hdsjulian/sparkles/sparkles-api/protocol.md

# Sparkles Serial Protocol

Bidirectional JSON frames over USB CDC serial (`/dev/ttyACM0`, 115200 baud).
Each frame is a single line of JSON terminated by `\n`.

---

## Pi → ESP32 (Commands)

Every command frame has at minimum `{"cmd": "<name>", ...params}`.

| cmd | params | description |
|-----|---|---|
| `animate_toggle` | — | start/stop animation loop |
| `animation_off` | — | stop all animations |
| `blink` | `boardId: int` | blink one board |
| `blink_all` | — | blink all boards |
| `sync` | `index: int` | sync one board |
| `sync_all` | — | sync all boards |
| `submit_positions` | `boardId, xpos, ypos` | set board position |
| `set_time` | `year, month, day, hours, minutes, seconds` | set RTC |
| `set_sleep_time` | `hours, minutes, seconds` | schedule sleep |
| `set_sound_speed` | `mps: float` | speed of sound for turning flight times into distances, from the air temperature on the pi; kept in NVS, re-sent on every connect, answered with `sound_speed` |
| `set_speaker_delay` | `us: int` | the speaker's own delay, taken off every calibration chirp (not off latency tests); kept in NVS, re-sent by the pi on every connect, answered with `speaker_delay` |
| `set_wakeup_time` | `hours, minutes, seconds` | schedule wakeup |
| `set_midi_params` | `minVal, maxVal, minSat, maxSat, midiHue, midiSaturation, rangeMin, rangeMax, minDb, maxDb, mode, distance, distanceSwitch, distanceMode, distanceEdge` | MIDI params. `mode` 1 = MIDI, 2 = frequency. `distance` is the shimmer falloff radius in m, 0 = the calibrated max. `distanceMode` 0 = brightness, 1 = delay. `distanceEdge` (optional, 50 if missing) is the brightness at that radius in % of the centre's. Held in RAM on the master, so the pi stores them and re-sends on every connect |
| `set_darkroom_params` | `strobeMin, strobeMax, redlightMin, redlightMax, candlelightMin, candlelightMax, redLightEnabled, candleLightEnabled` | darkroom params |
| `get_address_list` | — | request address list |
| `get_midi_params` | — | request MIDI params |
| `get_darkroom_params` | — | request darkroom params |
| `get_system_info` | — | request system info |
| `health_ping` | `boardId: int` | ask one board for its vitals (`-1` = whole fleet at once) |
| `calibration_start` | — | start calibration |
| `calibration_cancel` | — | cancel calibration |
| `calibration_reset` | — | reset calibration |
| `calibration_continue` | `x: float, y: float` | continue with clap position |
| `calibration_end` | — | end calibration |
| `calibration_test` | — | test calibration |
| `calibration_calibrate` | `boardId: int` | calibrate one board |
| `dist_cal_start` | — | start distance calibration |
| `dist_cal_continue` | — | continue distance calibration |
| `dist_cal_end` | — | end distance calibration |
| `dist_cal_cancel` | — | cancel distance calibration |
| `dist_cal_abort` | — | abort distance calibration |
| `ota_update` | — | start OTA update. Send `set_ota_wifi` and `set_ota_url` first — they travel to the clients with the request |
| `ota_board` | `boardId: int` | send just this board off to update, answered with `ota_sent`. The pi's rollout uses it to keep only a few boards away at once |
| `set_ota_url` | `url: str` | where the firmware image lives, i.e. this pi |
| `set_ota_wifi` | `ssid: str, password: str` | the network clients should join for an OTA — the one the pi is currently on |
| `toggle_test_mode` | — | toggle test mode |
| `toggle_logging` | — | toggle serial logging |
| `reannounce` | — | broadcast reannounce |
| `reset_system` | — | reset system (wipes client list) |
| `factory_reset` | — | factory reset & reboot |

---

## ESP32 → Pi (Events)

Every event frame has `{"event": "<name>", ...data}`.

| event | data | description |
|---|---|---|
| `address_list` | `numDevices, addresses: [{id,address,status,batteryPercentage,distance,xpos,ypos,lastUpdateTime,timerOffset,delay}]` | full address list |
| `update_board` | same address object | single board updated — sent when it changes, no longer repeated every 5 s |
| `status` | `boards, active, animating, animation, heap, minHeap, uptime, speakerDelay, soundSpeed, dropped` | the master's one line every 5 s; `dropped` counts lines its serial queue had no room for |
| `speaker_delay` | `us: int` | reply to `set_speaker_delay` |
| `sound_speed` | `mps: float` | reply to `set_sound_speed` |
| `animate_status` | `status: bool, animation` | reply to `get_animate_status` / `animate_toggle` |
| `calibration_status` | `status: int, [clapId, clapTime]` | calibration progress |
| `distance_status` | `status: int, [clapId, clapTime]` | distance cal progress |
| `client_clap` | `clapId, boardId, clapDistance` | clap received from client |
| `chirp_distance` | `boardId, slot, distance, kept, chirps` | one board's averaged distance to a chirp spot, sent as its batch finishes; a distance calibration sends the board's `update_board` right after it, so nothing is left for the end but the `done` |
| `num_devices` | `numDevices: int` | old firmware's 5 s count, now part of `status` |
| `sync_status` | `status: str` | sync progress |
| `midi_params` | `minVal, maxVal, ...` | MIDI params response |
| `darkroom_params` | `strobeMin, strobeMax, ...` | darkroom params response |
| `system_info` | `systemTime, sleepSet, sleepIn, sleepAtH, sleepAtM, sleepAtS, sleepDuration` | system info response |
| `client_health` | `boardId, reportedId, batteryPercentage, freeHeap, minFreeHeap, uptimeS, rssi, resetReason, version` | one client's reply to `health_ping`. `rssi` is stamped by the master from the frame that carried it; a board that never answers sends nothing at all, so silence is the only signal that it is gone |
| `ota_sent` | `boardId: int, ok: bool` | reply to `ota_board`; `ok` false means the master has no address for that board |
| `test_mode` | `testMode: bool` | test mode toggled |
| `logging` | `logging: bool` | logging toggled |
| `ack` | `cmd: str, ok: bool, [msg: str]` | generic command acknowledgement |
