hdsjulian/sparkles/casing/insertflip.stl

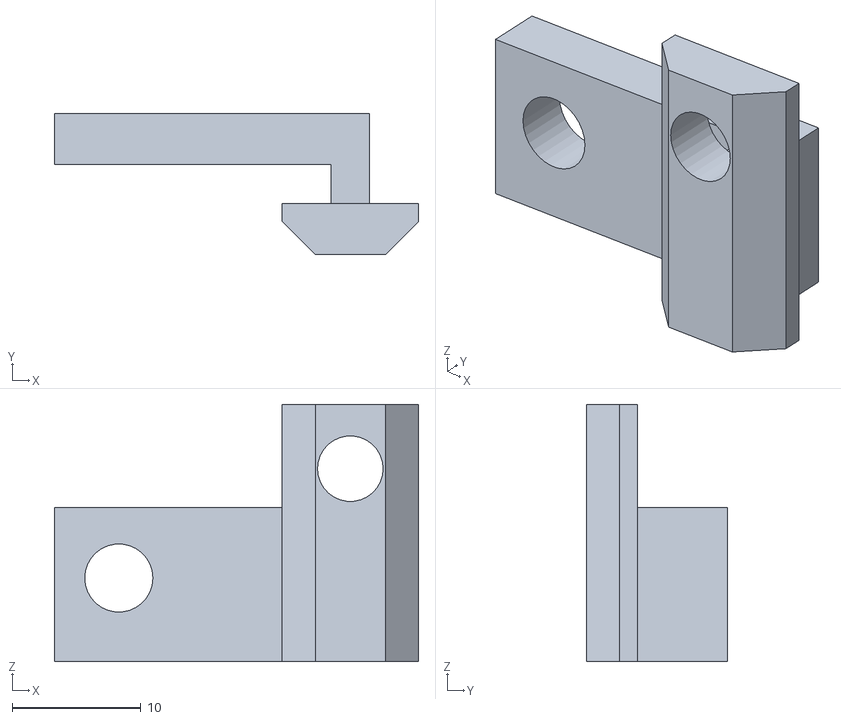
[picture p1: CAD file, 2025-11-23]
casing/insertflip.stl
28.3 x 11.0 x 20.0
