hdsjulian/sparkles/casing/base_v5.stl

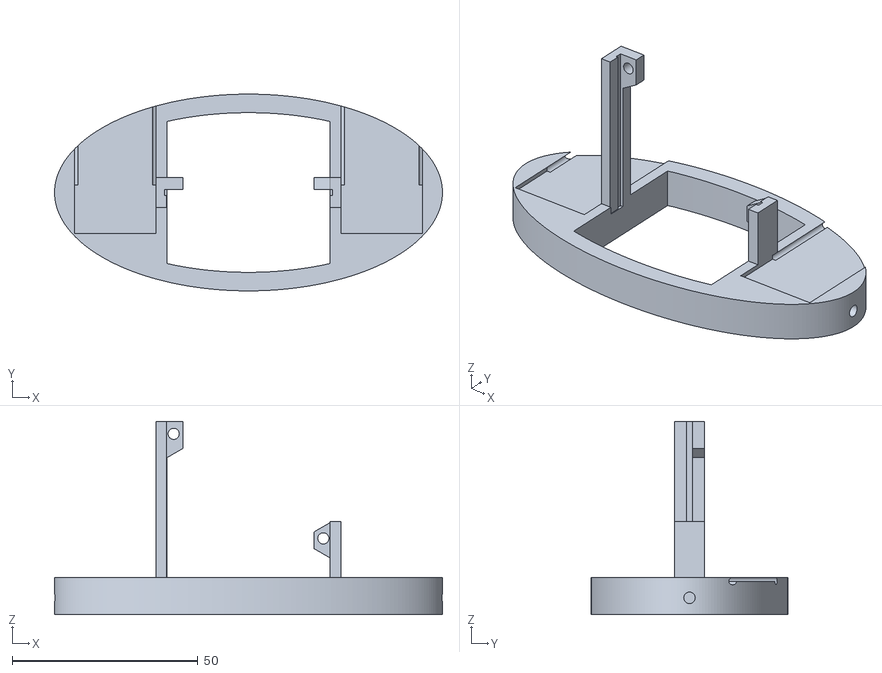
[picture p2: CAD file, 2025-11-23]
casing/base_v5.stl
104.5 x 53.0 x 52.0
