hdsjulian/sparkles/casing/battery_casing.stl

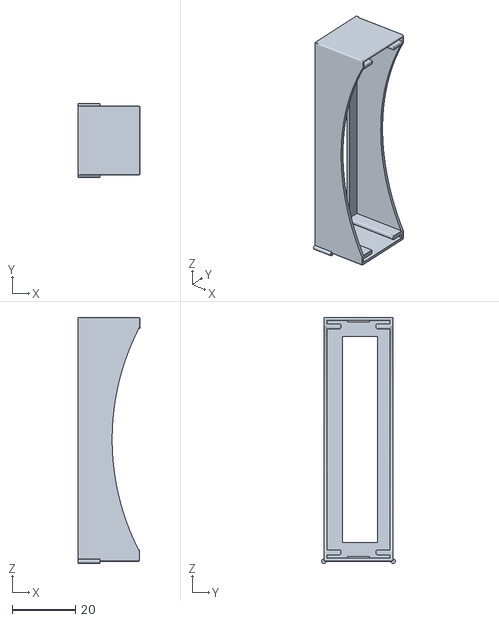
[picture p3: CAD file, 2025-08-04]
casing/battery_casing.stl
19.7 x 23.4 x 77.9
