hdsjulian/sparkles/casing/base_v4_final_2.stl

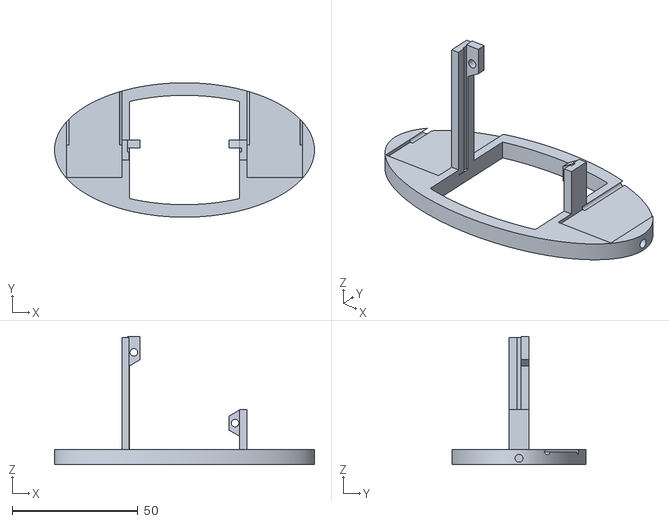
[picture p4: CAD file, 2025-08-04]
casing/base_v4_final_2.stl
103.5 x 53.5 x 51.0
