hdsjulian/sparkles/casing/wandhalterung.stl

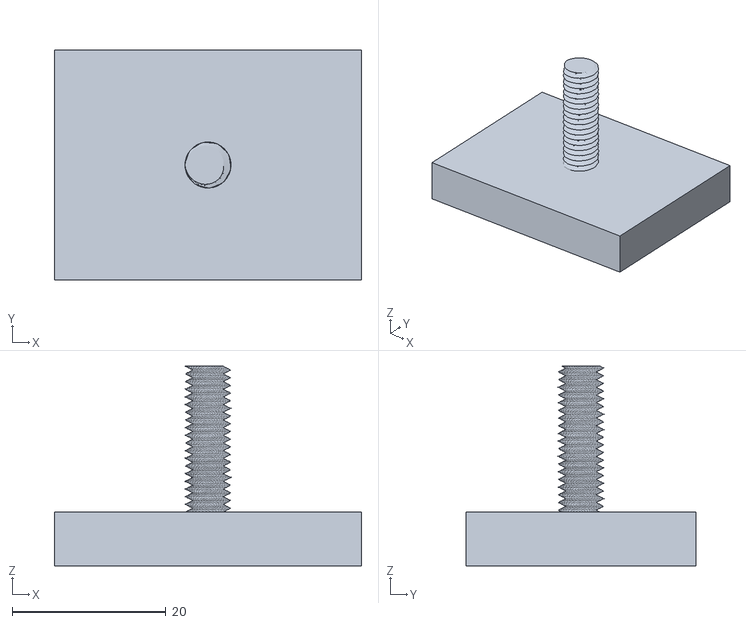
[picture p5: CAD file, 2025-08-04]
casing/wandhalterung.stl
40.0 x 30.0 x 26.0
