hdsjulian/sparkles/casing/newbase.stl

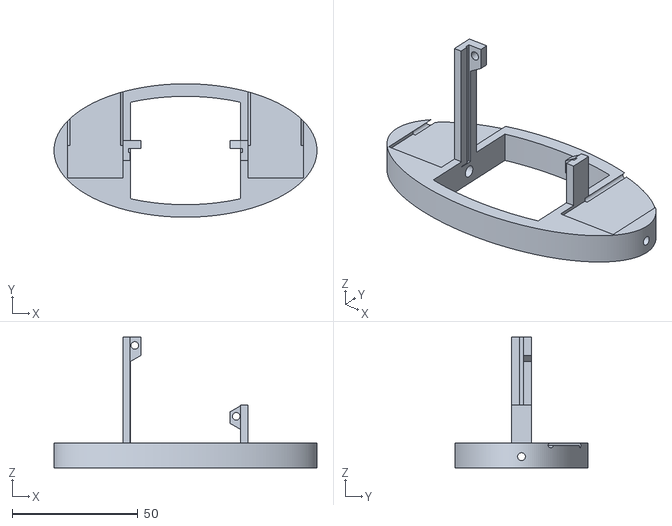
[picture p6: CAD file, 2025-08-04]
casing/newbase.stl
104.5 x 53.0 x 52.0
