hdsjulian/sparkles/casing/2h_battery_casing.3mf

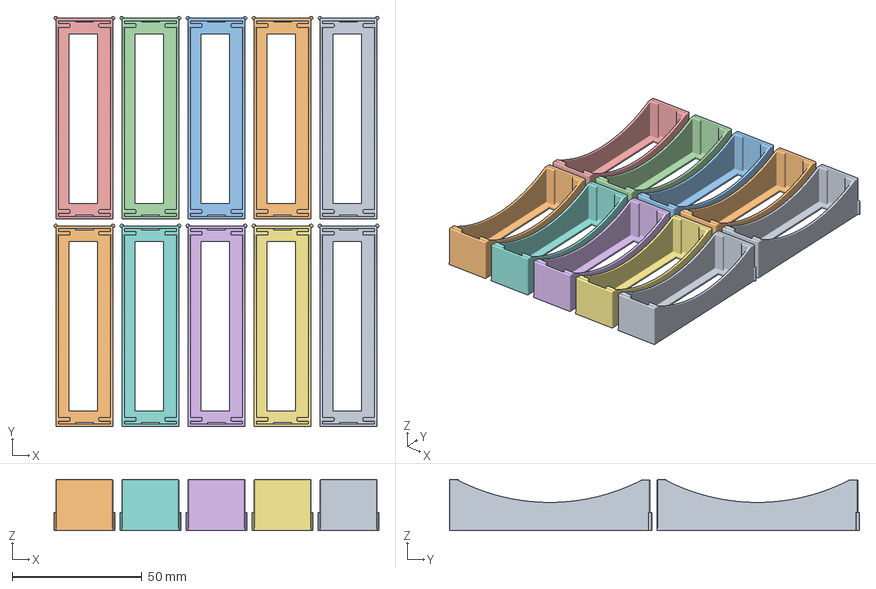
[picture p7: CAD file, 2025-08-04]
casing/2h_battery_casing.3mf
125.0 x 157.8 x 19.7 mm
battery_casing.stl 6
battery_casing.stl 9 x 2
battery_casing.stl 13 x 2
battery_casing.stl 5
battery_casing.stl 4 x 2
battery_casing.stl 11 x 2
