hdsjulian/sparkles/casing/bottom_v1.stl

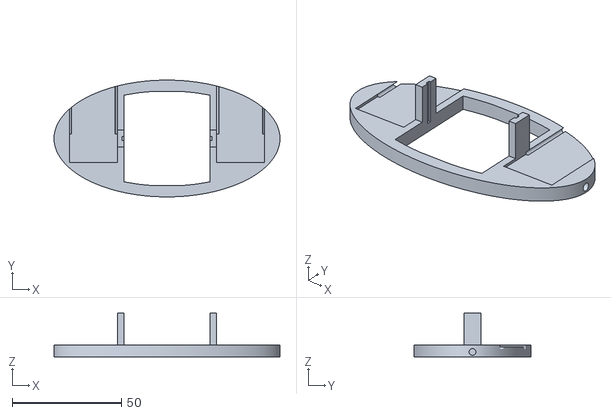
[picture p8: CAD file, 2025-08-04]
casing/bottom_v1.stl
103.5 x 53.5 x 20.0
