hdsjulian/sparkles/casing/max_battery_casing.3mf

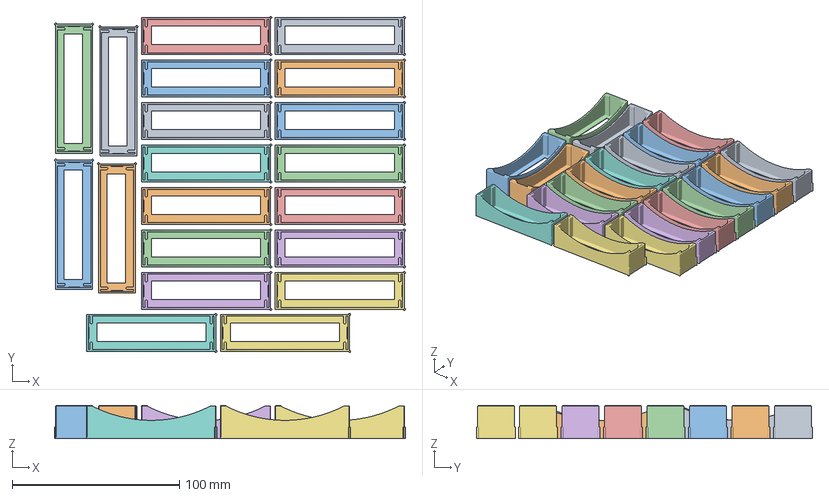
[picture p9: CAD file, 2025-08-04]
casing/max_battery_casing.3mf
209.8 x 200.9 x 19.7 mm
battery_casing.stl
battery_casing.stl 1
battery_casing.stl 2
battery_casing.stl 3
battery_casing.stl 4
battery_casing.stl 5
battery_casing.stl 6
battery_casing.stl 7
battery_casing.stl 8
battery_casing.stl 9
battery_casing.stl 10
battery_casing.stl 11
battery_casing.stl 12
battery_casing.stl 13
battery_casing.stl 14
battery_casing.stl 15 x 5
