hdsjulian/sparkles/casing/newcasing_thick.stl

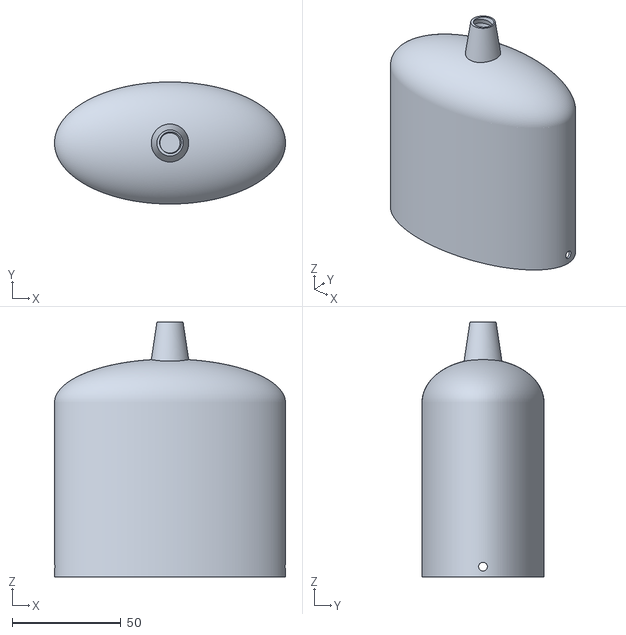
[picture p10: CAD file, 2025-08-04]
casing/newcasing_thick.stl
106.0 x 56.0 x 117.0
