hdsjulian/sparkles/casing/notch.stl

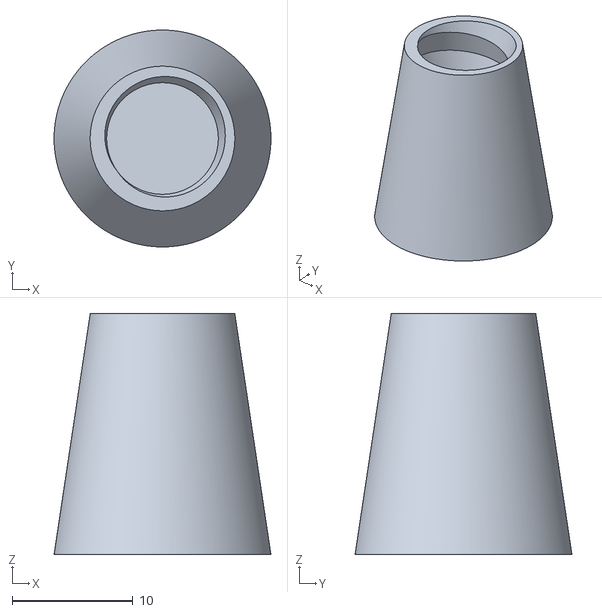
[picture p11: CAD file, 2025-08-04]
casing/notch.stl
18.0 x 18.0 x 20.0
