hdsjulian/sparkles/casing/TopV2.stl

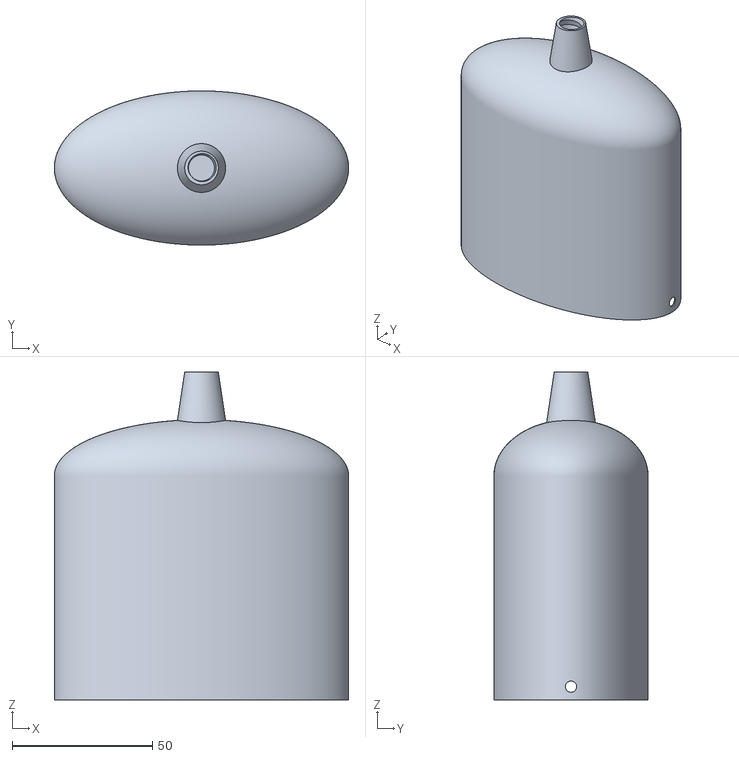
[picture p12: CAD file, 2025-08-04]
casing/TopV2.stl
105.0 x 55.0 x 117.0
