hdsjulian/sparkles/casing/notchtest.stl

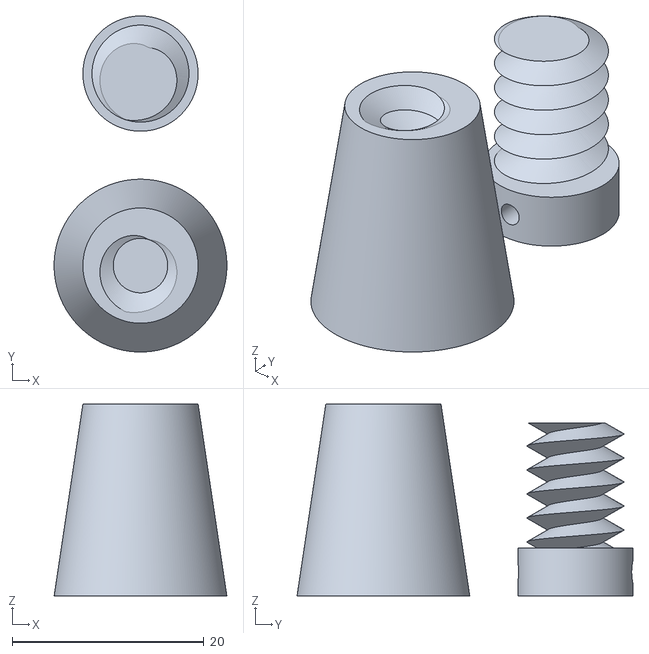
[picture p13: CAD file, 2025-08-04]
casing/notchtest.stl
18.0 x 35.0 x 20.0
