hdsjulian/sparkles/casing/cover_new.stl

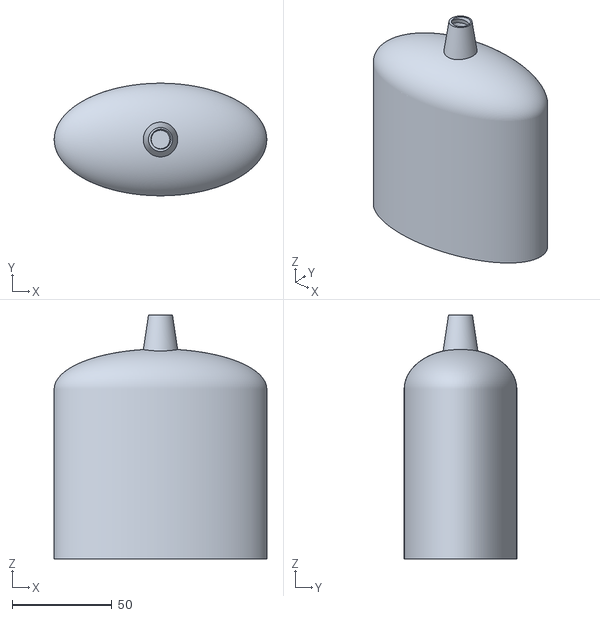
[picture p14: CAD file, 2025-08-04]
casing/cover_new.stl
106.3 x 56.3 x 122.0
