hdsjulian/sparkles/casing/casingtest.stl

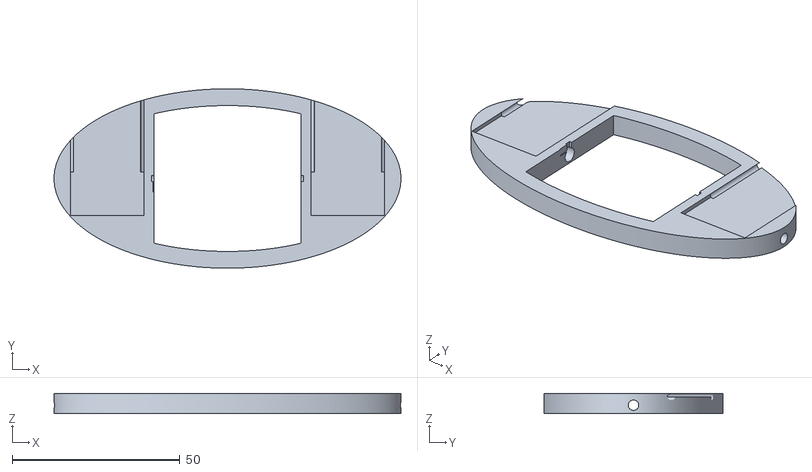
[picture p15: CAD file, 2025-08-04]
casing/casingtest.stl
103.5 x 53.5 x 6.00
