hdsjulian/sparkles/casing/casingsmallertest.stl

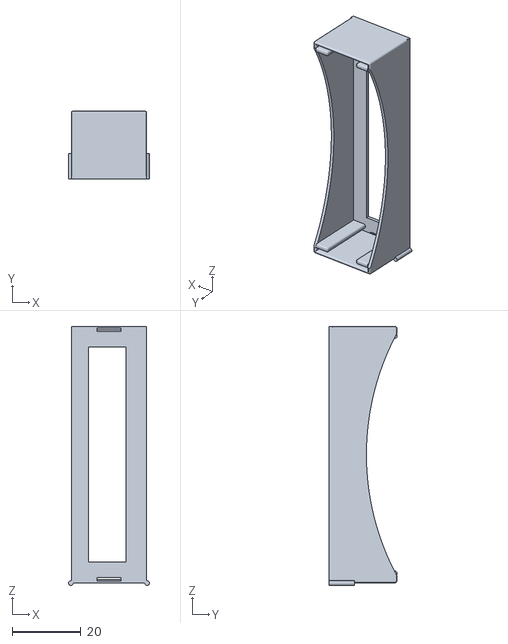
[picture p16: CAD file, 2025-08-04]
casing/casingsmallertest.stl
23.6 x 19.7 x 75.5
