hdsjulian/sparkles/casing/newcasing.stl

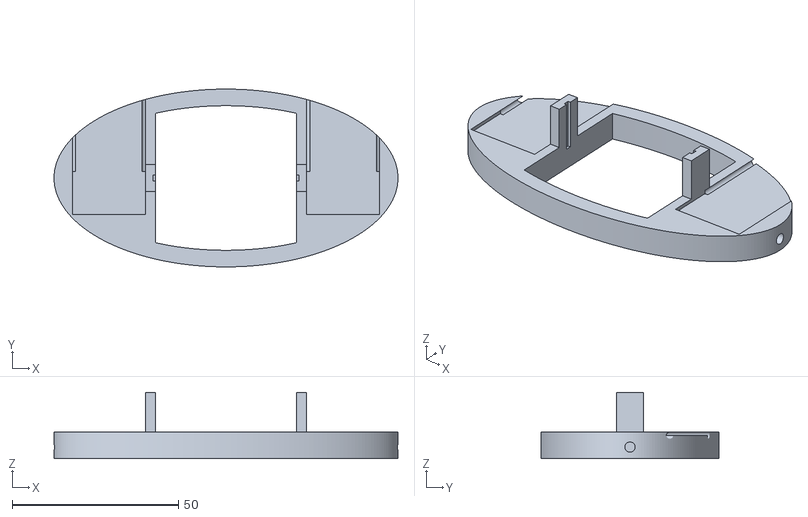
[picture p17: CAD file, 2025-08-04]
casing/newcasing.stl
103.5 x 53.5 x 20.0
