hdsjulian/sparkles/casing/base_v4_test.stl

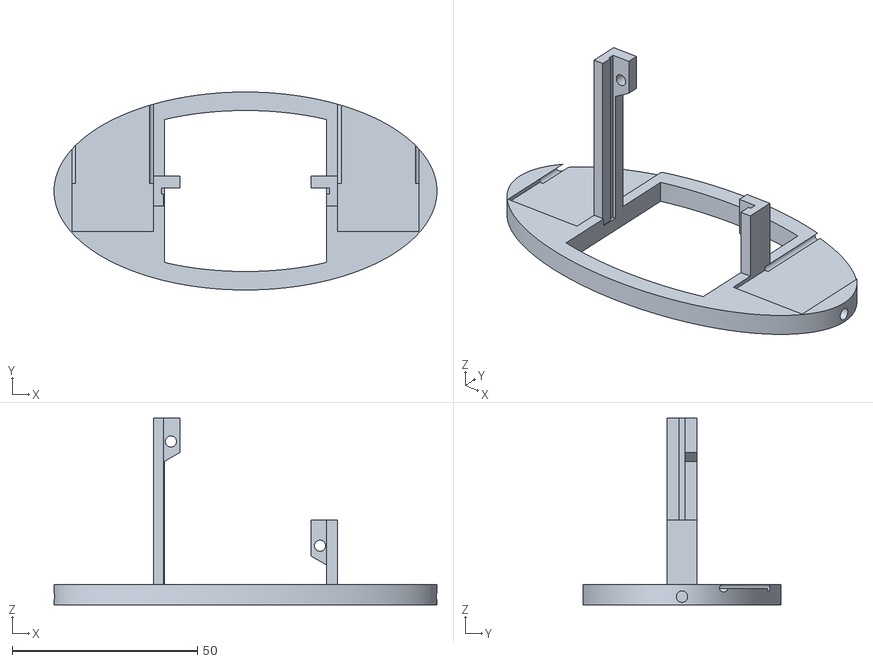
[picture p19: CAD file, 2025-08-04]
casing/base_v4_test.stl
103.5 x 53.5 x 50.5
