hdsjulian/sparkles/casing/carrier.stl

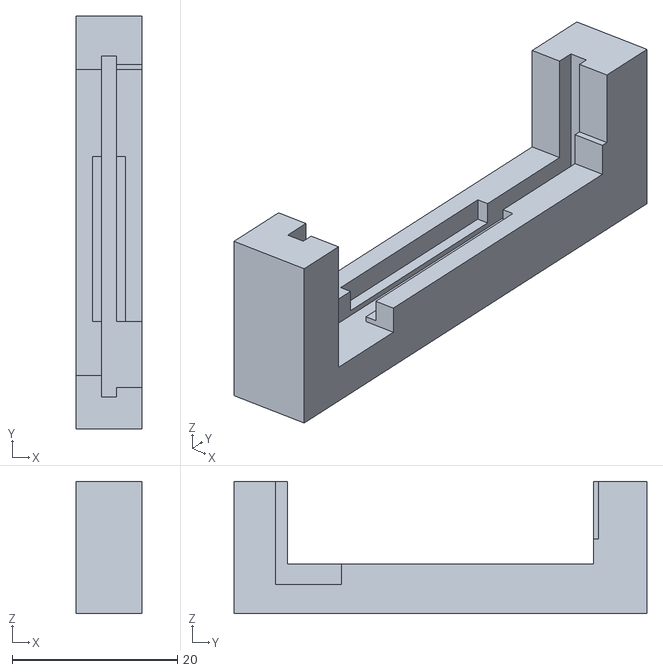
[picture p20: CAD file, 2025-08-04]
casing/carrier.stl
8.00 x 50.0 x 16.0
