hdsjulian/sparkles/casing/gehaeuse.stl

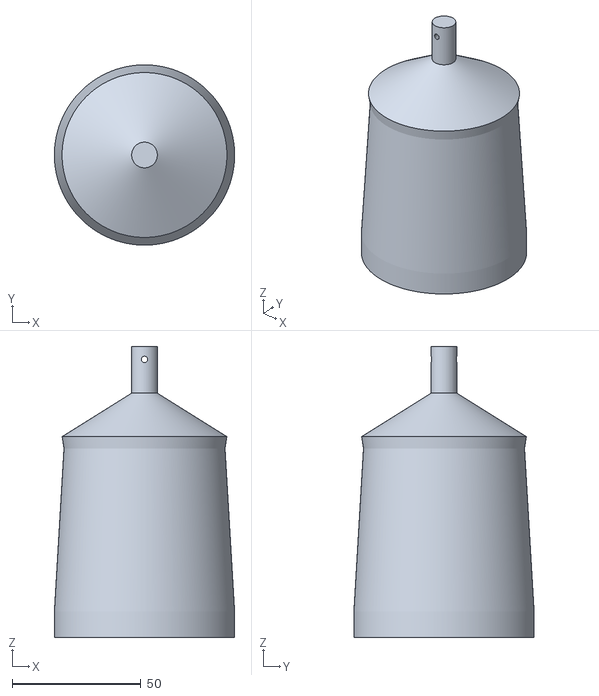
[picture p21: CAD file, 2025-08-04]
casing/gehaeuse.stl
70.0 x 70.0 x 113.0
