hdsjulian/sparkles/casing/screw.scad

include <cyl_head_bolt.scad>;
$fn=60;		    
screw("M3x12");    
