hdsjulian/sparkles/casing/wandhalterung.scad

include <cyl_head_bolt.scad>;

$width = 40;
$height = 30;
$screw_height = 25;

screw("M6x15");
