hdsjulian/sparkles/(list of files, cad)

Other CAD files:
casing/insert.stl
casing/newbase_smaller.stl
casing/battery_casing_smaller.stl
casing/base.stl
casing/base_v2.stl
casing/base_v3.stl
casing/base_v3_test.stl
casing/base_v4.stl
casing/bottom_v3_screwhole.stl
casing/cyl_head_bolt.scad
casing/data-access.scad
casing/data-metric_cyl_head_bolts.scad
casing/m3screw.stl
casing/materials.scad
casing/roundedcube.scad
casing/screw.stl
casing/screw_v2.stl
casing/threads.scad
