hdsjulian/sparkles/(threads)

Thread 2 (2023-08-25):

Figure out the finalized BOM list

hdsjulian, 2023-08-25:
So far:
- 1 large LED for each side
- Pin headers to attach an ESP board (final board needs to be set)
- 2 pin JST connector (for battery)
- switch (turn on device)
- smd microphone
- lipo charging infrastructure (what is needed?)
- MAYBE: button (switch modes?)

Thread 3 (2023-08-25):

PCB Design (technical)

hdsjulian, 2023-08-25:
Design PCB.
Requirements:

- Has one LED on each side
- Has pin-headers on back side to attach an ESP Board (which one needs to be finalized)
- has SMD microphone on front side
- Has switch on side of the pcb
- has two notches (distance 16.5mm) that allows the board to be set on model rails (H0) for charging

Closed 2024-01-26.

Thread 8 (2023-08-27):

Figure out which LED

hdsjulian, 2023-08-27:
Optimally; One LED on each side, largest possible angle. As much 'bang for a buck' as possible, meaning that more wattage equals better.
As we basically only have to run 3 or 4 channels (RGB/RGBW, both LEDs run with the same signal, but in different directions) we don't need an on board PWM chip but can rather do PWM ourselves, which allows us to get LEDs with more wattage.

Closed 2024-01-26.

Thread 10 (2024-01-26):

Changes to the PCB

hdsjulian, 2024-01-26:
The PCB needs multiple changes for V2

hdsjulian, 2024-02-13:
MOSFETs are just fine. i miscalculated and thought i was using 15 when i was using 90.

Thread 11 (2024-02-27):

Changes to the PCB (Schneider edition)

hdsjulian, 2024-02-27:
[ ] Why not use a 4 layer pcb that has two ground planes in the middle and nice broad lines for power? Probably not that more expensive and would benefit stability and wifi.
[ ]  Connect the ground planes with VIAs
[ ] BAT+, VBAT (and VDD) are way too thin
[ ] Decide whether to actually do cell protection on the board or leave this to the battery
[ ]  The charging regulator has a very long and thin line to the battery
[ ] Build something to measure the battery voltage, so that you can see what the batteries are doing, maybe just attach VDD_REF to the ADC
[ ]  Make sure those LEDs are being cooled
[ ]  C1 should be 47 uF
[ ]  That switch might not be strong enough. According to spec it is maximally 1A.
[ ]  The board will be using .15 mA no matter what the ESP32 is doing. just FYI
[ ]  The ESP wants more free space around the antenna. Best is probably that the antenna actually pops out of the PCB
[ ]  U6 has an unconnected pad. thats probably for cooling and should connect to a copper plane
[ ] C5, C6: The package (0603) ist too small for the capacities (470 uF, 100 uF)

Thread 14 (2024-08-04):

Idea: Midi

hdsjulian, 2024-08-04:
Figure out whether to either attach a midi cable to a device or somehow build a midi-btmidi bridge
