hdsjulian/sparkles/Blinky/Blinky-B_Cu.pdf

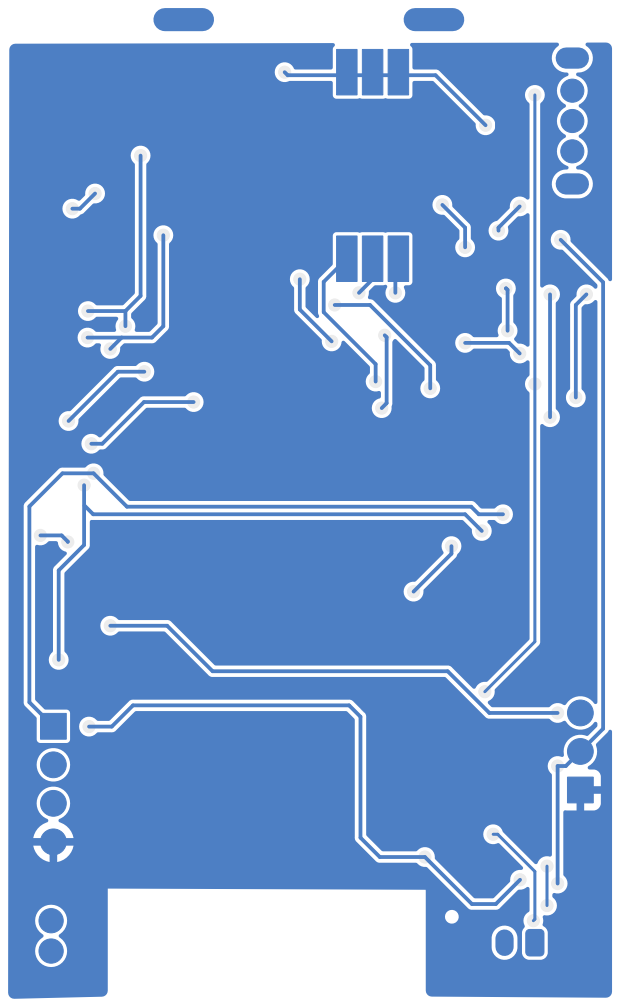
[picture p22: page 1]
