hdsjulian/sparkles/Blinky/Blinky-B_Mask.pdf

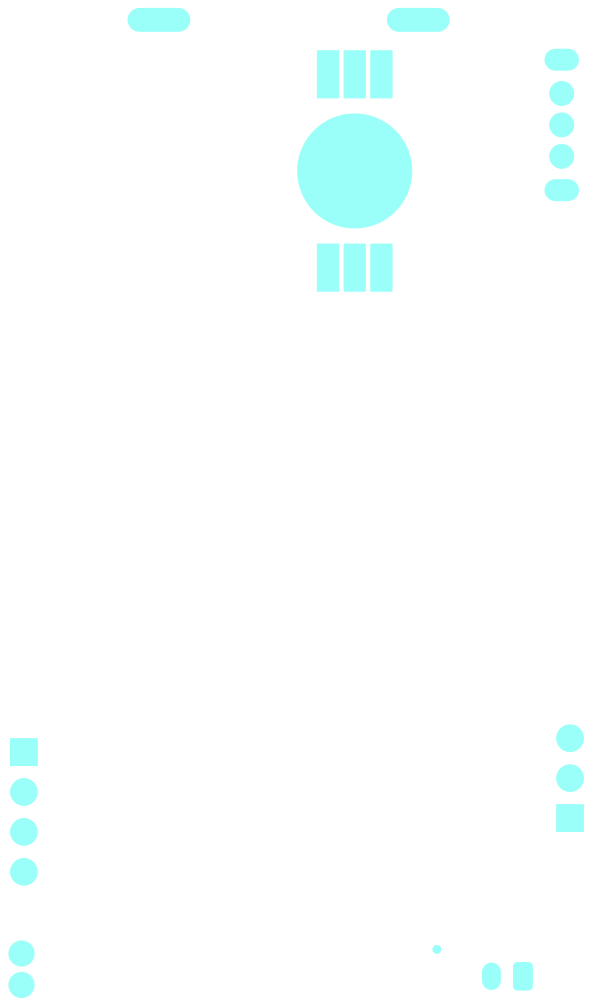
[picture p23: page 1]
