hdsjulian/sparkles/Blinky/Blinky-B_Paste.pdf

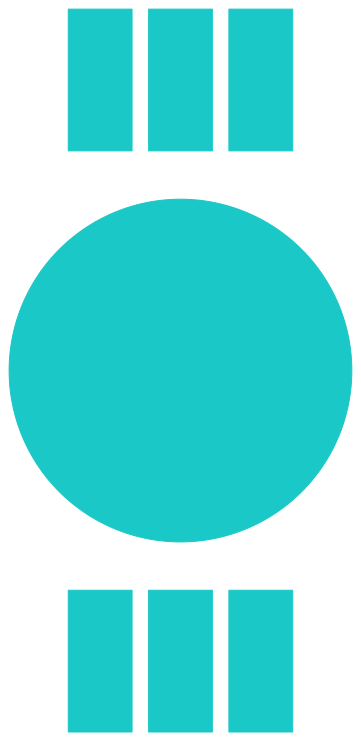
[picture p24: page 1]
