hdsjulian/sparkles/Blinky/Blinky-B_Silkscreen.pdf

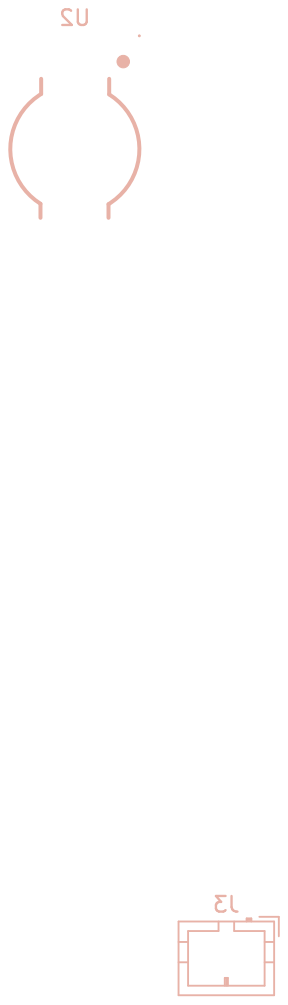
[picture p25: page 1]
