hdsjulian/sparkles/Blinky/Blinky-F_Cu.pdf

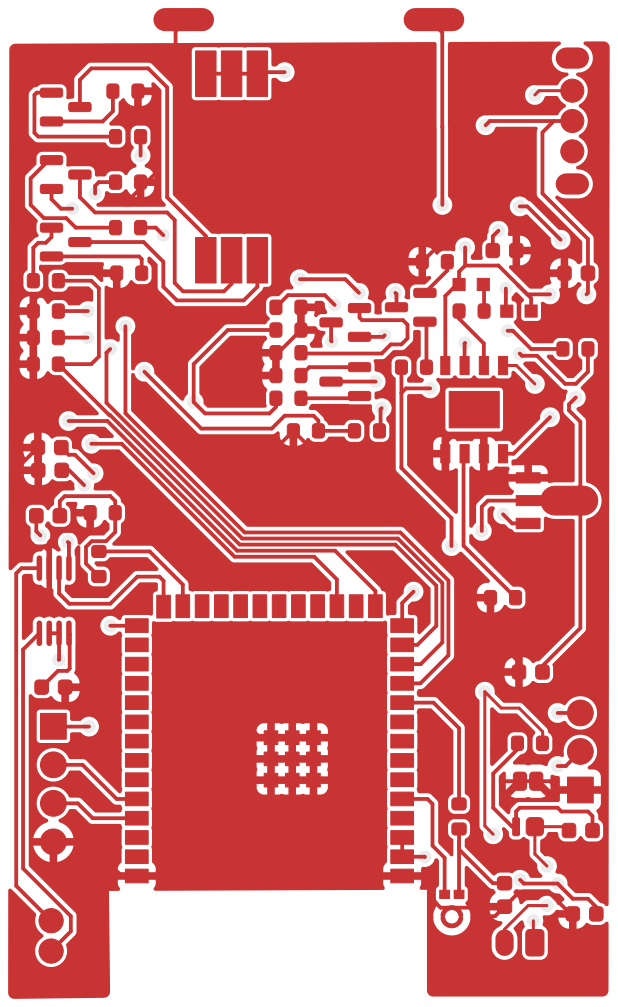
[picture p26: page 1]
