hdsjulian/sparkles/Blinky/Blinky-F_Mask.pdf

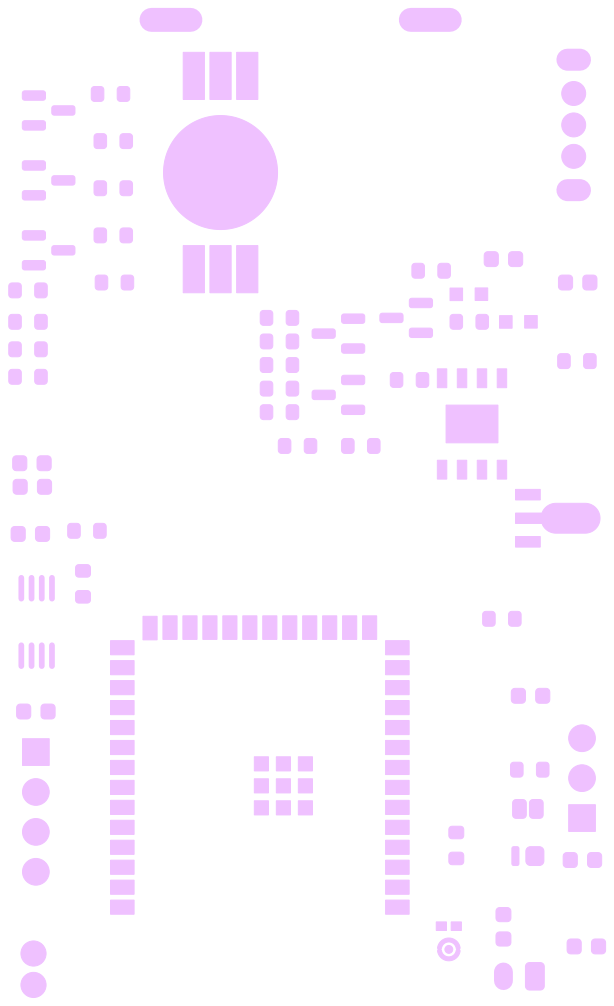
[picture p27: page 1]
