hdsjulian/sparkles/Blinky/Blinky-F_Paste.pdf

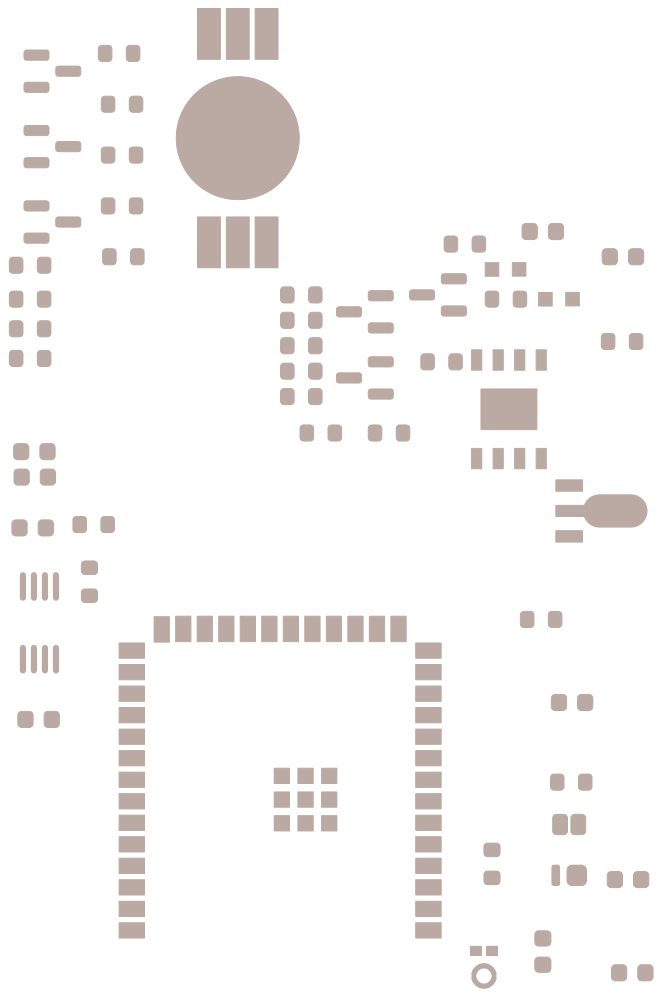
[picture p28: page 1]
