hdsjulian/sparkles/Blinky/Blinky-F_Silkscreen.pdf

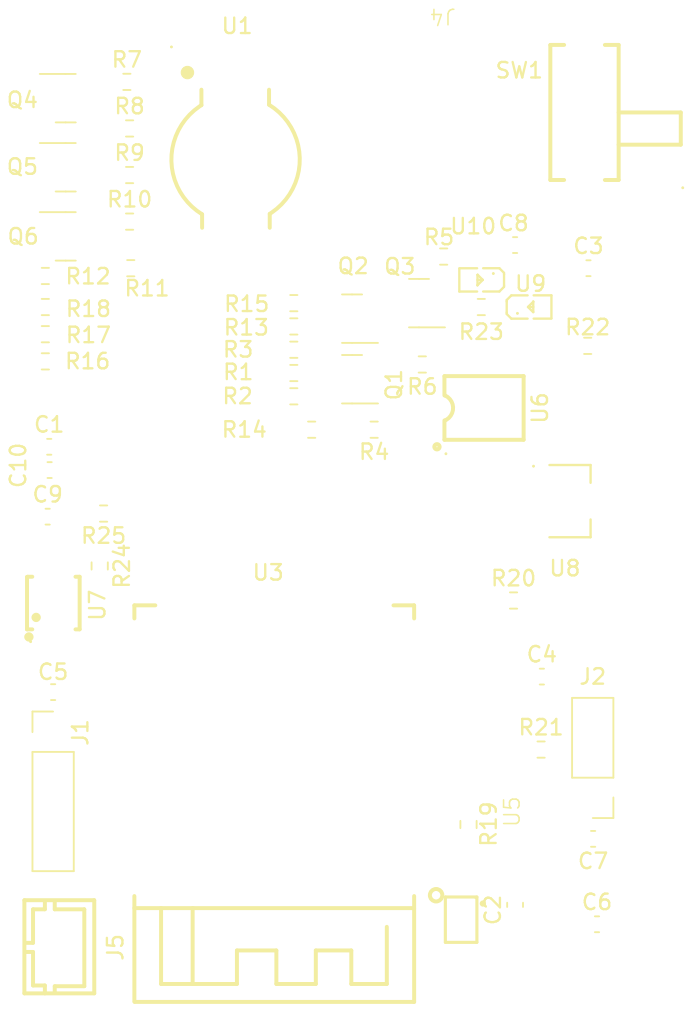
[picture p29: page 1]
