hdsjulian/sparkles/Blinky/Blinky.kicad_pcb

## KiCad design Blinky/Blinky.kicad_pcb (2025-08-04)

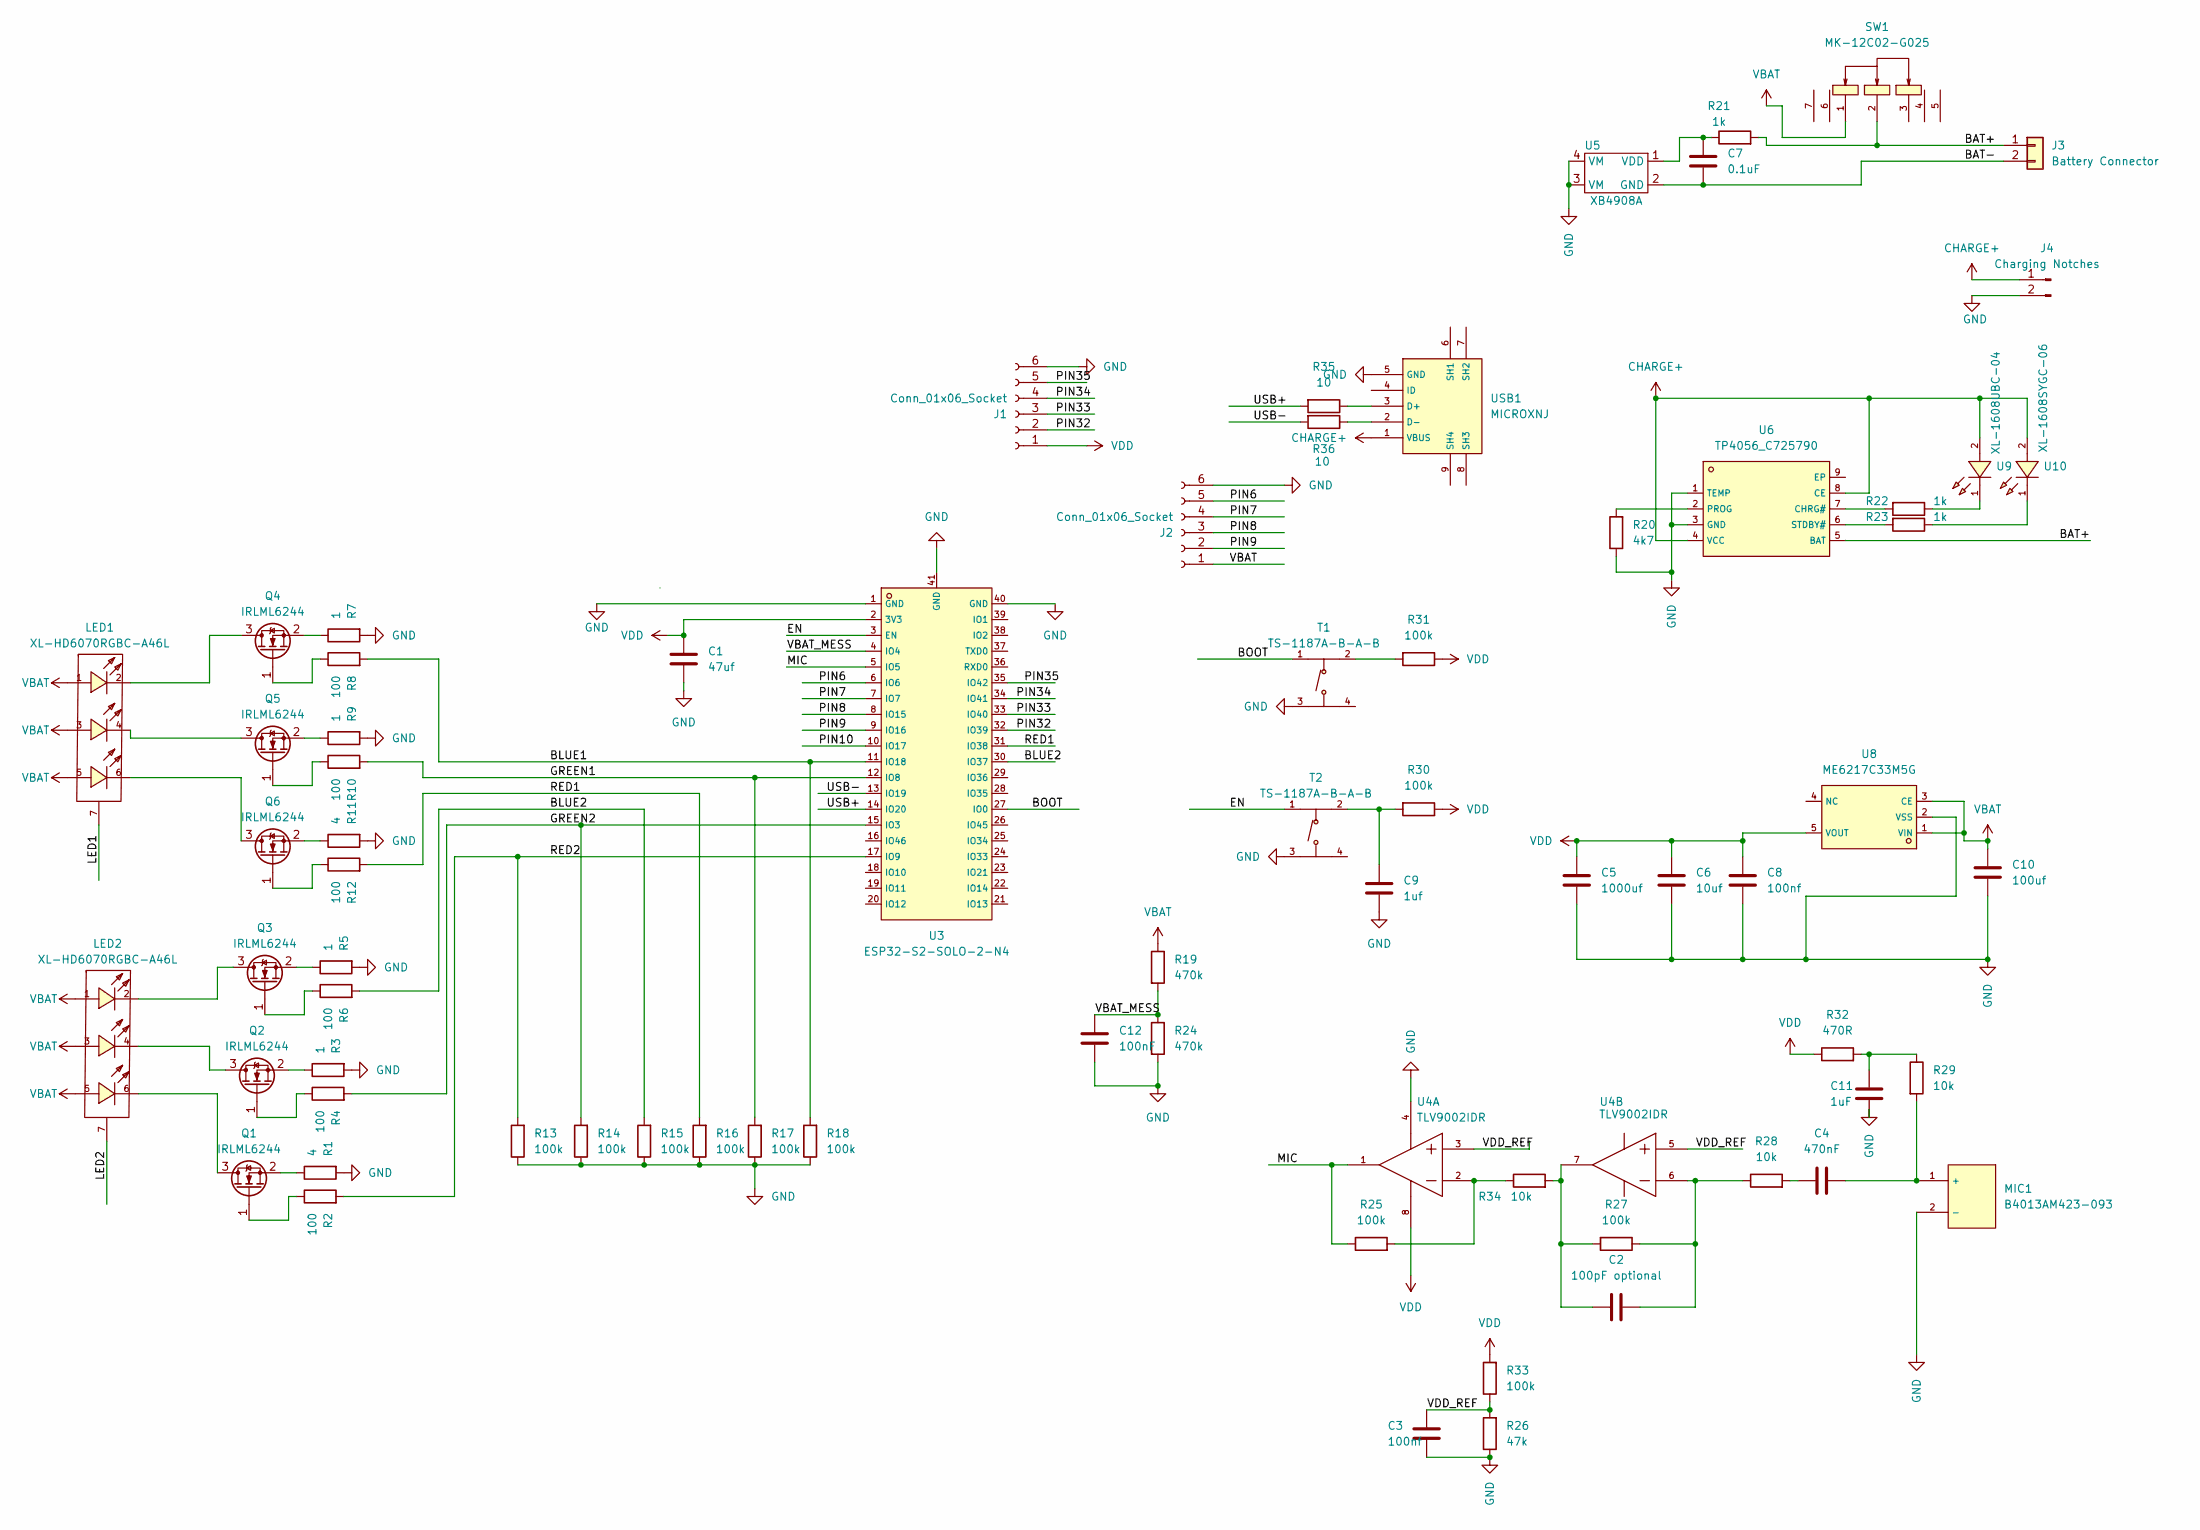
[picture p30: schematic Blinky.kicad_sch]

Parts:
C1: 47uf; C_0603_1608Metric
C2: 100pF optional; C_0603_1608Metric
C3, C8: 100nf; C_0603_1608Metric
C4: 470nF; C_0603_1608Metric
C5: 1000uf; CAP-SMD_BD8.0-L8.3-W8.3-FD
C6: 10uf; C_0603_1608Metric
C7: 0.1uF; C_0603_1608Metric
C9: 1uf; C_0603_1608Metric
C10: 100uf; CASE-B_3528
C11: 1uF; C_0603_1608Metric
C12: 100nF; C_0603_1608Metric
J1, J2: Conn_01x06_Socket; HDR-TH_6P-P2.54-V-F
J3: Battery Connector; JST_PH_B2B-PH-K_1x02_P2.00mm_Vertical
J4: Charging Notches; ChargingNotches
LED1, LED2: XL-HD6070RGBC-A46L; LED-SMD_XL-HD6070RGBC-A46L; LCSC C5349977
MIC1: B4013AM423-093; MIC-TH_BD6.0_B6027AP383-056; LCSC C233790
Q1, Q2, Q3, Q4, Q5, Q6: IRLML6244; SOT-23
R1, R11: 4; R_0603_1608Metric
R2, R4, R6, R8, R10, R12: 100; R_0603_1608Metric
R3, R5, R7, R9: 1; R_0603_1608Metric
R13, R14, R15, R16, R17, R18, R25, R27, R30, R31, R33: 100k; R_0603_1608Metric
R19, R24: 470k; R_0603_1608Metric
R20: 4k7; R_0603_1608Metric
R21, R22, R23: 1k; R_0603_1608Metric
R26: 47k; R_0603_1608Metric
R28, R29, R34: 10k; R_0603_1608Metric
R32: 470R; R_0603_1608Metric
R35, R36: 10; R_0603_1608Metric
SW1: MK-12C02-G025; SW-SMD_MK-12C02-G025; LCSC C778186
T1, T2: TS-1187A-B-A-B; SW-SMD_4P-L5.1-W5.1-P3.70-LS6.5-TL-2; LCSC C318884
U3: ESP32-S2-SOLO-2-N4; WIRELM-SMD_ESP32-S3-WROOM-1; LCSC C3040594
U4: TLV9002IDR; SOIC-8_L4.9-W3.9-P1.27-LS6.0-BL; LCSC C398360
U5: XB4908A
U6: TP4056_C725790; ESOP-8_L4.9-W3.9-P1.27-LS6.0-BL-EP; LCSC C725790
U8: ME6217C33M5G; SOT-23-5_L3.0-W1.7-P0.95-LS2.8-BR; LCSC C427602
U9: XL-1608UBC-04; LED0603-RD_BLUE; LCSC C965807
U10: XL-1608SYGC-06; LED0603-RD_GREEN; LCSC C965805
USB1: MICROXNJ; MICRO-USB-SMD_MICROXNJ; LCSC C404969

Connections:
/BAT+: J3.1, R21.2, SW1.2, U6.5 (BAT)
/BAT-: C7.2, J3.2, U5.2 (GND)
/BLUE1: R8.2, R18.2, U3.11 (IO18)
/BLUE2: R6.2, R15.2, U3.30 (IO37)
/BOOT: T1.1 (A), U3.27 (IO0)
/EN: T2.1 (A), U3.3 (EN)
/GREEN1: R10.2, R17.2, U3.12 (IO8)
/GREEN2: R4.2, R14.2, U3.15 (IO3)
/LED1: LED1.7
/LED2: LED2.7
/MIC: R25.1, U3.5 (IO5), U4.1 (OUT1)
/PIN6: J2.5, U3.6 (IO6)
/PIN7: J2.4, U3.7 (IO7)
/PIN8: J2.3, U3.8 (IO15)
/PIN9: J2.2, U3.9 (IO16)
/PIN10: U3.10 (IO17)
/PIN32: J1.2, U3.32 (IO39)
/PIN33: J1.3, U3.33 (IO40)
/PIN34: J1.4, U3.34 (IO41)
/PIN35: J1.5, U3.35 (IO42)
/RED1: R12.2, R16.2, U3.31 (IO38)
/RED2: R2.2, R13.2, U3.17 (IO9)
/USB+: R35.2, U3.14 (IO20)
/USB-: R36.2, U3.13 (IO19)
/VBAT_MESS: C12.2, R19.2, R24.1, U3.4 (IO4)
/VDD_REF: C3.1, R26.2, R33.1, U4.3 (IN1+), U4.5 (IN2+)
CHARGE+: J4.1, U6.4 (VCC), U6.8 (CE), U9.2 (A), U10.2 (A), USB1.1 (VBUS)
GND: C1.1, C3.2, C5.2, C6.1, C8.1, C9.1, C10.2, C11.2, C12.1, J1.6, J2.6, J4.2, MIC1.2 (-), R1.2, R3.2, R5.2, R7.2, R9.2, R11.2, R13.1, R14.1, R15.1, R16.1, R17.1, R18.1, R20.1, R24.2, R26.1, T1.3 (C), T2.3 (C), U3.1 (GND), U3.40 (GND), U3.41 (GND), U4.4 (V-), U5.3 (VM), U5.4 (VM), U6.1 (TEMP), U6.3 (GND), U8.2 (VSS), USB1.5 (GND)
unnamed: C4.1, R28.2
unnamed: C11.1, R29.1, R32.2
unnamed: C4.2, MIC1.1 (+), R29.2
unnamed: LED2.6, Q1.3 (D)
unnamed: Q1.1 (G), R2.1
unnamed: Q1.2 (S), R1.1
unnamed: LED2.4, Q2.3 (D)
unnamed: Q2.1 (G), R4.1
unnamed: Q2.2 (S), R3.1
unnamed: LED2.2, Q3.3 (D)
unnamed: Q3.1 (G), R6.1
unnamed: Q3.2 (S), R5.1
unnamed: LED1.2, Q4.3 (D)
unnamed: Q4.1 (G), R8.1
unnamed: Q4.2 (S), R7.1
unnamed: LED1.4, Q5.3 (D)
unnamed: Q5.1 (G), R10.1
unnamed: Q5.2 (S), R9.1
unnamed: LED1.6, Q6.3 (D)
unnamed: Q6.1 (G), R12.1
unnamed: Q6.2 (S), R11.1
unnamed: R31.2, T1.2 (B)
unnamed: C9.2, R30.2, T2.2 (B)
unnamed: R25.2, R34.1, U4.2 (IN1-)
unnamed: C2.2, R27.1, R28.1, U4.6 (IN2-)
unnamed: C2.1, R27.2, R34.2, U4.7 (OUT2)
unnamed: C7.1, R21.1, U5.1 (VDD)
unnamed: R22.2, U6.7 (CHRG#)
unnamed: R20.2, U6.2 (PROG)
unnamed: R23.2, U6.6 (STDBY#)
unnamed: R22.1, U9.1 (K)
unnamed: R23.1, U10.1 (K)
unnamed: R35.1, USB1.3 (D+)
unnamed: R36.1, USB1.2 (D-)
VBAT: C10.1, J2.1, LED1.1, LED1.3, LED1.5, LED2.1, LED2.3, LED2.5, R19.1, SW1.1, U8.1 (VIN), U8.3 (CE)
VDD: C1.2, C5.1, C6.2, C8.2, J1.1, R30.1, R31.1, R32.1, R33.2, U3.2 (3V3), U4.8 (V+), U8.5 (VOUT)

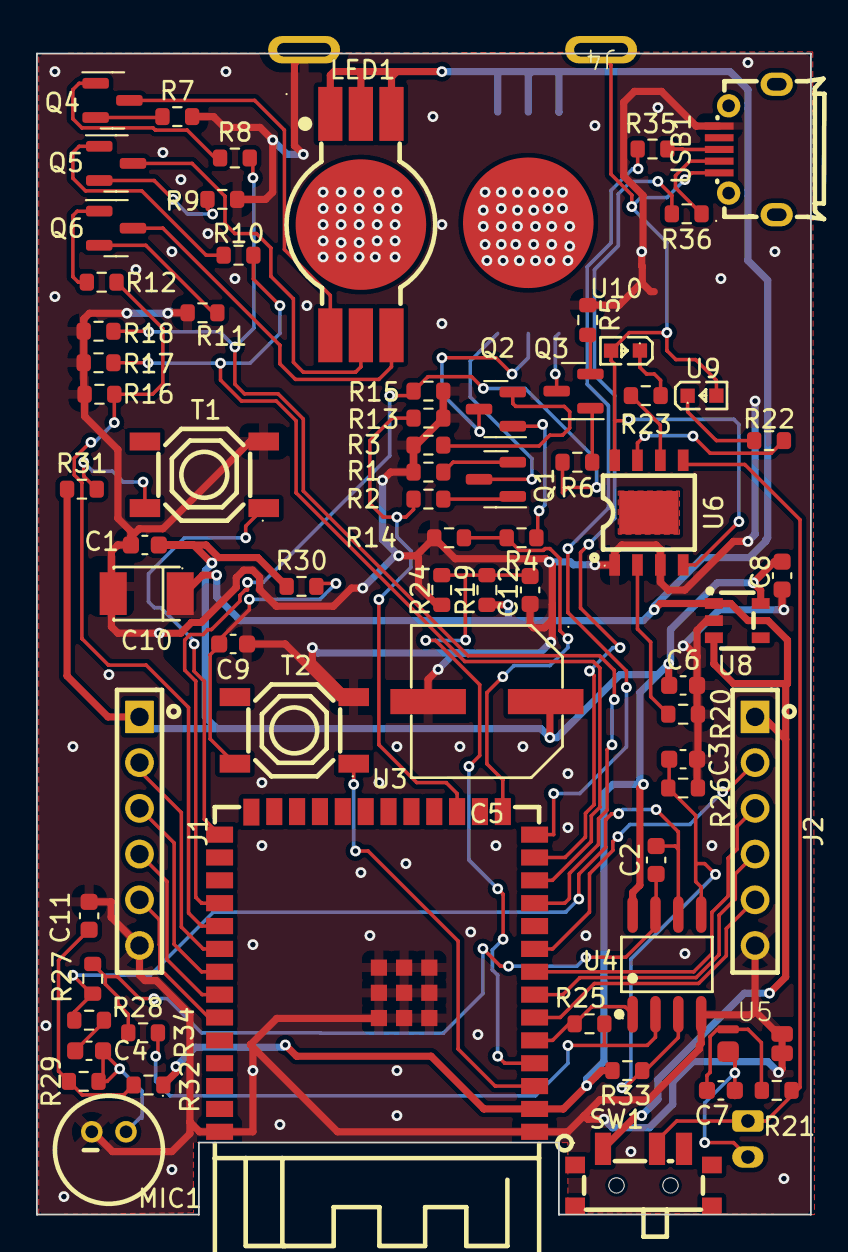
[picture p31: board Blinky.kicad_pcb from above]

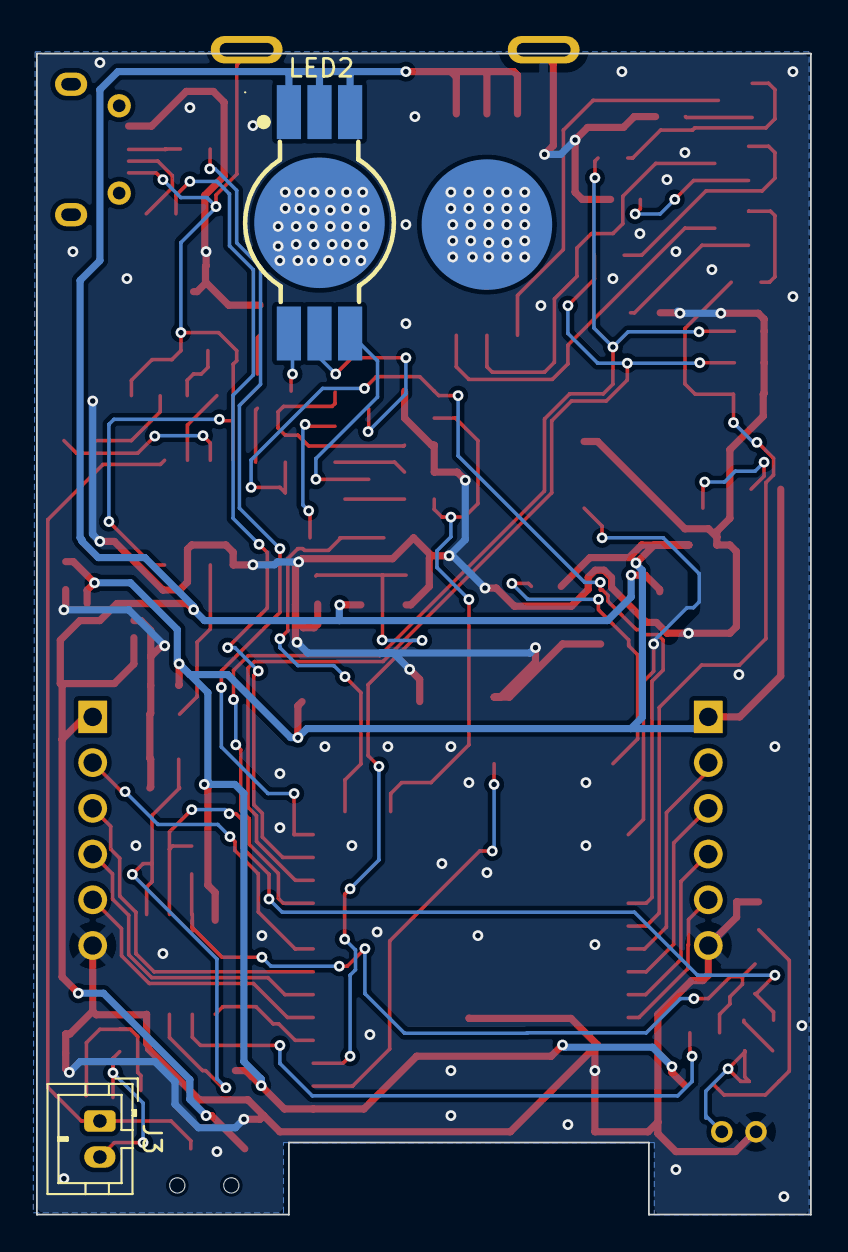
[picture p32: board Blinky.kicad_pcb from below]

Board: 2 copper layers, 43.0 x 64.5 mm, 72 parts (2 on the bottom side), 61 nets.
