hdsjulian/sparkles/sparkles-api/main.py

"""
Sparkles FastAPI server – mirrors WebServer.cpp over USB serial.

Start:  uvicorn main:app --host 0.0.0.0 --port 8080
Serial: /dev/ttyACM0  (override with SPARKLES_PORT env var)
"""

import asyncio
import hashlib
import json
import logging
import os
import shlex
import shutil
import signal
import statistics
import subprocess
import sys
import time
from contextlib import asynccontextmanager
from typing import AsyncGenerator

from fastapi import FastAPI, Query, Request, HTTPException, UploadFile, File
from fastapi.middleware.cors import CORSMiddleware
from starlette.middleware.base import BaseHTTPMiddleware
from fastapi.responses import JSONResponse, StreamingResponse, FileResponse, RedirectResponse, Response
from fastapi.staticfiles import StaticFiles
from pydantic import BaseModel

import auth
import compile as fw_compile
import mapsolve
from serial_bridge import bridge

# chirp distances collected from the mesh, fed by _map_measurement_collector
map_data = mapsolve.MapMeasurements()

logging.basicConfig(level=logging.INFO, format="%(asctime)s %(name)s %(levelname)s %(message)s")
logger = logging.getLogger("sparkles")

SERIAL_PORT   = os.environ.get("SPARKLES_PORT", "/dev/ttyACM0")
FIRMWARE_PATH = os.path.join(os.path.dirname(__file__), "firmware.bin")
_SETTINGS_PATH = os.environ.get("SPARKLES_SETTINGS", "/home/julian/sparkles/settings.json")

# Meshtastic log relay — the T-Beam (separate radio) rebroadcasts to the T-Deck
MESH_BIN     = os.environ.get("SPARKLES_MESH_BIN", "meshtastic")
MESH_PORT    = os.environ.get("SPARKLES_MESH_PORT", "")          # empty → CLI auto-detect
MESH_CHANNEL = int(os.environ.get("SPARKLES_MESH_CHANNEL", "1")) # sparkles secondary channel
MESH_BATTERY_LOW = float(os.environ.get("SPARKLES_MESH_BATTERY_LOW", "7"))  # relay a log below this %
MESH_HEAP_LOW = int(os.environ.get("SPARKLES_MESH_HEAP_LOW", "20000"))  # relay a log below this many bytes free

# ---------------------------------------------------------------------------
# App settings — persisted to JSON file
# ---------------------------------------------------------------------------
_DEFAULT_SETTINGS = {"resync_mode": "fast"}

# Latest level reported by aubioAlgo, which owns the audio device — nothing
# else can open it while it runs, so the level test is driven from what it
# already measures rather than by opening a second stream.
_audio_level = {"db": None, "pitch": 0.0, "ts": 0.0}

def _load_settings() -> dict:
    try:
        with open(_SETTINGS_PATH) as f:
            data = json.load(f)
        return {**_DEFAULT_SETTINGS, **data}
    except (FileNotFoundError, json.JSONDecodeError):
        return dict(_DEFAULT_SETTINGS)

def _save_settings(data: dict):
    os.makedirs(os.path.dirname(_SETTINGS_PATH), exist_ok=True)
    with open(_SETTINGS_PATH, "w") as f:
        json.dump(data, f, indent=2)

# Public paths that never require a token
# /getMidiParams is read by aubioAlgo, a local daemon with no session to
# authenticate with. The 401 it got instead was silent: it falls back to its
# compiled-in defaults, so every parameter set in the UI — mode included — was
# quietly ignored and the pitch detector always ran in frequency mode.
# /firmware.bin is fetched by the boards themselves during an OTA, and they have
# no session either: behind the login every board got a 401 and kept its old build.
_PUBLIC_PATHS = {"/api/login", "/login", "/favicon.ico", "/", "/favicon.png", "/karaoke",
                 "/internal/keyboard_event", "/getMidiParams",
                 "/internal/aubio_level", "/firmware.bin"}
# /keyboard/ is public so the karaoke page can list and play songs without login
_PUBLIC_PREFIXES = ("/_app/", "/login", "/karaoke", "/keyboard/")


async def _serial_status_broadcaster():
    """Periodically push serial_status (including stale flag) via SSE."""
    import time
    while True:
        await asyncio.sleep(10)
        try:
            connected = bridge._serial is not None and bridge._serial.is_open
            now = time.monotonic()
            last = bridge._last_frame_time
            ref = last if last > 0 else bridge._connected_since
            stale = connected and ref > 0 and (now - ref) > 30
            bridge._dispatch({"event": "serial_status", "connected": connected, "stale": stale})
        except Exception:
            pass


def _brain_sweep_strays():
    """Kill any muse pipeline left over from a previous run of this service.

    brain_start spawns into its own process group so one stop can take the
    whole pipeline down — but that also means a service restart orphans it
    rather than killing it. The orphan keeps the headband connected forever,
    and the new instance knows nothing about it, so the next session sits at
    "waiting for the headband" against a headband that is very much in use."""
    for name in ("muse.py", "muse_bridge.py"):
        try:
            subprocess.run(["pkill", "-f", os.path.join(_MUSE_DIR, name)], timeout=5)
        except Exception as exc:
            logger.debug("stray sweep for %s: %s", name, exc)


@asynccontextmanager
async def lifespan(app: FastAPI):
    auth.bootstrap()
    _brain_sweep_strays()
    loop = asyncio.get_event_loop()
    bridge._port = SERIAL_PORT
    try:
        bridge.start(loop)
    except Exception as exc:
        logger.warning("Could not open serial port %s: %s – running in offline mode", SERIAL_PORT, exc)
    asyncio.create_task(_serial_status_broadcaster())
    asyncio.create_task(_battery_low_watcher())
    asyncio.create_task(_heap_low_watcher())
    asyncio.create_task(_mesh_event_watcher())
    asyncio.create_task(_map_measurement_collector())
    if _brain_config["listening"]:
        _brain_listen()
    yield
    # Take the pipeline with us: systemd sends SIGTERM here, and without this
    # the headband stays held by a process nothing is tracking any more.
    # Listening stays on in brain.json, so the next start picks it up again.
    task = _brain["task"]
    if task and not task.done():
        task.cancel()
        try:
            await asyncio.wait_for(task, timeout=8)
        except (asyncio.CancelledError, asyncio.TimeoutError):
            pass
    if _brain_running():
        try:
            os.killpg(os.getpgid(_brain["proc"].pid), signal.SIGTERM)
        except Exception as exc:
            logger.warning("could not stop the muse pipeline: %s", exc)
    bridge.stop()


app = FastAPI(title="Sparkles API", lifespan=lifespan)
app.add_middleware(
    CORSMiddleware,
    allow_origins=["*"],
    allow_methods=["*"],
    allow_headers=["*"],
)


class AuthMiddleware(BaseHTTPMiddleware):
    async def dispatch(self, request: Request, call_next):
        path = request.url.path

        # always allow public paths
        if path in _PUBLIC_PATHS or any(path.startswith(p) for p in _PUBLIC_PREFIXES):
            return await call_next(request)

        user = auth.get_current_user(request)
        accepts_html = "text/html" in request.headers.get("accept", "")

        if user is None:
            if accepts_html:
                return RedirectResponse("/", status_code=302)
            return JSONResponse({"detail": "Not authenticated"}, status_code=401)

        role = user.get("role", "")

        # static page access check
        if accepts_html or path == "/" or "." not in path.split("/")[-1]:
            if not auth.check_page_access(path, role):
                if accepts_html:
                    return RedirectResponse("/login", status_code=302)
                return JSONResponse({"detail": "Forbidden"}, status_code=403)
        else:
            # API / asset access check
            if not auth.check_api_access(path, request.method, role):
                return JSONResponse({"detail": "Forbidden"}, status_code=403)

        return await call_next(request)


app.add_middleware(AuthMiddleware)

# ---------------------------------------------------------------------------
# Helpers
# ---------------------------------------------------------------------------

def _assert_connected():
    if not bridge.is_connected:
        raise HTTPException(503, detail="Master not connected — serial bridge is down")


def _send(payload: dict):
    _assert_connected()
    bridge.send(payload)
    _announce_animation(payload)


def _ok(msg: str = "OK"):
    return JSONResponse({"status": True, "msg": msg})


async def _request(cmd: dict, event: str, timeout: float = 4.0):
    _assert_connected()
    result = await bridge.request(cmd, event, timeout)
    if result is None:
        raise HTTPException(504, detail=f"No response from device (timeout waiting for '{event}')")
    return result


# ---------------------------------------------------------------------------
# Auth  /api/login  /api/logout  /api/me
# ---------------------------------------------------------------------------

class LoginRequest(BaseModel):
    username: str
    password: str


@app.post("/api/login")
async def login(body: LoginRequest):
    role = auth.authenticate(body.username, body.password)
    if role is None:
        raise HTTPException(401, detail="Invalid credentials")
    token = auth.create_token(body.username, role)
    response = JSONResponse({"status": True, "role": role, "username": body.username})
    response.set_cookie(
        auth.COOKIE_NAME, token,
        httponly=True, samesite="lax", max_age=60 * 60 * 24 * 7,
    )
    return response


@app.post("/api/logout")
async def logout():
    response = JSONResponse({"status": True})
    response.delete_cookie(auth.COOKIE_NAME)
    return response


@app.get("/api/me")
async def me(request: Request):
    user = auth.get_current_user(request)
    if user is None:
        raise HTTPException(401, detail="Not authenticated")
    cfg = auth.load_config()
    page_rules = cfg.get("access", {}).get("pages", {})
    allowed_pages = [
        p for p in page_rules
        if p != "*" and auth.check_page_access(p, user["role"])
    ]
    return {"username": user["sub"], "role": user["role"], "allowedPages": allowed_pages}


# ---------------------------------------------------------------------------
# SSE  /events
# ---------------------------------------------------------------------------

@app.get("/events")
async def sse_events(request: Request) -> StreamingResponse:
    queue = bridge.subscribe()

    async def generator() -> AsyncGenerator[str, None]:
        try:
            while True:
                if await request.is_disconnected():
                    break
                try:
                    frame = await asyncio.wait_for(queue.get(), timeout=15)
                    event_name = frame.get("event", "message")
                    data = json.dumps(frame)
                    yield f"event: {event_name}\ndata: {data}\n\n"
                except asyncio.TimeoutError:
                    yield ": keep-alive\n\n"
        finally:
            bridge.unsubscribe(queue)

    return StreamingResponse(generator(), media_type="text/event-stream",
                             headers={"Cache-Control": "no-cache", "X-Accel-Buffering": "no"})


# ---------------------------------------------------------------------------
# Serial log SSE  /serialLog
# ---------------------------------------------------------------------------

@app.get("/serialLog")
async def serial_log(request: Request) -> StreamingResponse:
    snapshot, queue = bridge.subscribe_log()

    async def generator() -> AsyncGenerator[str, None]:
        # send buffered lines first
        for line in snapshot:
            yield f"event: serial_log\ndata: {json.dumps(line)}\n\n"
        try:
            while True:
                if await request.is_disconnected():
                    break
                try:
                    line = await asyncio.wait_for(queue.get(), timeout=15)
                    yield f"event: serial_log\ndata: {json.dumps(line)}\n\n"
                except asyncio.TimeoutError:
                    yield ": keep-alive\n\n"
        finally:
            bridge.unsubscribe_log(queue)

    return StreamingResponse(generator(), media_type="text/event-stream",
                             headers={"Cache-Control": "no-cache", "X-Accel-Buffering": "no"})


# ---------------------------------------------------------------------------
# Meshtastic log relay → T-Beam → T-Deck (sparkles channel)
# ---------------------------------------------------------------------------

_mesh_lock = asyncio.Lock()  # one meshtastic CLI talking to the radio at a time


async def _mesh_send(text: str, channel_index: int) -> str:
    """Send a text message out via the T-Beam radio using the meshtastic CLI."""
    if shutil.which(MESH_BIN) is None and not os.path.isfile(MESH_BIN):
        raise HTTPException(503, detail=f"meshtastic CLI not found ('{MESH_BIN}') — install it on the API host")

    args = [MESH_BIN]
    if MESH_PORT:
        args += ["--port", MESH_PORT]
    args += ["--sendtext", text, "--ch-index", str(channel_index)]

    async with _mesh_lock:
        proc = await asyncio.create_subprocess_exec(
            *args, stdout=asyncio.subprocess.PIPE, stderr=asyncio.subprocess.STDOUT)
        try:
            out, _ = await asyncio.wait_for(proc.communicate(), timeout=30)
        except asyncio.TimeoutError:
            proc.kill()
            raise HTTPException(504, detail="meshtastic send timed out (radio busy or unplugged?)")

    output = out.decode(errors="replace")
    if proc.returncode != 0 or "Sending text" not in output:
        raise HTTPException(502, detail=f"meshtastic send failed: {output.strip()[-300:]}")
    return text


class LogMessage(BaseModel):
    message: str
    level: str | None = None         # optional tag, e.g. "INFO" → prefixes the text
    channelIndex: int | None = None  # override the default sparkles channel


@app.post("/log")
async def send_log(body: LogMessage):
    """Relay an arbitrary log message over Meshtastic to the T-Deck."""
    text = body.message if not body.level else f"[{body.level}] {body.message}"
    text = text.encode()[:200].decode(errors="ignore")  # meshtastic text payload limit
    if not text:
        raise HTTPException(422, detail="message is empty")
    ch = body.channelIndex if body.channelIndex is not None else MESH_CHANNEL
    sent = await _mesh_send(text, ch)
    logger.info("mesh log → ch%d: %s", ch, sent)
    return _ok(sent)


# animations worth announcing on the T-Deck — excludes background shimmer (per
# request) and MIDI (streamed continuously, never sent as a discrete command)
_ANIMATION_CMDS = {
    "animate_toggle", "blink", "blink_all", "blink_battery_all",
    "strobe_all", "bioluminescence", "breath", "candle_all", "hearth",
}


def _announce_animation(payload: dict):
    """Fire-and-forget a T-Deck log when an animation command is triggered."""
    cmd = payload.get("cmd", "")
    if cmd not in _ANIMATION_CMDS:
        return

    async def _task():
        try:
            await _mesh_send(f"🎬 animation: {cmd}", MESH_CHANNEL)
        except Exception as exc:
            logger.warning("animation relay failed for %s: %s", cmd, exc)

    try:
        asyncio.get_running_loop().create_task(_task())
    except RuntimeError:
        pass  # not called from the event loop — skip


async def _battery_low_watcher():
    """Relay a log to the T-Deck when a board's battery dips below MESH_BATTERY_LOW.

    Edge-triggered: fires once when a board crosses the threshold, re-arms when
    it recovers — so a steady stream of update_board frames won't spam the radio.
    """
    queue = bridge.subscribe()
    low: set[int] = set()
    try:
        while True:
            frame = await queue.get()
            if frame.get("event") != "update_board":
                continue
            cid = frame.get("id")
            bat = frame.get("batteryPercentage")
            if cid is None or not isinstance(bat, (int, float)):
                continue
            if bat < MESH_BATTERY_LOW:
                if cid not in low:
                    low.add(cid)
                    try:
                        await _mesh_send(f"⚠️ board {cid} battery low ({bat:.0f}%)", MESH_CHANNEL)
                    except HTTPException as exc:
                        logger.warning("battery-low relay failed for board %s: %s", cid, exc.detail)
            else:
                low.discard(cid)  # recovered → re-arm for the next dip
    finally:
        bridge.unsubscribe(queue)


async def _heap_low_watcher():
    """Relay a T-Deck log when the master's free heap sinks below MESH_HEAP_LOW —
    advance warning that a leak is heading for a hang, so it can be restarted
    at a convenient moment instead of dying mid-evening.

    Edge-triggered like the battery watcher: fires once on the crossing,
    re-arms when the heap recovers.
    """
    queue = bridge.subscribe()
    low = False
    try:
        while True:
            frame = await queue.get()
            # the master's status line carries it now; "heap" is the old firmware
            if frame.get("event") == "status":
                free = frame.get("heap")
            elif frame.get("event") == "heap":
                free = frame.get("free")
            else:
                continue
            if not isinstance(free, int):
                continue
            if free < MESH_HEAP_LOW:
                if not low:
                    low = True
                    try:
                        await _mesh_send(f"⚠️ master heap low ({free // 1024} KB free)", MESH_CHANNEL)
                    except Exception as exc:
                        logger.warning("heap-low relay failed: %s", exc)
            else:
                low = False  # recovered → re-arm for the next dip
    finally:
        bridge.unsubscribe(queue)


async def _map_measurement_collector():
    """Keep the chirp distance matrix for the anchor-free solve.

    The master emits one chirp_distance per board at the end of its batch's burst,
    and announces the slot it is about to measure — a re-run of a spot replaces it.
    """
    queue = bridge.subscribe()
    try:
        while True:
            frame = await queue.get()
            event = frame.get("event")
            if event == "chirp_distance":
                map_data.record(frame.get("boardId"), frame.get("slot"), frame.get("distance"))
            elif event in ("position_status", "distance_status") and frame.get("status") == "running":
                # start of a spot: not a per-chirp tick, and not a later batch of it
                if frame.get("chirp") in (0, None) and frame.get("batch") in (1, None):
                    map_data.clear_slot(frame.get("slot", 0))
    finally:
        bridge.unsubscribe(queue)


async def _mesh_event_watcher():
    """Relay notable device events to the T-Deck.

    installation_active comes from serial_bridge on the music resume edge (gap >
    SPARKLES_IDLE_RESUME); sleep_phase start/end comes from the master firmware.
    """
    queue = bridge.subscribe()
    try:
        while True:
            frame = await queue.get()
            event = frame.get("event")
            if event == "installation_active":
                text = "🎶 people are using the installation"
            elif event == "sleep_phase":
                text = "😴 lamps going to sleep" if frame.get("status") == "start" else "🌅 lamps waking up"
            else:
                continue
            try:
                await _mesh_send(text, MESH_CHANNEL)
            except Exception as exc:
                logger.warning("mesh event relay failed (%s): %s", event, exc)
    finally:
        bridge.unsubscribe(queue)


# ---------------------------------------------------------------------------
# Animation
# ---------------------------------------------------------------------------

@app.get("/commandSetLogLevel")
async def command_set_log_level(level: int = 0):
    _send({"cmd": "set_log_level", "level": level})
    return _ok()

@app.get("/commandAnimate")
async def command_animate():
    settings = _load_settings()
    if settings.get("resync_mode", "fast") != "off":
        asyncio.create_task(_presync_then_send({"cmd": "animate_toggle"}, delay_s=5))
    else:
        _send({"cmd": "animate_toggle"})
    return _ok()


@app.get("/commandAnimationOff")
async def command_animation_off():
    _send({"cmd": "animation_off"})
    return _ok()


@app.get("/getAnimateStatus")
async def get_animate_status():
    return await _request({"cmd": "get_animate_status"}, "animate_status")


@app.get("/commandBlink")
async def command_blink(boardId: int = Query(...)):
    _send({"cmd": "blink", "boardId": boardId})
    return _ok()


async def _presync_then_send(payload: dict, delay_s: float):
    """Send sync first, wait delay_s, then send the animation payload."""
    settings = _load_settings()
    mode = settings.get("resync_mode", "fast")
    if mode == "fast":
        _send({"cmd": "sync_fast"})
        await asyncio.sleep(delay_s)
    elif mode == "slow":
        _send({"cmd": "sync_all"})
        await asyncio.sleep(delay_s * 5)
    _send(payload)


@app.get("/commandBlinkAll")
async def command_blink_all():
    _send({"cmd": "blink_all"})
    return _ok()


@app.get("/commandBatteryBlinkAll")
async def command_battery_blink_all():
    _send({"cmd": "blink_battery_all"})
    return _ok()


@app.get("/commandStrobeAll")
async def command_strobe_all(
    frequency: int = Query(default=10),
    duration: int = Query(default=3000),
    hue: int = Query(default=0),
    saturation: int = Query(default=0),
    brightness: int = Query(default=255),
):
    payload = {"cmd": "strobe_all", "frequency": frequency, "duration": duration,
               "hue": hue, "saturation": saturation, "brightness": brightness}
    _send(payload)
    return _ok()


# ---------------------------------------------------------------------------
# Timer test
# ---------------------------------------------------------------------------

@app.get("/commandTimerTest")
async def command_timer_test():
    _send({"cmd": "timer_test"})
    return _ok()


@app.get("/sleepTest")
async def sleep_test(
    sleepSeconds: int = Query(default=15, ge=5, le=3600),
    phaseSeconds: int = Query(default=60, ge=10, le=86400),
):
    _send({"cmd": "test_sleep_cycle",
           "sleep_duration_s": sleepSeconds,
           "phase_duration_s": phaseSeconds})
    return _ok()


@app.get("/sleepTestCancel")
async def sleep_test_cancel():
    _send({"cmd": "test_sleep_cancel"})
    return _ok()


@app.get("/sleepTestReport")
async def sleep_test_report():
    # events for the current/most recent run, in order — survives page reloads,
    # closed browsers, and a sparkles service restart (persisted to disk)
    return {"events": bridge.sleep_test_events}


# ---------------------------------------------------------------------------
# Sync
# ---------------------------------------------------------------------------

@app.get("/commandSync")
async def command_sync(index: int = Query(...)):
    _send({"cmd": "sync", "index": index})
    return _ok()


@app.get("/commandSyncAll")
async def command_sync_all():
    _send({"cmd": "sync_all"})
    return _ok()


@app.get("/commandSyncFast")
async def command_sync_fast():
    _send({"cmd": "sync_fast"})
    return _ok()


@app.get("/commandTestSleepCycle")
async def command_test_sleep_cycle(
    sleep_duration_s: int = Query(default=15),
    phase_duration_s: int = Query(default=60),
) -> StreamingResponse:
    """Run a compressed sleep cycle test, streaming JSON events as SSE."""
    _send({"cmd": "test_sleep_cycle",
           "sleep_duration_s": sleep_duration_s,
           "phase_duration_s": phase_duration_s})

    _SLEEP_TEST_EVENTS = {
        "sleep_test_start", "sleep_test_resync_start", "sleep_test_resync_done",
        "sleep_test_broadcast_start", "sleep_test_cycle_heartbeat",
        "sleep_test_unexpected_wakeup", "sleep_test_broadcast_end",
        "sleep_test_waiting_for_wakeup", "sleep_test_client_back", "sleep_test_done",
    }

    queue = bridge.subscribe()

    async def generator() -> AsyncGenerator[str, None]:
        timeout_s = phase_duration_s + sleep_duration_s + 120
        deadline = asyncio.get_event_loop().time() + timeout_s
        try:
            while True:
                remaining = deadline - asyncio.get_event_loop().time()
                if remaining <= 0:
                    yield f"event: sleep_test_timeout\ndata: {{}}\n\n"
                    break
                try:
                    frame = await asyncio.wait_for(queue.get(), timeout=min(remaining, 15))
                    if frame.get("event") not in _SLEEP_TEST_EVENTS:
                        continue
                    yield f"event: {frame['event']}\ndata: {json.dumps(frame)}\n\n"
                    if frame.get("event") == "sleep_test_done":
                        break
                except asyncio.TimeoutError:
                    yield ": keep-alive\n\n"
        finally:
            bridge.unsubscribe(queue)

    return StreamingResponse(generator(), media_type="text/event-stream",
                             headers={"Cache-Control": "no-cache", "X-Accel-Buffering": "no"})


@app.get("/appSettings")
async def get_app_settings():
    return _load_settings()


class AppSettingsUpdate(BaseModel):
    resync_mode: str | None = None  # "fast" | "slow" | "off"


@app.post("/appSettings")
async def set_app_settings(body: AppSettingsUpdate):
    settings = _load_settings()
    if body.resync_mode is not None:
        if body.resync_mode not in ("fast", "slow", "off"):
            raise HTTPException(status_code=422, detail="resync_mode must be fast, slow, or off")
        settings["resync_mode"] = body.resync_mode
    _save_settings(settings)
    return settings


# ---------------------------------------------------------------------------
# Board positions
# ---------------------------------------------------------------------------

@app.get("/submitPositions")
async def submit_positions(
    boardId: int = Query(...),
    xpos: float = Query(...),
    ypos: float = Query(...),
):
    _send({"cmd": "submit_positions", "boardId": boardId, "xpos": xpos, "ypos": ypos})
    return _ok()


# ---------------------------------------------------------------------------
# Address list
# ---------------------------------------------------------------------------

@app.get("/getAddressList")
async def get_address_list(id: int | None = Query(default=None)):
    cmd = {"cmd": "get_address_list"}
    if id is not None:
        cmd["id"] = id
    return await _request(cmd, "address_list")


@app.get("/removeDevice")
async def remove_device(index: int = Query(...)):
    # fire-and-forget: removal shifts indices, so the result comes back as a
    # fresh update_board/address_list dump over SSE, not a single response
    _send({"cmd": "remove_device", "index": index})
    return _ok()


@app.get("/removeAllDevices")
async def remove_all_devices():
    _send({"cmd": "remove_all_devices"})
    return _ok()


# ---------------------------------------------------------------------------
# Time
# ---------------------------------------------------------------------------

@app.get("/setTime")
async def set_time(
    year: int = Query(...),
    month: int = Query(...),
    day: int = Query(...),
    hours: int = Query(...),
    minutes: int = Query(...),
    seconds: int = Query(...),
):
    # the browser is the only real time source here (no internet, no rtc):
    # set the pi's own clock too and mark it trusted for the rest of this boot
    stamp = f"{year:04d}-{month:02d}-{day:02d} {hours:02d}:{minutes:02d}:{seconds:02d}"
    try:
        subprocess.run(["sudo", "date", "-s", stamp], check=True, timeout=5, capture_output=True)
        subprocess.run(["sudo", "fake-hwclock", "save"], timeout=5, capture_output=True)
    except Exception as exc:
        logger.warning("Could not set pi clock: %s", exc)
    bridge.mark_clock_trusted()
    _send({"cmd": "set_time", "year": year, "month": month, "day": day,
           "hours": hours, "minutes": minutes, "seconds": seconds})
    return _ok()


@app.get("/setSleepTime")
async def set_sleep_time(
    hours: int = Query(...),
    minutes: int = Query(...),
    seconds: int = Query(...),
):
    bridge.set_schedule(sleep={"hours": hours, "minutes": minutes, "seconds": seconds})
    _send({"cmd": "set_sleep_time", "hours": hours, "minutes": minutes, "seconds": seconds})
    return _ok()


@app.get("/setWakeupTime")
async def set_wakeup_time(
    hours: int = Query(...),
    minutes: int = Query(...),
    seconds: int = Query(...),
):
    bridge.set_schedule(wakeup={"hours": hours, "minutes": minutes, "seconds": seconds})
    _send({"cmd": "set_wakeup_time", "hours": hours, "minutes": minutes, "seconds": seconds})
    return _ok()


@app.get("/sleepUntil")
async def sleep_until(
    hours: int = Query(..., ge=0, le=23),
    minutes: int = Query(..., ge=0, le=59),
    seconds: int = Query(default=0, ge=0, le=59),
    skipResync: bool = Query(default=False),
):
    # one-shot: sleep starting now until this wall-clock time, independent of
    # (and without altering) the recurring daily sleep/wakeup schedule above.
    # skipResync: fleet is already asleep (post-reboot) — the "Wake Up At" case;
    # hold them down and wake at the time without an opening resync.
    _send({"cmd": "sleep_until", "hours": hours, "minutes": minutes,
           "seconds": seconds, "skip_resync": skipResync})
    return _ok()


@app.get("/wakeCancel")
async def wake_cancel():
    """Stop a verified wake that has nothing left to wait for."""
    _send({"cmd": "wake_cancel"})
    return _ok()


@app.get("/sleepUntilCancel")
async def sleep_until_cancel():
    _send({"cmd": "sleep_until_cancel"})
    return _ok()


@app.get("/sleepNow")
async def sleep_now():
    # definitively put every device to sleep right now: no resync, hold until
    # Wake Up Now. Also reachable without auth via sleep_all.sh (serial socket).
    _send({"cmd": "sleep_now"})
    return _ok()


@app.get("/wakeNow")
async def wake_now():
    # cancel ALL sleep activity (manual hold + recurring scheduled phase) and
    # wake the whole fleet, verified until everyone returns
    _send({"cmd": "wake_now"})
    return _ok()


@app.get("/setManualMode")
async def set_manual_mode_sleep(active: bool = Query(...)):
    # fully manual sleep/wake: when active, the recurring schedule is ignored and
    # the fleet only sleeps/wakes on Sleep Now / Wake Now. Enabling it also wakes now.
    _send({"cmd": "set_manual_mode", "active": active})
    return _ok()


@app.get("/getSystemInfo")
async def get_system_info():
    return await _request({"cmd": "get_system_info"}, "system_info")


# ---------------------------------------------------------------------------
# MIDI params
# ---------------------------------------------------------------------------

@app.get("/colors")
async def get_colors():
    return bridge.colors


@app.get("/setColors")
async def set_colors(
    midiHue: int | None = Query(default=None, ge=0, le=360),
    midiSaturation: int | None = Query(default=None, ge=0, le=255),
    shimmerHue: int | None = Query(default=None, ge=0, le=360),
    shimmerSaturation: int | None = Query(default=None, ge=0, le=255),
):
    midi = {k: v for k, v in (("hue", midiHue), ("saturation", midiSaturation)) if v is not None}
    shimmer = {k: v for k, v in (("hue", shimmerHue), ("saturation", shimmerSaturation)) if v is not None}
    bridge.set_colors(midi=midi or None, shimmer=shimmer or None)
    return _ok()


@app.post("/internal/aubio_level")
async def aubio_level(request: Request):
    """aubioAlgo reports what it is hearing, a few times a second."""
    import time
    body = await request.json()
    _audio_level["db"] = body.get("db")
    _audio_level["pitch"] = body.get("pitch", 0.0)
    _audio_level["ts"] = time.time()
    return _ok()


@app.get("/audioLevel")
async def audio_level():
    """Live input level, or stale=true when aubio has gone quiet on us."""
    import time
    age = time.time() - _audio_level["ts"] if _audio_level["ts"] else None
    return JSONResponse({
        "db": _audio_level["db"],
        "pitch": _audio_level["pitch"],
        "age": age,
        "stale": age is None or age > 3.0,
    })


@app.get("/setRmsThresholds")
async def set_rms_thresholds(rmsMin: float = Query(...), rmsMax: float = Query(...)):
    """Store measured thresholds and push them to the fleet.

    Persisted here rather than on the master, which holds midi params in RAM and
    would lose them on the next reboot. getMidiParams overlays them on the way
    back out, so aubio picks them up on its next poll.
    """
    if rmsMax <= rmsMin:
        raise HTTPException(400, detail="rmsMax must be above rmsMin")
    settings = _load_settings()
    settings["rmsMin"] = round(float(rmsMin), 2)
    settings["rmsMax"] = round(float(rmsMax), 2)
    settings["rmsCalibrated"] = True
    _save_settings(settings)

    # push to the master too, so the mesh agrees with what is stored. Needs the
    # whole parameter set: the saved one, or the master's if nothing was saved yet
    try:
        params = dict(bridge.midi_params)
        if not params:
            current = await _request({"cmd": "get_midi_params"}, "midi_params")
            params = dict(current) if isinstance(current, dict) else {}
            params.pop("event", None)
            # the master answers with hue/saturation but is set with midiHue/midiSaturation
            params["midiHue"] = params.pop("hue", 0)
            params["midiSaturation"] = params.pop("saturation", 255)
        params.update({"minDb": settings["rmsMin"], "maxDb": settings["rmsMax"]})
        bridge.set_midi_params(params)
    except Exception as exc:
        logger.warning("stored thresholds but could not push to the master: %s", exc)

    return JSONResponse({"status": True, "rmsMin": settings["rmsMin"],
                         "rmsMax": settings["rmsMax"]})


@app.get("/getMidiParams")
@app.get("/commandGetMidiParams")
async def get_midi_params():
    params = await _request({"cmd": "get_midi_params"}, "midi_params")
    # Overlay the stored calibration. rmsCalibrated tells aubio to stop deriving
    # thresholds from the room — otherwise it would overwrite the measurement
    # within a second of it being set.
    settings = _load_settings()
    if settings.get("rmsCalibrated") and isinstance(params, dict):
        params = dict(params)
        params["rmsMin"] = settings.get("rmsMin", params.get("rmsMin"))
        params["rmsMax"] = settings.get("rmsMax", params.get("rmsMax"))
        params["rmsCalibrated"] = True
    return params


@app.get("/setMidiParams")
async def set_midi_params(
    minVal: int = Query(...),
    maxVal: int = Query(...),
    minSat: int = Query(...),
    maxSat: int = Query(...),
    midiHue: int = Query(...),
    midiSaturation: int = Query(...),
    rangeMin: int = Query(...),
    rangeMax: int = Query(...),
    minDb: float = Query(...),
    maxDb: float = Query(...),
    mode: int = Query(...),
    distance: int = Query(default=0),
    distanceSwitch: bool = Query(default=False),
    distanceMode: int = Query(default=0),
    distanceEdge: int = Query(default=50, ge=0, le=100),
):
    # stored by the bridge and pushed again on every connect, the master forgets on reboot
    bridge.set_midi_params({
        "minVal": minVal, "maxVal": maxVal,
        "minSat": minSat, "maxSat": maxSat,
        "midiHue": midiHue, "midiSaturation": midiSaturation,
        "rangeMin": rangeMin, "rangeMax": rangeMax,
        "minDb": minDb, "maxDb": maxDb,
        "mode": mode,
        "distance": distance, "distanceSwitch": distanceSwitch, "distanceMode": distanceMode,
        "distanceEdge": distanceEdge,
    })
    # Persist the thresholds here too, exactly as the level test does. Without
    # this, getMidiParams keeps overlaying the stored calibration on the way out
    # and a manual adjustment is overwritten the moment the page reloads or the
    # detector polls — which also means the slider cannot be used to cope with a
    # noisy room. Any deliberate setting counts as a calibration, however it was
    # arrived at, and it survives a master reboot now rather than living in RAM.
    settings = _load_settings()
    if (settings.get("rmsMin") != minDb or settings.get("rmsMax") != maxDb
            or not settings.get("rmsCalibrated")):
        settings["rmsMin"] = round(float(minDb), 2)
        settings["rmsMax"] = round(float(maxDb), 2)
        settings["rmsCalibrated"] = True
        _save_settings(settings)
    return _ok()


# ---------------------------------------------------------------------------
# Darkroom params
# ---------------------------------------------------------------------------

@app.get("/getDarkroomParams")
async def get_darkroom_params():
    return await _request({"cmd": "get_darkroom_params"}, "darkroom_params")


@app.get("/setDarkroomParams")
async def set_darkroom_params(
    strobeMin: int = Query(...),
    strobeMax: int = Query(...),
    redlightMin: int = Query(...),
    redlightMax: int = Query(...),
    candlelightMin: int = Query(...),
    candlelightMax: int = Query(...),
    redLightEnabled: bool = Query(...),
    candleLightEnabled: bool = Query(...),
):
    _send({
        "cmd": "set_darkroom_params",
        "strobeMin": strobeMin, "strobeMax": strobeMax,
        "redlightMin": redlightMin, "redlightMax": redlightMax,
        "candlelightMin": candlelightMin, "candlelightMax": candlelightMax,
        "redLightEnabled": redLightEnabled, "candleLightEnabled": candleLightEnabled,
    })
    return _ok()


# ---------------------------------------------------------------------------
# Calibration
# ---------------------------------------------------------------------------

@app.get("/commandStartCalibration")
async def command_start_calibration():
    _send({"cmd": "calibration_start"})
    return _ok()


@app.get("/commandCancelCalibration")
async def command_cancel_calibration():
    _send({"cmd": "calibration_cancel"})
    return _ok()


@app.get("/commandResetCalibration")
async def command_reset_calibration():
    _send({"cmd": "calibration_reset"})
    return _ok()


@app.get("/commandContinueCalibration")
async def command_continue_calibration(x: float = Query(...), y: float = Query(...)):
    _send({"cmd": "calibration_continue", "x": x, "y": y})
    return _ok()


@app.get("/commandEndCalibration")
async def command_end_calibration():
    _send({"cmd": "calibration_end"})
    return _ok()


@app.get("/commandTestCalibration")
async def command_test_calibration():
    _send({"cmd": "calibration_test"})
    return _ok()


@app.get("/commandCalibrate")
async def command_calibrate(boardId: int = Query(...)):
    _send({"cmd": "calibration_calibrate", "boardId": boardId})
    return _ok()


# ---------------------------------------------------------------------------
# Distance calibration
# ---------------------------------------------------------------------------

@app.get("/commandChirpAtPosition")
async def command_chirp_at_position(x: float = Query(0.0), y: float = Query(0.0)):
    """Run one chirp burst with the chirp device standing at (x, y).

    The coordinates are only used by the master's own trilateration. For the
    anchor-free solve below they are ignored — chirp from wherever you like.
    """
    _send({"cmd": "chirp_position", "x": x, "y": y})
    return _ok()


# ---------------------------------------------------------------------------
# Anchor-free map: solve board positions without knowing where anything is
# ---------------------------------------------------------------------------

@app.get("/mapMeasurements")
async def map_measurements():
    """What the collector has heard so far, per board and per spot."""
    return JSONResponse(map_data.summary())


@app.get("/clearMap")
async def clear_map():
    map_data.clear()
    return _ok("Map measurements cleared")


@app.get("/solveMap")
async def solve_map(push: bool = Query(False), flip: bool = Query(False)):
    """Recover every board's position from the chirp distances alone.

    No spot coordinates needed: the constellation is fixed by the distances up to
    rotation, translation and a mirror flip. push=true writes the result back to
    the master, flip=true mirrors it if the map comes out handed wrong.
    """
    result = await asyncio.to_thread(mapsolve.solve, map_data, 2, True, flip)
    if not result.get("ok"):
        raise HTTPException(400, detail=result.get("reason", "solve failed"))
    if push:
        pushed = 0
        for board in result["boards"]:
            if not board["trusted"]:
                continue
            _send({"cmd": "submit_positions", "boardId": board["boardId"],
                   "xpos": board["x"], "ypos": board["y"]})
            pushed += 1
            await asyncio.sleep(0.05)   # one config broadcast per board, don't flood the mesh
        result["pushed"] = pushed
    return JSONResponse(result)


@app.get("/commandStartDistanceCalibration")
async def command_start_distance_calibration():
    _send({"cmd": "dist_cal_start"})
    return _ok()


@app.get("/commandContinueDistanceCalibration")
async def command_continue_distance_calibration():
    _send({"cmd": "dist_cal_continue"})
    return _ok()


@app.get("/commandEndDistanceCalibration")
async def command_end_distance_calibration():
    _send({"cmd": "dist_cal_end"})
    return _ok()


@app.get("/commandCancelDistanceCalibration")
async def command_cancel_distance_calibration():
    _send({"cmd": "dist_cal_cancel"})
    return _ok()


@app.get("/commandAbortDistanceCalibration")
async def command_abort_distance_calibration():
    _send({"cmd": "dist_cal_abort"})
    return _ok()


# ---------------------------------------------------------------------------
# Admin / system
# ---------------------------------------------------------------------------

def _ota_network_checked() -> tuple[str, str, str]:
    """(ssid, password, url) for an OTA, or a 503 naming what is missing."""
    ssid, password, url = bridge.ota_network()
    if not ssid:
        raise HTTPException(503, detail="Could not read the Pi's current WiFi network — "
                                        "nothing sent, no board has left the mesh")
    if password is None:
        raise HTTPException(503, detail=f"No password known for '{ssid}'. Nothing sent — sending "
                                        f"boards to a network they cannot join would strand them.")
    if not url:
        raise HTTPException(503, detail="Could not detect the Pi's own IP, so the boards would "
                                        "have no firmware URL to fetch. Nothing sent.")
    return ssid, password, url


@app.get("/commandOTAUpdate")
async def command_ota_update():
    """Send every active board off to fetch new firmware.

    The network goes out first and is re-read here rather than trusted from
    connect time: the pi moves between WLIAN and its own AP fallback while the
    master stays up, and a board sent to a network that is not there leaves the
    mesh and does not come back on its own."""
    _assert_connected()
    ssid, password, url = _ota_network_checked()

    bridge.send({"cmd": "set_ota_wifi", "ssid": ssid, "password": password})
    bridge.send({"cmd": "set_ota_url", "url": url})
    bridge.send({"cmd": "ota_update"})
    logger.info("OTA started — network %s, url %s", ssid, url)
    # the ssid and url are worth showing; the password is not
    return JSONResponse({"status": True, "msg": f"OTA started on {ssid}", "ssid": ssid, "url": url})


@app.get("/otaNetwork")
async def ota_network():
    """What an OTA would use right now, so the UI can show it before committing."""
    ssid, password, url = bridge.ota_network()
    return {"ssid": ssid, "url": url, "hasPassword": password is not None,
            "ready": bool(ssid and password is not None and url)}


# A rollout keeps at most this many boards away from the mesh at once, which is
# also the most that are ever on the pi's wifi and downloading from it
_OTA_PARALLEL = 5
_OTA_FETCH_TIMEOUT_S = 30   # asked -> its download starts; joining alone takes a board up to 10 s
_OTA_STALL_TIMEOUT_S = 20   # a download that moves nothing for this long is dead
_OTA_BACK_TIMEOUT_S = 90    # downloaded -> heard on the mesh again

_ota_running = False


async def _fetch_roster(timeout: float = 5.0) -> list[dict] | None:
    """Every board the master knows, as its update_board frames, by id.

    get_address_list is answered with one update_board per board and then an
    address_list that carries only the count, so the boards are picked off the
    stream on the way to it. A line the master had no room for is a board left
    out, so it asks again while the count is not met."""
    boards: dict[int, dict] = {}
    queue = bridge.subscribe()
    try:
        loop = asyncio.get_event_loop()
        for _ in range(3):
            bridge.send({"cmd": "get_address_list"})
            deadline = loop.time() + timeout
            count = None
            while count is None:
                remaining = deadline - loop.time()
                if remaining <= 0:
                    return None
                try:
                    frame = await asyncio.wait_for(queue.get(), timeout=remaining)
                except asyncio.TimeoutError:
                    return None
                if frame.get("event") == "update_board" and frame.get("id") is not None:
                    boards[frame["id"]] = frame
                elif frame.get("event") == "address_list":
                    count = frame.get("numDevices", 0)
            if len(boards) >= count:
                break
    finally:
        bridge.unsubscribe(queue)
    return [boards[i] for i in sorted(boards)]


@app.get("/otaRollout")
async def ota_rollout(
    request: Request,
    parallel: int = Query(default=_OTA_PARALLEL, ge=1, le=10),
    boards: str = Query(default=""),
) -> StreamingResponse:
    """Update the boards one by one, never more than `parallel` away at once.

    A board counts as away from the moment it is asked until it is heard on the
    mesh again: joining the pi's wifi, downloading from it, and the reboot. Every
    board in the master's list is asked, inactive ones too since after a master
    reboot they all are, or only the ids in `boards` (comma-separated) to retry
    the ones a previous run named. Closing the stream stops the asking; boards
    already away finish on their own."""
    global _ota_running
    _assert_connected()
    ssid, password, url = _ota_network_checked()
    if not os.path.isfile(FIRMWARE_PATH):
        raise HTTPException(409, detail="No firmware on the Pi to hand out")
    try:
        wanted = [int(b) for b in boards.split(",") if b.strip()]
    except ValueError:
        raise HTTPException(400, detail="boards is a comma-separated list of board ids")

    # set here, not inside the generator, for the same reason as the health check
    if _ota_running:
        raise HTTPException(409, detail="An OTA rollout is already running")
    _ota_running = True

    async def generator() -> AsyncGenerator[str, None]:
        global _ota_running

        def emit(event: str, data: dict) -> str:
            return f"event: {event}\ndata: {json.dumps({'event': event, **data})}\n\n"

        try:
            roster = await _fetch_roster()
            if roster is None:
                yield emit("ota_error", {"msg": "Master did not send its address list, nothing sent"})
                return
            macs = {b["id"]: b["address"].lower() for b in roster if b.get("address")}
            targets = [b for b in (wanted or list(macs)) if b in macs]
            unknown = [b for b in wanted if b not in macs]

            bridge.send({"cmd": "set_ota_wifi", "ssid": ssid, "password": password})
            bridge.send({"cmd": "set_ota_url", "url": url})
            msg = f"updating {len(targets)} board(s) over {ssid}, at most {parallel} at a time"
            if unknown:
                msg += f", the master has no board {unknown}"
            yield emit("ota_start", {"total": len(targets), "boardIds": targets, "unknownIds": unknown,
                                     "parallel": parallel, "ssid": ssid, "url": url, "msg": msg})

            pending = list(targets)
            away: dict[int, dict] = {}      # boardId -> {"phase", "since"}
            updated: list[int] = []
            current: list[int] = []
            not_back: list[int] = []
            failed: dict[int, str] = {}

            def board(event: str, board_id: int, phase: str, text: str) -> str:
                done = len(targets) - len(pending) - len(away)
                return emit(event, {"boardId": board_id, "phase": phase, "away": len(away),
                                    "done": done, "total": len(targets),
                                    "msg": f"board {board_id}: {text}  ({done}/{len(targets)} done, "
                                           f"{len(away)} away)"})

            # one subscription for the whole run: the reboot is only seen as the
            # board turning up on the mesh again
            queue = bridge.subscribe()
            try:
                while pending or away:
                    if await request.is_disconnected():
                        yield emit("ota_cancelled", {"msg": "stopped asking, boards still away "
                                                            "finish on their own"})
                        return

                    while pending and len(away) < parallel:
                        board_id = pending.pop(0)
                        _ota_downloads.pop(macs[board_id], None)
                        ack = await bridge.request({"cmd": "ota_board", "boardId": board_id},
                                                   "ota_sent", 3.0)
                        if ack is None:
                            yield emit("ota_error", {"msg": "The master does not answer ota_board — is it "
                                                            "on the new firmware? Stopped asking."})
                            return
                        if not ack.get("ok"):
                            failed[board_id] = "the master has no address for it"
                            yield board("ota_board_failed", board_id, "failed", failed[board_id])
                            continue
                        away[board_id] = {"phase": "asked", "since": time.monotonic()}
                        yield board("ota_board", board_id, "asked", "asked")

                    while not queue.empty():
                        frame = queue.get_nowait()
                        board_id = frame.get("id")
                        if (frame.get("event") == "update_board" and frame.get("status") == "active"
                                and board_id in away
                                and away[board_id]["phase"] in ("downloaded", "current")):
                            phase = away.pop(board_id)["phase"]
                            (current if phase == "current" else updated).append(board_id)
                            yield board("ota_board", board_id, "back", "back on the mesh")

                    now = time.monotonic()
                    for board_id, b in list(away.items()):
                        d = _ota_downloads.get(macs[board_id])
                        if b["phase"] == "asked":
                            if d and d["current"]:
                                b.update(phase="current", since=now)
                                yield board("ota_board", board_id, "current", "already on this build")
                            elif d:
                                b.update(phase="downloading", since=now)
                                yield board("ota_board", board_id, "downloading", "downloading")
                            elif now - b["since"] > _OTA_FETCH_TIMEOUT_S:
                                del away[board_id]
                                failed[board_id] = "never fetched the firmware"
                                yield board("ota_board_failed", board_id, "failed", failed[board_id])
                                continue
                        if b["phase"] == "downloading":
                            if d["done"] and d["sent"] == d["size"]:
                                took = now - b["since"]
                                b.update(phase="downloaded", since=now)
                                yield board("ota_board", board_id, "downloaded",
                                            f"downloaded in {took:.0f} s, rebooting")
                            elif d["done"] or now - d["last"] > _OTA_STALL_TIMEOUT_S:
                                del away[board_id]
                                failed[board_id] = f"download broke off at {100 * d['sent'] // d['size']}%"
                                yield board("ota_board_failed", board_id, "failed", failed[board_id])
                                continue
                        if b["phase"] in ("downloaded", "current") and now - b["since"] > _OTA_BACK_TIMEOUT_S:
                            del away[board_id]
                            not_back.append(board_id)
                            yield board("ota_board_failed", board_id, "not_back",
                                        f"not heard on the mesh {_OTA_BACK_TIMEOUT_S} s after its download")

                    await asyncio.sleep(0.5)

                parts = [f"{len(updated)} updated", f"{len(current)} already on this build"]
                if not_back:
                    parts.append(f"{len(not_back)} downloaded but not heard back {not_back}")
                if failed:
                    parts.append(f"{len(failed)} failed {sorted(failed)}")
                yield emit("ota_done", {"updated": updated, "current": current, "notBack": not_back,
                                        "failed": failed, "msg": "done: " + ", ".join(parts)})
            finally:
                bridge.unsubscribe(queue)
        finally:
            _ota_running = False

    return StreamingResponse(generator(), media_type="text/event-stream",
                             headers={"Cache-Control": "no-cache", "X-Accel-Buffering": "no"})


@app.get("/toggleTestMode")
async def toggle_test_mode(spacing: float = Query(default=1.0)):
    result = await _request({"cmd": "toggle_test_mode", "spacing": spacing}, "test_mode")
    return result


@app.get("/toggleLogging")
async def toggle_logging():
    result = await _request({"cmd": "toggle_logging"}, "logging")
    return result


@app.get("/reannounce")
async def reannounce():
    _send({"cmd": "reannounce"})
    return _ok()


@app.get("/resetSystem")
async def reset_system():
    _send({"cmd": "reset_system"})
    return _ok()


@app.get("/resetClients")
async def reset_clients():
    # reboot every client, keep the master and its address list intact
    _send({"cmd": "reset_clients"})
    return _ok()


@app.get("/factoryReset")
async def factory_reset():
    _send({"cmd": "factory_reset"})
    return _ok()


@app.post("/setMaintenanceMode")
async def set_maintenance_mode(active: bool = Query(...)):
    _send({"cmd": "set_maintenance_mode", "active": active})
    return _ok()


@app.get("/commandShimmer")
async def command_shimmer(boardId: int = Query(default=-1)):
    _send({"cmd": "shimmer", "boardId": boardId})
    return _ok()


@app.get("/commandResetChirp")
async def command_reset_chirp():
    """Restart the chirp device."""
    _send({"cmd": "reset_chirp"})
    return _ok()


@app.get("/commandResetClient")
async def command_reset_client(boardId: int = Query(...)):
    """Restart one board."""
    _send({"cmd": "reset_client", "boardId": boardId})
    return _ok()


@app.get("/commandMicTest")
async def command_mic_test(boardId: int = Query(default=-1)):
    """Ask a board (or the whole fleet) what its microphone is producing."""
    _send({"cmd": "mic_test", "boardId": boardId})
    return _ok()


@app.get("/commandTestChirp")
async def command_test_chirp():
    """Play one chirp on the chirp device and nothing else.

    No timestamps, no MSG_CLAP, no slot — so it cannot disturb a calibration or
    leave a measurement behind. Purely for listening to the chirp."""
    _send({"cmd": "test_chirp"})
    return _ok("Test chirp sent")


@app.get("/commandHealthPing")
async def command_health_ping(boardId: int = Query(default=-1)):
    """Ask one board (or, with -1, the whole fleet) to report its vitals.

    Replies arrive as client_health events on /events. For a counted sweep of
    the fleet use /systemHealth, which asks one board at a time and knows which
    ones never answered."""
    _send({"cmd": "health_ping", "boardId": boardId})
    return _ok()


# ---------------------------------------------------------------------------
# System health check — ask every board in turn, three passes
# ---------------------------------------------------------------------------

# A board answers in tens of milliseconds or it is not there. Waiting longer
# only makes a sweep of a sleeping fleet take minutes.
# ---------------------------------------------------------------------------
# Speaker latency test: one board at a measured distance, burst after burst,
# to see whether the audio path's delay holds still enough to write into code
# ---------------------------------------------------------------------------

_LATENCY_RUNS_PATH = os.environ.get("SPARKLES_LATENCY_RUNS", "/home/julian/sparkles/latency_runs.json")
_LATENCY_KEEP_RUNS = 50
_LATENCY_BURST_TIMEOUT_S = 30.0
_LATENCY_MAX_FAILURES = 3     # bursts in a row that measured nothing
_CHIRP_PERIOD_S = 0.5         # CHIRP_BURST_PERIOD_MS
_CHIRPS_PER_BURST = 10        # CHIRP_BURST_COUNT
_latency_running = False
_latency_stop = False         # End test: finish the burst in flight, then stop
_latency_progress: dict = {}  # what a page opened mid-run needs to show and end it


def _load_latency_runs() -> list:
    try:
        with open(_LATENCY_RUNS_PATH) as f:
            return json.load(f)
    except (OSError, ValueError):
        return []


def _save_latency_run(run: dict):
    runs = (_load_latency_runs() + [run])[-_LATENCY_KEEP_RUNS:]
    os.makedirs(os.path.dirname(_LATENCY_RUNS_PATH), exist_ok=True)
    tmp = _LATENCY_RUNS_PATH + ".tmp"
    with open(tmp, "w") as f:
        json.dump(runs, f)
    os.replace(tmp, _LATENCY_RUNS_PATH)


def _fit_line(points: list) -> "tuple[float, float, float] | None":
    """Least squares y = a + b·x as (a, b, residual sd); None under two points."""
    n = len(points)
    if n < 2:
        return None
    mx = sum(x for x, _ in points) / n
    my = sum(y for _, y in points) / n
    sxx = sum((x - mx) ** 2 for x, _ in points)
    if sxx == 0:
        return None
    b = sum((x - mx) * (y - my) for x, y in points) / sxx
    a = my - b * mx
    sd = (sum((y - a - b * x) ** 2 for x, y in points) / (n - 2)) ** 0.5 if n > 2 else 0.0
    return a, b, sd


def _latency_burst_stats(n: int, t: float, result: dict, true_distance: float) -> dict:
    """Everything past the measured distance is delay in the audio path."""
    readings = result.get("d") or []
    # the master turned these into distances at this speed, so undo them with it
    c = bridge.sound_speed()
    delays = [round((d - true_distance) / c * 1000.0, 4) if d and d > 0 else None
              for d in readings]
    points = [(i * _CHIRP_PERIOD_S, v) for i, v in enumerate(delays) if v is not None]
    burst = {"n": n, "t": round(t, 2), "status": result.get("status"),
             "reason": result.get("reason"), "source": result.get("source"),
             "chirpsSent": result.get("chirpsSent"), "heard": len(points),
             "kept": result.get("kept"), "d": readings, "delays": delays}
    if points:
        values = [v for _, v in points]
        burst["meanDelayMs"] = round(statistics.fmean(values), 4)
        burst["medianDelayMs"] = round(statistics.median(values), 4)
        burst["minDelayMs"] = min(values)
        burst["maxDelayMs"] = max(values)
    fit = _fit_line(points)
    if fit:
        burst["driftPpm"] = round(fit[1] * 1000.0, 1)   # ms of delay per s = µs per s
        burst["jitterMs"] = round(fit[2], 4)            # scatter around that line
    return burst


def _latency_summary(bursts: list) -> dict:
    measured = [b for b in bursts if b.get("meanDelayMs") is not None]
    summary = {"bursts": len(bursts), "measured": len(measured)}
    if not measured:
        return summary
    means = [b["meanDelayMs"] for b in measured]
    summary["meanDelayMs"] = round(statistics.fmean(means), 4)
    summary["sdDelayMs"] = round(statistics.stdev(means), 4) if len(means) > 1 else 0.0
    summary["minDelayMs"] = min(means)
    summary["maxDelayMs"] = max(means)
    summary["rangeMs"] = round(max(means) - min(means), 4)
    summary["rangeCm"] = round((max(means) - min(means)) * bridge.sound_speed() / 10.0, 2)
    trend = _fit_line([(b["t"], b["meanDelayMs"]) for b in measured])
    if trend:
        summary["trendMsPerMin"] = round(trend[1] * 60.0, 4)
    drifts = [b["driftPpm"] for b in measured if b.get("driftPpm") is not None]
    if drifts:
        summary["meanDriftPpm"] = round(statistics.fmean(drifts), 1)
        summary["sdDriftPpm"] = round(statistics.stdev(drifts), 1) if len(drifts) > 1 else 0.0
    jitter = [b["jitterMs"] for b in measured if b.get("jitterMs") is not None]
    if jitter:
        summary["meanJitterMs"] = round(statistics.fmean(jitter), 4)
    return summary


async def _await_latency_burst(queue: asyncio.Queue, board_id: int, timeout: float) -> dict:
    """One test burst: the board's one-line summary, or its per-chirp
    client_clap lines if that summary was damaged on the serial link."""
    deadline = time.monotonic() + timeout
    summary = None
    claps: dict = {}
    chirps_sent = 0
    while True:
        remaining = deadline - time.monotonic()
        if remaining <= 0:
            return {"status": "timeout", "reason": "no result from the master",
                    "d": [claps.get(i, 0.0) for i in range(_CHIRPS_PER_BURST)],
                    "source": "client_clap" if claps else None, "chirpsSent": chirps_sent}
        try:
            frame = await asyncio.wait_for(queue.get(), remaining)
        except asyncio.TimeoutError:
            continue
        event = frame.get("event")
        if event == "latency_burst" and frame.get("boardId") == board_id:
            summary = frame
        elif event == "client_clap" and frame.get("boardId") == board_id:
            claps[int(frame.get("clapId", -1))] = float(frame.get("clapDistance") or 0.0)
        elif event == "latency_status":
            status = frame.get("status")
            if status == "running":
                chirps_sent = max(chirps_sent, int(frame.get("chirp") or 0))
            elif status in ("done", "failed"):
                if summary is not None:
                    readings, source = [float(x or 0.0) for x in summary.get("d", [])], "summary"
                else:
                    readings = [claps.get(i, 0.0) for i in range(_CHIRPS_PER_BURST)]
                    source = "client_clap" if claps else None
                return {"status": status, "reason": frame.get("reason"), "d": readings,
                        "source": source, "kept": summary.get("kept") if summary else None,
                        "chirpsSent": frame.get("chirp", chirps_sent)}


@app.get("/latencyTest")
async def latency_test(
    request: Request,
    boardId: int = Query(..., ge=0),
    distance: float = Query(..., ge=0.0, le=100.0),
    bursts: int = Query(default=60, ge=1, le=500),
    gap: float = Query(default=0.0, ge=0.0, le=60.0),
    label: str = Query(default="", max_length=80),
) -> StreamingResponse:
    """Burst after burst with one board at a measured distance from the speaker,
    streamed as it goes. Each burst gives the delay per chirp; across bursts the
    question is whether it holds still. The master records nothing, and the run
    is saved here even when it is stopped half way."""
    global _latency_running, _latency_stop, _latency_progress
    _assert_connected()
    # set before the generator runs, which is too late to turn away a second run
    if _latency_running:
        raise HTTPException(409, detail="A latency test is already running")
    _latency_running = True
    _latency_stop = False
    _latency_progress = {"label": label, "boardId": boardId, "distance": distance,
                         "requested": bursts, "started": time.time(), "done": 0}

    async def generator() -> AsyncGenerator[str, None]:
        global _latency_running, _latency_stop, _latency_progress

        def emit(event: str, data: dict) -> str:
            return f"event: {event}\ndata: {json.dumps({'event': event, **data})}\n\n"

        run = {"label": label, "boardId": boardId, "distance": distance, "requested": bursts,
               "gap": gap, "started": time.time(), "bursts": []}
        saved = False
        queue = bridge.subscribe()
        try:
            yield emit("latency_start", {k: run[k] for k in
                                         ("label", "boardId", "distance", "requested", "gap", "started")})
            failures = 0
            for n in range(1, bursts + 1):
                if _latency_stop or await request.is_disconnected():
                    break
                while not queue.empty():   # a straggler from the last burst is not this one's
                    queue.get_nowait()
                sent_at = time.time()
                bridge.send({"cmd": "latency_burst", "boardId": boardId})
                result = await _await_latency_burst(queue, boardId, _LATENCY_BURST_TIMEOUT_S)
                burst = _latency_burst_stats(n, sent_at - run["started"], result, distance)
                run["bursts"].append(burst)
                _latency_progress["done"] = n
                yield emit("latency_result", {"burst": burst, "summary": _latency_summary(run["bursts"])})
                failures = 0 if burst.get("meanDelayMs") is not None else failures + 1
                if failures >= _LATENCY_MAX_FAILURES:
                    yield emit("latency_error", {"detail": f"{failures} bursts in a row measured nothing "
                                                           "— check the chirp device and the board"})
                    break
                if gap > 0:
                    await asyncio.sleep(gap)
            run["summary"] = _latency_summary(run["bursts"])
            run["finished"] = time.time()
            if _latency_stop:
                run["stopped"] = True
            _save_latency_run(run)
            saved = True
            yield emit("latency_done", {"summary": run["summary"], "finished": run["finished"]})
        finally:
            bridge.unsubscribe(queue)
            if not saved and run["bursts"]:
                # stopped from the browser: keep what was measured
                run["summary"] = _latency_summary(run["bursts"])
                run["finished"] = time.time()
                run["stopped"] = True
                try:
                    _save_latency_run(run)
                except OSError as exc:
                    logger.warning("could not save the latency run: %s", exc)
            _latency_running = False
            _latency_stop = False
            _latency_progress = {}

    return StreamingResponse(generator(), media_type="text/event-stream",
                             headers={"Cache-Control": "no-cache", "X-Accel-Buffering": "no"})


@app.get("/latencyTestStop")
async def latency_test_stop():
    """End the running latency test once the burst in flight is in. Works from
    any browser, not only the one that started it; what was measured is kept."""
    global _latency_stop
    if not _latency_running:
        return _ok("No latency test is running")
    _latency_stop = True
    return _ok("Ending after the current burst")


@app.get("/latencyStatus")
async def latency_status():
    """Whether a latency test is running, so a page opened mid-run can end it."""
    return JSONResponse({"running": _latency_running, "ending": _latency_stop, **_latency_progress})


@app.get("/latencyRuns")
async def latency_runs():
    """Every saved latency run, oldest first, with all of its readings."""
    return JSONResponse(_load_latency_runs())


@app.get("/latencyRunsClear")
async def latency_runs_clear():
    try:
        os.remove(_LATENCY_RUNS_PATH)
    except FileNotFoundError:
        pass
    return _ok("Latency runs cleared")


@app.get("/speakerDelay")
async def get_speaker_delay():
    return bridge.speaker


@app.get("/airTemp")
async def get_air_temp():
    return {**bridge.air, "soundSpeed": round(bridge.sound_speed(), 2)}


@app.get("/setAirTemp")
async def set_air_temp(c: float = Query(..., ge=-30.0, le=50.0)):
    # sound travels 0.6 m/s faster per degree; the master turns flight times
    # into distances with it
    bridge.set_air_temp(c)
    return _ok(f"Air temperature {c:.1f} °C, sound at {bridge.sound_speed():.1f} m/s")


@app.get("/setSpeakerDelay")
async def set_speaker_delay(ms: float = Query(..., ge=0.0, le=150.0)):
    # the latency test's mean delay for the boombox in use; the master takes it
    # off every calibration chirp, and a latency test keeps measuring the total
    bridge.set_speaker_delay(ms)
    return _ok(f"Speaker delay set to {ms:.2f} ms")


_HEALTH_REPLY_TIMEOUT_S = 1.0
_HEALTH_PASSES = 3

_health_running = False


@app.get("/systemHealth")
async def system_health(
    request: Request,
    replyTimeout: float = Query(default=_HEALTH_REPLY_TIMEOUT_S, ge=0.2, le=10.0),
    passes: int = Query(default=_HEALTH_PASSES, ge=1, le=5),
) -> StreamingResponse:
    """Ping every known board individually and stream the tally as it comes in.

    One board is asked at a time so silence is attributable: a board that never
    answers is named, not averaged away. Boards that miss a pass are retried on
    the next one, and only those — a board that already answered is never asked
    again. The count after the last pass is the final one."""
    global _health_running
    _assert_connected()

    # set here, not inside the generator: the generator does not start running
    # until the response is being consumed, which is far too late to reject a
    # second run that arrived in the meantime
    if _health_running:
        raise HTTPException(409, detail="A health check is already running")
    _health_running = True

    async def generator() -> AsyncGenerator[str, None]:
        global _health_running

        def emit(event: str, data: dict) -> str:
            return f"event: {event}\ndata: {json.dumps({'event': event, **data})}\n\n"

        try:
            # the master owns the roster, so ask it rather than trusting
            # whatever the browser happened to have on screen
            roster = await _fetch_roster()
            if roster is None:
                yield emit("health_check_error", {"detail": "Master did not send its address list"})
                return

            boards = [a["id"] for a in roster]
            if not boards:
                yield emit("health_check_done", {"total": 0, "pinged": 0, "pings": 0,
                                                 "responded": 0, "noResponse": 0, "passes": passes,
                                                 "respondedIds": [], "missingIds": []})
                return

            yield emit("health_check_start", {"total": len(boards), "passes": passes,
                                              "replyTimeout": replyTimeout, "boardIds": boards})

            # one subscription for the whole run: a reply that arrives after its
            # own pass gave up still lands, and still counts
            queue = bridge.subscribe()
            healthy: dict[int, dict] = {}   # boardId -> its client_health frame
            asked: set[int] = set()         # distinct boards pinged, retries don't inflate it
            pings = 0                       # ping messages actually sent
            try:
                pending = list(boards)
                for attempt in range(1, passes + 1):
                    if not pending:
                        break
                    yield emit("health_pass_start", {"pass": attempt, "pending": len(pending),
                                                     "boardIds": list(pending)})

                    still_pending = []
                    for board_id in pending:
                        if await request.is_disconnected():
                            yield emit("health_check_cancelled",
                                       {"pinged": len(asked), "responded": len(healthy),
                                        "noResponse": len(boards) - len(healthy)})
                            return

                        asked.add(board_id)
                        pings += 1
                        yield emit("health_pinging", {"boardId": board_id, "pass": attempt,
                                                      "pinged": len(asked), "pings": pings})
                        bridge.send({"cmd": "health_ping", "boardId": board_id})

                        reply = await _await_health_reply(queue, board_id, replyTimeout, healthy)
                        tally = {"pass": attempt, "pinged": len(asked),
                                 "responded": len(healthy),
                                 "noResponse": len(boards) - len(healthy)}
                        if reply is None:
                            still_pending.append(board_id)
                            yield emit("health_no_reply", {"boardId": board_id, **tally})
                        else:
                            yield emit("health_board", {**reply, **tally})

                    # a straggler from this pass may have answered while a later
                    # board was being asked — don't retry a board already in
                    pending = [b for b in still_pending if b not in healthy]
                    yield emit("health_pass_done", {"pass": attempt, "pinged": len(asked),
                                                    "responded": len(healthy),
                                                    "noResponse": len(boards) - len(healthy),
                                                    "retrying": len(pending)})

                missing = [b for b in boards if b not in healthy]
                yield emit("health_check_done", {"total": len(boards), "pinged": len(asked),
                                                 "pings": pings, "responded": len(healthy),
                                                 "noResponse": len(missing), "passes": passes,
                                                 "respondedIds": sorted(healthy),
                                                 "missingIds": missing})
            finally:
                bridge.unsubscribe(queue)
        finally:
            _health_running = False

    return StreamingResponse(generator(), media_type="text/event-stream",
                             headers={"Cache-Control": "no-cache", "X-Accel-Buffering": "no"})


async def _await_health_reply(queue: asyncio.Queue, board_id: int, timeout: float,
                              healthy: dict[int, dict]) -> dict | None:
    """Wait out one board's reply window, banking any other board's reply that
    happens to arrive in it — a late answer from an earlier pass is still an
    answer, and re-asking a board that already replied wastes a whole timeout."""
    if board_id in healthy:
        return healthy[board_id]

    loop = asyncio.get_event_loop()
    deadline = loop.time() + timeout
    while True:
        remaining = deadline - loop.time()
        if remaining <= 0:
            return None
        try:
            frame = await asyncio.wait_for(queue.get(), timeout=remaining)
        except asyncio.TimeoutError:
            return None
        if frame.get("event") != "client_health":
            continue
        replied = frame.get("boardId")
        if replied is None:
            continue
        healthy[replied] = frame
        if replied == board_id:
            return frame


@app.get("/commandHearth")
async def command_hearth(
    minBurnS: int = Query(default=60),
    maxBurnS: int = Query(default=180),
    minDarkS: int = Query(default=15),
    maxDarkS: int = Query(default=50),
    fadeInMs: int = Query(default=1800),
    fadeOutMs: int = Query(default=2500),
    hue: int = Query(default=20),
    hueVariance: int = Query(default=6),
    saturation: int = Query(default=230),
    brightness: int = Query(default=70),
    flarePercent: int = Query(default=3),
    boardId: int = Query(default=-1),
):
    """Candlelit windows, burning and guttering out on their own, forever."""
    _send({"cmd": "hearth", "minBurnS": minBurnS, "maxBurnS": maxBurnS,
           "minDarkS": minDarkS, "maxDarkS": maxDarkS, "fadeInMs": fadeInMs,
           "fadeOutMs": fadeOutMs, "hue": hue, "hueVariance": hueVariance,
           "saturation": saturation, "brightness": brightness,
           "flarePercent": flarePercent, "boardId": boardId})
    return _ok()


@app.get("/commandBioluminescence")
async def command_bioluminescence(
    minInterval: int = Query(default=2000),
    maxInterval: int = Query(default=8000),
    fadeDuration: int = Query(default=1500),
    repetitions: int = Query(default=0),
    hue: int = Query(default=140),
    hueVariance: int = Query(default=20),
    saturation: int = Query(default=220),
    brightness: int = Query(default=80),
):
    _send({"cmd": "bioluminescence", "minInterval": minInterval, "maxInterval": maxInterval,
           "fadeDuration": fadeDuration, "repetitions": repetitions, "hue": hue,
           "hueVariance": hueVariance, "saturation": saturation, "brightness": brightness})
    return _ok()


@app.get("/commandBreath")
async def command_breath(
    cycleDuration: int = Query(default=4000),
    spreadDelay: int = Query(default=2000),
    repetitions: int = Query(default=0),
    hue: int = Query(default=96),
    saturation: int = Query(default=180),
    brightness: int = Query(default=200),
):
    _send({"cmd": "breath", "cycleDuration": cycleDuration, "spreadDelay": spreadDelay,
           "repetitions": repetitions, "hue": hue, "saturation": saturation, "brightness": brightness})
    return _ok()


@app.get("/commandCandleAll")
async def command_candle_all(
    hue: int = Query(default=20),
    saturation: int = Query(default=210),
    brightness: int = Query(default=180),
):
    _send({"cmd": "candle_all", "hue": hue, "saturation": saturation, "brightness": brightness})
    return _ok()


@app.get("/commandMessage")
async def command_message(boardId: int = Query(...)):
    _send({"cmd": "command_message", "boardId": boardId})
    return _ok()


# ---------------------------------------------------------------------------
# Firmware — OTA serve, upload, compile
# ---------------------------------------------------------------------------

@app.get("/serial-status")
async def serial_status():
    import time
    connected = bridge._serial is not None and bridge._serial.is_open
    now = time.monotonic()
    last = bridge._last_frame_time
    ref = last if last > 0 else bridge._connected_since  # fallback: time since port opened
    stale = connected and ref > 0 and (now - ref) > 30
    return {"connected": connected, "stale": stale, "lastFrameAge": round(now - last) if last > 0 else None}


@app.get("/current-version")
async def current_version():
    try:
        return {"version": fw_compile.read_version()}
    except Exception as e:
        raise HTTPException(500, detail=str(e))


@app.get("/compile-stream")
async def compile_stream(
    request: Request,
    target: str = Query(..., pattern="^(client|master|both)$"),
    incrementVersion: bool = Query(default=False),
) -> StreamingResponse:
    """SSE stream of PlatformIO compile output."""

    async def generator() -> AsyncGenerator[str, None]:
        def emit(line: str) -> str:
            return f"event: compile_log\ndata: {json.dumps(line)}\n\n"

        try:
            yield emit("[pulling latest code…]")
            async for line in fw_compile.git_pull():
                yield emit(line)

            if incrementVersion and target in ("master", "both"):
                old, new = fw_compile.increment_version()
                yield emit(f"[version bumped {old} → {new}]")

            if target in ("client", "both"):
                yield emit("[compiling client…]")
                async for line in fw_compile.compile_client():
                    if await request.is_disconnected():
                        return
                    yield emit(line)
                yield emit("[client done]")

            if target in ("master", "both"):
                yield emit("[compiling & flashing master…]")
                bridge.release_port()
                await asyncio.sleep(0.5)
                try:
                    async for line in fw_compile.compile_master():
                        if await request.is_disconnected():
                            return
                        yield emit(line)
                finally:
                    bridge.resume_port()
                yield emit("[master done]")

            yield f"event: compile_done\ndata: {json.dumps({'success': True})}\n\n"

        except Exception as exc:
            yield emit(f"[ERROR] {exc}")
            yield f"event: compile_done\ndata: {json.dumps({'success': False, 'error': str(exc)})}\n\n"

    return StreamingResponse(
        generator(),
        media_type="text/event-stream",
        headers={"Cache-Control": "no-cache", "X-Accel-Buffering": "no"},
    )


# ---------------------------------------------------------------------------
# Firmware OTA
# ---------------------------------------------------------------------------

# Firmware downloads by board, keyed by the STA MAC that HTTPUpdate sends along,
# so an OTA rollout can tell who is downloading, who is done and who never came
_ota_downloads: dict[str, dict] = {}


@app.get("/firmware.bin")
async def get_firmware(request: Request):
    if not os.path.isfile(FIRMWARE_PATH):
        raise HTTPException(404, detail="No firmware uploaded yet")
    mac = request.headers.get("x-esp32-sta-mac", "").lower()
    if not mac:
        # a browser or curl, not a board
        return FileResponse(FIRMWARE_PATH, media_type="application/octet-stream",
                            filename="firmware.bin")

    with open(FIRMWARE_PATH, "rb") as f:
        image = f.read()
    state = {"size": len(image), "sent": 0, "last": time.monotonic(), "done": False, "current": False}
    _ota_downloads[mac] = state
    # a board already running this exact image is told so instead of sent it
    # again, which keeps a repeated rollout from being a full one
    if request.headers.get("x-esp32-sketch-md5", "").lower() == hashlib.md5(image).hexdigest():
        state.update(done=True, current=True)
        return Response(status_code=304)

    async def chunks():
        try:
            for start in range(0, len(image), 8192):
                yield image[start:start + 8192]
                state["sent"] = min(start + 8192, len(image))
                state["last"] = time.monotonic()
        finally:
            state["done"] = True

    # HTTPUpdate refuses a response without a length
    return StreamingResponse(chunks(), media_type="application/octet-stream",
                             headers={"Content-Length": str(len(image)), "X-Accel-Buffering": "no"})


@app.post("/upload-firmware")
async def upload_firmware(file: UploadFile = File(...)):
    if not file.filename.endswith(".bin"):
        raise HTTPException(400, detail="Expected a .bin file")
    data = await file.read()
    with open(FIRMWARE_PATH, "wb") as f:
        f.write(data)
    logger.info("Firmware uploaded: %d bytes → %s", len(data), FIRMWARE_PATH)
    return JSONResponse({"status": True, "size": len(data)})


# ---------------------------------------------------------------------------
# Keyboard / MIDI player
# ---------------------------------------------------------------------------

_SONGS_DIR        = os.environ.get("SPARKLES_SONGS_DIR", "/home/julian/sparkles/songs")
_KEYBOARD_CMD_SOCK = os.environ.get("SPARKLES_KEYBOARD_SOCK", "/tmp/keyboard_cmd.sock")

# current playback state, so the (login-free) karaoke page can poll it and clear
# itself when a song stops — including when a key press on the keyboard stops it
_playback = {"song": None, "playing": False}


def _keyboard_cmd(cmd: dict):
    """Send a command to keyboard_midi.py via its Unix socket."""
    import socket as _socket
    try:
        s = _socket.socket(_socket.AF_UNIX, _socket.SOCK_STREAM)
        s.settimeout(2.0)
        s.connect(_KEYBOARD_CMD_SOCK)
        s.sendall((json.dumps(cmd) + "\n").encode())
        s.close()
    except Exception as exc:
        raise HTTPException(503, detail=f"keyboard_midi not reachable: {exc}")


@app.get("/keyboard/songs")
async def keyboard_songs():
    """List available MIDI files in the songs directory."""
    if not os.path.isdir(_SONGS_DIR):
        return {"songs": []}
    files = sorted(
        f for f in os.listdir(_SONGS_DIR)
        if f.lower().endswith(".mid") or f.lower().endswith(".midi")
    )
    return {"songs": files}


@app.post("/keyboard/play")
async def keyboard_play(song: str = Query(...)):
    _keyboard_cmd({"cmd": "play", "file": song})
    _playback.update(song=song, playing=True)

    async def _announce():
        try:
            await _mesh_send(f"🎤 karaoke: {song}", MESH_CHANNEL)
        except Exception as exc:
            logger.warning("karaoke relay failed: %s", exc)
    asyncio.create_task(_announce())
    return _ok()


@app.post("/keyboard/stop")
async def keyboard_stop():
    _keyboard_cmd({"cmd": "stop"})
    _playback.update(playing=False)
    return _ok()


@app.get("/keyboard/status")
async def keyboard_status():
    """Current playback state — polled by the karaoke page so it clears when a
    song stops (including when a key press on the keyboard stops it)."""
    return _playback


@app.post("/internal/keyboard_event")
async def keyboard_event(request: Request):
    """Receive status callbacks from keyboard_midi.py and fan out via SSE."""
    body = await request.json()
    if body.get("event") == "keyboard_playback" and body.get("status") in ("stopped", "finished", "error"):
        _playback.update(playing=False)
    bridge._dispatch(body)
    return {"ok": True}


# ---------------------------------------------------------------------------
# Muse headband → lamps (test rig)
# ---------------------------------------------------------------------------

_MUSE_DIR = os.path.dirname(os.path.abspath(__file__))
# Whether the pi listens for the headband, and with what settings. On disk so
# that listening survives a restart or a reboot: switching the headband on and
# putting it on is all a visitor should have to do.
_BRAIN_PATH = os.environ.get("SPARKLES_BRAIN", os.path.join(_MUSE_DIR, "brain.json"))
# How much each signal counts toward the lamps, as Brain page presets. Saved
# ones join them in brain.json; these cannot be overwritten or deleted.
_BRAIN_SIGNALS = ("alpha", "beta", "theta", "bpm", "still", "emg")
_BRAIN_PRESETS = {
    # a calm body alone must not light the room: it averages 0.57 here, under
    # the 0.6 bias, while relaxing for real reaches 0.70
    "Brain waves":      {"alpha": 2, "beta": 2, "theta": 0, "bpm": 0.5, "still": 0.25, "emg": 0.25},
    "Deep meditation":  {"alpha": 2, "beta": 1, "theta": 2, "bpm": 0.5, "still": 0.25, "emg": 0.25},
    "Calm body":        {"alpha": 0.5, "beta": 0.5, "theta": 0, "bpm": 2, "still": 1, "emg": 2},
    "Everything equal": {"alpha": 1, "beta": 1, "theta": 1, "bpm": 1, "still": 1, "emg": 1},
}
_BRAIN_DEFAULTS = {"ppg": True, "anchor": 40.0, "start": 0.3, "up": 0.1, "down": 0.15,
                   "bias": 0.6, "minValue": 13, "maxValue": 200,
                   # a USB dongle whenever one is plugged in, else the built-in
                   "adapter": "auto",
                   "weights": dict(_BRAIN_PRESETS["Brain waves"])}
# proc is the shell running `muse.py | muse_bridge.py`, so it owns two children
# and has to be killed by process group, not pid. task keeps it running.
_brain = {"proc": None, "task": None, "status": {}, "started": 0.0}


def _brain_load() -> dict:
    try:
        with open(_BRAIN_PATH) as f:
            saved = json.load(f)
    except Exception:
        saved = {}
    settings = {**_BRAIN_DEFAULTS, **saved.get("settings", {})}
    settings["weights"] = {**_BRAIN_DEFAULTS["weights"], **settings.get("weights", {})}
    return {"listening": bool(saved.get("listening", False)), "settings": settings,
            "presets": saved.get("presets", {})}


def _brain_save():
    try:
        with open(_BRAIN_PATH, "w") as f:
            json.dump(_brain_config, f, indent=2)
    except Exception as exc:
        logger.warning("could not save %s: %s", _BRAIN_PATH, exc)


_brain_config = _brain_load()


def _brain_running() -> bool:
    """The pipeline is up right now, so commands can reach it."""
    p = _brain["proc"]
    return bool(p and p.returncode is None)


def _brain_listening() -> bool:
    t = _brain["task"]
    return bool(t and not t.done())


async def _brain_pump(proc):
    """Fan muse_bridge's status lines out on /events so the page can watch the
    score climb. stderr is left attached to ours, so the two scripts' logs land
    in `journalctl -u sparkles` where you want them when this misbehaves."""
    try:
        async for raw in proc.stdout:
            try:
                frame = json.loads(raw.decode(errors="replace").strip())
            except ValueError:
                continue
            _brain["status"] = frame
            _brain_hold_music(bool(frame.get("worn")))
            bridge._dispatch(frame)
    except asyncio.CancelledError:
        raise
    except Exception as exc:
        logger.warning("brain pump ended: %s", exc)
    finally:
        _brain_hold_music(False)
        bridge._dispatch({"event": "brain_status", "phase": "stopped", "settle": 0.0})


def _brain_hold_music(worn: bool):
    """While the headband is on a head the lamps are its: pitch detection and
    the keyboard are held off them. The pump ending, by Stop, the headband
    coming off or a crash, always hands them back."""
    if bridge.music_paused != worn:
        bridge.music_paused = worn
        logger.info("headband %s a head — pitch detection and keyboard %s",
                    "on" if worn else "off", "held off the lamps" if worn else "back")


async def _brain_spawn():
    s = _brain_config["settings"]
    muse = [sys.executable, "-u", os.path.join(_MUSE_DIR, "muse.py"), "--json",
            "--anchor", str(s["anchor"]), "--start", str(s["start"]), "--up", str(s["up"]),
            "--down", str(s["down"]), "--bias", str(s["bias"])]
    if s["ppg"]:
        muse.append("--ppg")
    if s.get("adapter"):
        muse += ["--adapter", s["adapter"]]
    muse += ["--weights", ",".join(f"{k}={v}" for k, v in s["weights"].items())]
    bridge_cmd = [sys.executable, "-u", os.path.join(_MUSE_DIR, "muse_bridge.py"),
                  "--status", "--min-value", str(s["minValue"]),
                  "--max-value", str(max(s["maxValue"], s["minValue"] + 1))]
    cmd = "%s | %s" % (" ".join(shlex.quote(a) for a in muse),
                       " ".join(shlex.quote(a) for a in bridge_cmd))
    # stdin reaches muse.py, the first command in the pipe, and carries the
    # page's commands to it (brain_reset, brain_tune)
    proc = await asyncio.create_subprocess_shell(
        cmd, stdin=asyncio.subprocess.PIPE, stdout=asyncio.subprocess.PIPE,
        start_new_session=True)
    _brain.update(proc=proc, started=time.monotonic(),
                  status={"event": "brain_status", "phase": "waiting", "settle": 0.0})
    logger.info("listening for the headband: %s", cmd)
    return proc


async def _brain_kill(proc):
    try:
        os.killpg(os.getpgid(proc.pid), signal.SIGTERM)
        try:
            await asyncio.wait_for(proc.wait(), timeout=5)
        except asyncio.TimeoutError:
            os.killpg(os.getpgid(proc.pid), signal.SIGKILL)
    except ProcessLookupError:
        pass


async def _brain_supervise():
    """Keep the pipeline up for as long as listening is on. It never ends by
    itself, so an exit is a crash, or a hand run holding the headband's lock,
    and is restarted, backing off while it keeps dying straight away."""
    delay = 5.0
    while True:
        try:
            proc = await _brain_spawn()
        except Exception as exc:
            logger.warning("could not start muse: %s — trying again in %.0fs", exc, delay)
            await asyncio.sleep(delay)
            delay = min(delay * 2, 60.0)
            continue
        started = time.monotonic()
        pump = asyncio.create_task(_brain_pump(proc))
        try:
            await proc.wait()
            await pump
        except asyncio.CancelledError:
            await _brain_kill(proc)
            pump.cancel()
            raise
        ran = time.monotonic() - started
        delay = 5.0 if ran > 60 else min(delay * 2, 60.0)
        logger.warning("muse pipeline exited (%s) after %.0fs — restarting in %.0fs",
                       proc.returncode, ran, delay)
        await asyncio.sleep(delay)


def _brain_listen():
    _brain["task"] = asyncio.create_task(_brain_supervise())


@app.post("/brain/start")
async def brain_start(
    ppg: bool = Query(default=True),
    anchor: float = Query(default=40.0, ge=5.0, le=300.0),
    start: float = Query(default=0.3, ge=0.0, le=0.95),
    up: float = Query(default=0.1, ge=0.005, le=2.0),
    down: float = Query(default=0.15, ge=0.005, le=2.0),
    bias: float = Query(default=0.6, ge=0.3, le=0.9),
    minValue: int = Query(default=13, ge=0, le=254),
    maxValue: int = Query(default=200, ge=1, le=255),
):
    """Listen for the headband: whenever someone wears it, their settling score
    drives every lamp's brightness, and the microphone and keyboard wait.

    Stays on through restarts and reboots until Stop. No positions, no
    distance — one broadcast, whatever is powered on lights up.
    """
    if _brain_listening():
        raise HTTPException(409, detail="already listening")
    # merged, not replaced: the page does not send everything (the adapter)
    _brain_config["listening"] = True
    _brain_config["settings"].update({
        "ppg": ppg, "anchor": anchor, "start": start, "up": up, "down": down,
        "bias": bias, "minValue": minValue, "maxValue": max(maxValue, minValue + 1)})
    _brain_save()
    _brain_listen()
    return _ok("listening for the headband")


@app.post("/brain/stop")
async def brain_stop():
    """Stop listening, and stay stopped through restarts. The lamps are not
    sent anything: without frames they fade out on their own."""
    _brain_config["listening"] = False
    _brain_save()
    task = _brain["task"]
    if not _brain_listening():
        return _ok("not listening")
    task.cancel()
    try:
        await task
    except asyncio.CancelledError:
        pass
    _brain.update(proc=None, task=None, status={})
    logger.info("stopped listening for the headband")
    return _ok("stopped listening")


@app.post("/brain/reset")
async def brain_reset():
    """Learn the visitor's baseline again, keeping the headband link."""
    if not _brain_running():
        raise HTTPException(409, detail="not listening for the headband right now")
    try:
        _brain["proc"].stdin.write(b"reset\n")
        await _brain["proc"].stdin.drain()
    except Exception as exc:
        raise HTTPException(500, detail=f"could not reach muse: {exc}")
    logger.info("brain baseline reset")
    return _ok("baseline reset")


def _brain_weights_from(body) -> dict:
    if not isinstance(body, dict) or not body:
        raise HTTPException(400, detail="weights: a {signal: weight} object")
    weights = {}
    for name, value in body.items():
        if name not in _BRAIN_SIGNALS:
            raise HTTPException(400, detail=f"unknown signal {name!r}")
        try:
            weights[name] = round(min(3.0, max(0.0, float(value))), 2)
        except (TypeError, ValueError):
            raise HTTPException(400, detail=f"weight for {name} is not a number")
    return weights


@app.post("/brain/weights")
async def brain_weights(request: Request):
    """How much each signal counts, from the page's sliders or a preset: kept
    for every later start, and handed to the running pipeline at once."""
    weights = _brain_weights_from(await request.json())
    _brain_config["settings"]["weights"].update(weights)
    _brain_save()
    if _brain_running():
        await _brain_command("".join(f"set weight {k} {v}\n" for k, v in weights.items()))
    return _ok("weighted")


@app.get("/brain/presets")
async def brain_presets():
    return {"builtin": _BRAIN_PRESETS, "saved": _brain_config["presets"]}


@app.post("/brain/presets")
async def brain_preset_save(request: Request):
    body = await request.json()
    name = str(body.get("name", "")).strip() if isinstance(body, dict) else ""
    if not 0 < len(name) <= 40:
        raise HTTPException(400, detail="a preset needs a name of up to 40 characters")
    if name in _BRAIN_PRESETS:
        raise HTTPException(409, detail=f"{name!r} is a built-in preset")
    weights = _brain_weights_from(body.get("weights"))
    _brain_config["presets"][name] = {**dict.fromkeys(_BRAIN_SIGNALS, 0.0), **weights}
    _brain_save()
    return _ok("saved")


@app.delete("/brain/presets/{name}")
async def brain_preset_delete(name: str):
    if _brain_config["presets"].pop(name, None) is None:
        raise HTTPException(404, detail="no such saved preset")
    _brain_save()
    return _ok("deleted")


@app.post("/brain/tune")
async def brain_tune(
    start: float | None = Query(default=None, ge=0.0, le=0.95),
    up: float | None = Query(default=None, ge=0.005, le=2.0),
    down: float | None = Query(default=None, ge=0.005, le=2.0),
):
    """Change the lamp curve, for the page's sliders: kept for every later
    start, and handed to the running pipeline at once if there is one."""
    changed = {name: value for name, value in (("start", start), ("up", up), ("down", down))
               if value is not None}
    _brain_config["settings"].update(changed)
    _brain_save()
    if not _brain_running():
        return _ok("saved")
    lines = "".join(f"set {name} {value}\n" for name, value in changed.items())
    try:
        _brain["proc"].stdin.write(lines.encode())
        await _brain["proc"].stdin.drain()
    except Exception as exc:
        raise HTTPException(500, detail=f"could not reach muse: {exc}")
    return _ok("tuned")


# guided tests, recorded by muse.py into this directory for scoring offline
_BRAIN_RECORDINGS = os.environ.get("SPARKLES_RECORDINGS", os.path.join(_MUSE_DIR, "recordings"))
_BRAIN_TESTS = ("meditation", "desk", "talk")


async def _brain_command(line: str):
    if not _brain_running():
        raise HTTPException(409, detail="not listening for the headband right now")
    try:
        _brain["proc"].stdin.write(line.encode())
        await _brain["proc"].stdin.drain()
    except Exception as exc:
        raise HTTPException(500, detail=f"could not reach muse: {exc}")


@app.post("/brain/record")
async def brain_record(label: str = Query(...),
                       seconds: float = Query(default=180.0, ge=30.0, le=900.0)):
    """A guided test: baseline learned again, then `seconds` of the condition,
    everything recorded raw and summed up at the end."""
    if label not in _BRAIN_TESTS:
        raise HTTPException(400, detail=f"label must be one of {', '.join(_BRAIN_TESTS)}")
    await _brain_command(f"record {label} {seconds:.0f}\n")
    logger.info("brain %s test started, %.0fs", label, seconds)
    return _ok("recording")


@app.post("/brain/record/stop")
async def brain_record_stop():
    await _brain_command("record stop\n")
    return _ok("stopped")


@app.get("/brain/recordings")
async def brain_recordings():
    try:
        names = sorted((n for n in os.listdir(_BRAIN_RECORDINGS) if n.endswith(".jsonl")),
                       reverse=True)
    except FileNotFoundError:
        names = []
    return [{"name": n, "bytes": os.path.getsize(os.path.join(_BRAIN_RECORDINGS, n))}
            for n in names]


@app.get("/brain/recordings/{name}")
async def brain_recording(name: str):
    if "/" in name or not name.endswith(".jsonl"):
        raise HTTPException(400, detail="bad recording name")
    path = os.path.join(_BRAIN_RECORDINGS, name)
    if not os.path.isfile(path):
        raise HTTPException(404, detail="no such recording")
    return FileResponse(path, media_type="application/x-ndjson", filename=name)


@app.get("/brain/devices")
async def brain_devices(timeout: float = Query(default=5.0, ge=1.0, le=15.0)):
    """Is the headband on and reachable right now?

    A BLE scan disturbs an active connection, so while the test is running we
    report what that session already knows instead of scanning over the top
    of it. Note an empty list is ambiguous: a Muse that is already connected
    to something stops advertising, so "not found" means off OR taken.
    """
    if _brain_running():
        st = _brain["status"]
        return {"scanned": False, "running": True, "devices": [],
                "contact": st.get("contact", 0), "phase": st.get("phase", "waiting")}

    cmd = [sys.executable, "-u", os.path.join(_MUSE_DIR, "muse.py"), "--scan", "--json"]
    if _brain_config["settings"].get("adapter"):
        cmd += ["--adapter", _brain_config["settings"]["adapter"]]
    try:
        proc = await asyncio.create_subprocess_exec(
            *cmd, stdout=asyncio.subprocess.PIPE, stderr=asyncio.subprocess.PIPE)
        out, err = await asyncio.wait_for(proc.communicate(), timeout=timeout + 15)
    except asyncio.TimeoutError:
        try:
            proc.kill()
        except ProcessLookupError:
            pass
        raise HTTPException(504, detail="bluetooth scan timed out")
    except Exception as exc:
        raise HTTPException(500, detail=f"could not scan: {exc}")

    lines = [l for l in out.decode(errors="replace").splitlines() if l.strip()]
    if not lines:
        detail = err.decode(errors="replace").strip()[-300:] or "no output from scan"
        raise HTTPException(502, detail=detail)
    try:
        devices = json.loads(lines[-1])
    except ValueError:
        raise HTTPException(502, detail=f"unexpected scan output: {lines[-1][:200]}")
    return {"scanned": True, "running": False, "devices": devices}


@app.get("/brain/status")
async def brain_status():
    # running is whether the pi listens for the headband, which is what the
    # page's Start/Stop shows; the pipeline itself may be restarting
    running = _brain_listening()
    # Pass the whole last frame through rather than hand-picking fields. Every
    # field muse_bridge adds otherwise needs plumbing here as well, and when
    # that is missed the page just sees undefined and draws something wrong --
    # which is exactly how "connecting..." survived an active connection.
    st = dict(_brain["status"]) if _brain_running() else {}
    st.pop("event", None)
    st["running"] = running
    # only settings the pi has actually saved: its defaults, sent before the
    # first Start, overwrote what the page had been tuned to
    if os.path.exists(_BRAIN_PATH):
        st["settings"] = _brain_config["settings"]
    st["uptime"] = round(time.monotonic() - _brain["started"], 1) if running else 0.0
    for key, default in (("settle", 0.0), ("value", 0), ("session", 0.0),
                         ("contact", 0), ("connected", False), ("channels", {}),
                         ("bpm", None), ("battery", None)):
        st.setdefault(key, default)
    st.setdefault("phase", "waiting" if running else "stopped")
    return st


_build_dir = os.path.join(os.path.dirname(__file__), "..", "sparkles-ui", "build")
_index_html = os.path.join(_build_dir, "index.html")

if os.path.isdir(_build_dir):
    _build_root = os.path.realpath(_build_dir)

    # Serve static assets normally
    app.mount("/_app", StaticFiles(directory=os.path.join(_build_dir, "_app")), name="assets")

    # SPA catch-all: serve the file if it exists, otherwise index.html
    @app.get("/{full_path:path}")
    async def spa_fallback(full_path: str):
        # realpath + prefix check keeps ../ and absolute paths inside the build dir
        candidate = os.path.realpath(os.path.join(_build_root, full_path))
        if candidate.startswith(_build_root + os.sep) and os.path.isfile(candidate):
            return FileResponse(candidate)
        return FileResponse(_index_html)
