hdsjulian/sparkles/src/Client-Device/main.cpp

#include <Arduino.h>
#include <MyDefines.h>
#include <esp_log.h>
#include "esp_now.h"
#include <LittleFS.h>
#include "WiFi.h"
#include <LedHandler.h>
#include <MessageHandler.h>
#include <Version.h>
#include "esp_sleep.h"
#include "soc/rtc.h"
#include <Ota.h>
// put function declarations here:


LedHandler& ledInstance = LedHandler::getInstance();
MessageHandler& msgHandler = MessageHandler::getInstance();

uint8_t myAddress[6];

// state
bool lfs_started = true;

void OnDataRecv(const esp_now_recv_info *mac, const uint8_t *incomingData, int len) {
ESP_LOGI("Received", "Data at %d", micros());

}

void OnDataSent(const uint8_t *mac_addr, esp_now_send_status_t sendStatus) {}
unsigned long lastTick = 0;
int tickCount = 0;
float bootBatteryVolts = 0;
unsigned long lastBootBatteryLog = 0;

// upload_client.py looks for this line after flashing a board
static void logBootBattery() {
  ESP_LOGI("BATTERY", "boot reading %.2f V, %.0f%%", bootBatteryVolts,
           MessageHandler::batteryPercentageFromVoltage(bootBatteryVolts));
}

extern uint32_t g_lightSleepMarker; // crash breadcrumb, see MessageHandler_client.cpp

static const char* resetReasonName(esp_reset_reason_t r) {
  switch (r) {
    case ESP_RST_POWERON:   return "POWERON";
    case ESP_RST_EXT:       return "EXT";
    case ESP_RST_SW:        return "SW";
    case ESP_RST_PANIC:     return "PANIC";
    case ESP_RST_INT_WDT:   return "INT_WDT";
    case ESP_RST_TASK_WDT:  return "TASK_WDT";
    case ESP_RST_WDT:       return "WDT";
    case ESP_RST_DEEPSLEEP: return "DEEPSLEEP";
    case ESP_RST_BROWNOUT:  return "BROWNOUT";
    default:                return "UNKNOWN";
  }
}

void setup()
{
  Serial.begin(115200);
  Serial.setTxTimeoutMs(0); // non-blocking CDC writes — drop bytes rather than hang
  esp_log_level_set("*", ESP_LOG_INFO);
  esp_log_level_set("LED", ESP_LOG_NONE);
  // One line per received frame is far too much during a timer burst or a chirp
  // calibration: Serial.setTxTimeoutMs(0) means a full CDC buffer drops bytes,
  // so the RX flood was discarding the CLAP diagnostics mid-line.
  esp_log_level_set("RX", ESP_LOG_NONE);
  delay(100);
  ESP_LOGW("BOOT", "reset reason: %s (%d)", resetReasonName(esp_reset_reason()), (int)esp_reset_reason());
  // the wake path can't report its own death (USB still re-enumerating), so the
  // sleep loop leaves a breadcrumb in RTC memory and we read it here instead
  if (g_lightSleepMarker == 0xA55A0001u) {
    ESP_LOGE("BOOT", "previous boot DIED DURING LIGHT SLEEP (or instantly at wake)");
  } else if (g_lightSleepMarker == 0xA55A0002u) {
    ESP_LOGE("BOOT", "previous boot DIED IN THE WAKE PATH (Serial/WiFi re-init)");
  }
  g_lightSleepMarker = 0;
  // before the radio and the LEDs are on, see measureBatteryVoltage()
  bootBatteryVolts = msgHandler.measureBatteryVoltage();
  logBootBattery();
  if (!LittleFS.begin(true)) // format on fail — the crash-reboots corrupted at least one board's fs
  {
    Serial.println("LittleFS mount failed");
    lfs_started = false;
  }

  // Light-sleep timing runs on the default RC_SLOW clock, deliberately:
  // - 8MD256 hangs the sleep entry/exit sync (INT_WDT reset, found via the
  //   RTC crash breadcrumb)
  // - the populated 32k xtal is dead on half the boards, and a marginal one
  //   stalling mid-nap would strand a board asleep forever
  // - accuracy stopped mattering with chunked sleep: ±3% on a 5 min nap is
  //   seconds, and every rebroadcast carries a fresh duration anyway
  WiFi.mode(WIFI_STA);
  // This board talks ESP-NOW and never needs to join an AP. Any credentials in
  // NVS are left over from an OTA attempt — including the automatic one the
  // master triggers on a version mismatch — and turnWifiOn()'s bare
  // WiFi.begin() after a nap would spend the rest of the night hunting for
  // them. Clear them, and never write any again.
  WiFi.persistent(false);
  WiFi.disconnect(false, true);   // eraseap
  WiFi.setSleep(false); // modem sleep adds RX latency and skews hardware RX timestamps
  ESP_LOGI("", "Setup1");
  // A warm ESP.restart() leaves the wifi driver part-way through teardown, so
  // esp_now_init() can fail here where it succeeds on a cold boot. setup() used
  // to give up and return on that — starting no tasks at all and leaving the
  // board powered but completely inert, which is why "reboot all" stranded
  // boards that the physical reset button brought back fine. Retry, and if it
  // truly will not come up, reboot rather than sit there dead.
  esp_err_t nowErr = ESP_FAIL;
  for (int attempt = 0; attempt < 10 && nowErr != ESP_OK; attempt++) {
    esp_now_deinit();               // no-op if it was never up
    nowErr = esp_now_init();
    if (nowErr != ESP_OK) {
      ESP_LOGW("BOOT", "esp_now_init failed (%d), retry %d/10", (int)nowErr, attempt + 1);
      delay(200);
    }
  }
  if (nowErr != ESP_OK) {
    ESP_LOGE("BOOT", "esp_now_init never came up, restarting");
    delay(500);
    ESP.restart();
  }
  delay(1000);
  ledInstance.setup();
  msgHandler.setup(ledInstance);
  ESP_LOGI("", "Setup");
  ledInstance.batteryBlink(MessageHandler::batteryPercentageFromVoltage(bootBatteryVolts));

  // put your setup code here, to run once:
}

void loop()
{
  // again for the first 20 s: after an upload the port is only reopened once the
  // board is back from the reset, and the line from setup() is gone by then
  if (millis() < 20000 && millis() - lastBootBatteryLog >= 1000) {
    lastBootBatteryLog = millis();
    logBootBattery();
  }
  if (lastTick + 10000 < millis())
  {
    lastTick = millis();
    uint8_t address[6];
    WiFi.macAddress(address);
    ESP_LOGI("", "Tick %s", msgHandler.stringAddress(address, true).c_str());
    ESP_LOGI("", "Current Time %llu", micros());
    ESP_LOGI("", "Battery: %.2f%%", msgHandler.getBatteryPercentage());
    ESP_LOGI("", "Version: %s", VERSION);
    msgHandler.logRxCounts();


  }
  // put your main code here, to run repeatedly:
}
