hdsjulian/sparkles/sparkles-api/test_muse.py

#!/usr/bin/env python3
"""
Tests for the Muse headband pipeline — muse.py and muse_bridge.py.

No hardware needed: the BLE side runs against a fake BleakClient that
misbehaves the way the real headband did — late acks, connects that fail or
hang, dropped packets, a sparkles restart under the bridge. Each of those
was a real bug; these are here so they stay fixed.

Usage:
    python3 test_muse.py
"""

import asyncio
import io
import json
import math
import os
import signal
import socket
import subprocess
import sys
import tempfile
import threading
import time

HERE = os.path.dirname(os.path.abspath(__file__))
sys.path.insert(0, HERE)

# both scripts parse argv at import
sys.argv = ["muse.py", "--json", "--preset", "p21"]
import muse  # noqa: E402
SOCK = "/tmp/sparkles_test_music.sock"
sys.argv = ["muse_bridge.py", "--sock", SOCK]
import muse_bridge  # noqa: E402

G, R, X = "\033[32m", "\033[31m", "\033[0m"
failures = []


def check(name, cond, detail=""):
    print(f"  {G}✓{X} {name}" if cond else f"  {R}✗{X} {name}  {detail}")
    if not cond:
        failures.append(name)


def decode():
    print("decode")
    vals = [0, 2048, 4095, 1024, 3072, 100, 200, 300, 400, 500, 600, 700]
    bits = 0
    for v in vals:
        bits = (bits << 12) | v
    got = muse._unpack_eeg((7).to_bytes(2, "big") + bits.to_bytes(18, "big"))
    check("12-bit eeg samples", all(abs(g - (v - 2048) * muse.EEG_LSB) < 1e-9
                                    for g, v in zip(got, vals)))
    check("control frames", muse._cmd("d") == b"\x02d\n")


def settle():
    print("settle scoring")
    import random
    rng = random.Random(0)
    n = lambda v, p: v * (1 + rng.uniform(-p, p))
    calm_brain = lambda: {"alpha": n(0.34, .10), "beta": n(0.20, .10), "theta": n(0.20, .10)}
    arrival_brain = lambda: {"alpha": n(0.20, .10), "beta": n(0.30, .10), "theta": n(0.20, .10)}
    arrival = lambda: {**arrival_brain(), "still": n(0.010, .15),
                       "emg": n(100.0, .15), "bpm": n(74.0, .04)}
    relaxed = lambda: {**calm_brain(), "still": n(0.003, .15),
                       "emg": n(30.0, .15), "bpm": n(63.0, .04)}
    # a game: sitting stiller and looser-jawed than on arrival, mind working
    gaming = lambda: {"alpha": n(0.12, .10), "beta": n(0.40, .10), "theta": n(0.20, .10),
                      "still": n(0.003, .15), "emg": n(30.0, .15), "bpm": n(74.0, .04)}
    body_only = lambda: {**relaxed(), **arrival_brain()}
    fidgeting = lambda: {**calm_brain(), "still": n(0.030, .15),
                         "emg": n(300.0, .15), "bpm": n(84.0, .04)}

    def run(frames, secs):
        s, t = muse.Settle(), 0.0
        for _ in range(int(muse.args.anchor / 0.1)):
            t += 0.1
            s.update(t, 0.1, True, arrival())
        out = None
        for _ in range(int(secs / 0.1)):
            t += 0.1
            out = s.update(t, 0.1, True, frames())
        return out

    check("genuine settling lights up", run(relaxed, 150)["settle"] > 0.8)
    check("sitting still while concentrating does not", run(gaming, 180)["settle"] < 0.15)
    check("nor does a calm body on its own", run(body_only, 180)["settle"] < 0.15)
    check("calm brain waves in a fidgeting body are held back",
          run(fidgeting, 180)["settle"] < 0.15)
    check("staying as you arrived earns nothing", run(arrival, 180)["settle"] < 0.15)

    # the weights decide what counts: weighted to the body alone, a calm body
    # does light the room
    saved_weights = dict(muse.WEIGHTS)
    muse.WEIGHTS.update(alpha=0, beta=0, theta=0, bpm=2, still=1, emg=2)
    try:
        check("weighted to the body, a calm body lights it", run(body_only, 150)["settle"] > 0.8)
    finally:
        muse.WEIGHTS.clear()
        muse.WEIGHTS.update(saved_weights)

    def anchored():
        s, t, half = muse.Settle(), 0.0, None
        for i in range(int(muse.args.anchor / 0.1) + 5):
            t += 0.1
            out = s.update(t, 0.1, True, arrival())
            if i == int(muse.args.anchor / 0.2):
                half = out["settle"]
        return s, t, half, out["settle"]

    # a session comes up to its starting level while the baseline is learned
    s, t, half, level = anchored()
    check("the lamps come up while the baseline is learned",
          abs(half - muse.args.start / 2) < 0.02, f"{half:.3f} halfway through")
    check("and a session starts at the chosen level",
          abs(level - muse.args.start) < 0.01, f"{level:.3f}")

    # from there the climb is quick at first, flattening toward full, read
    # every 10 s of steady calm
    levels = [level]
    for _ in range(4):
        for _ in range(100):
            t += 0.1
            out = s.update(t, 0.1, True, relaxed())
        levels.append(out["settle"])
    gains = [b - a for a, b in zip(levels, levels[1:])]
    check("the climb is quick at first and flattens toward full",
          all(a > b > 0 for a, b in zip(gains, gains[1:])) and levels[-1] < 1.0,
          [round(v, 3) for v in levels])

    # and getting tenser than you arrived dims it from the start
    tense = lambda: {"alpha": n(0.12, .10), "beta": n(0.40, .10), "theta": n(0.20, .10),
                     "still": n(0.030, .15), "emg": n(300.0, .15), "bpm": n(84.0, .04)}
    s, t, _, level = anchored()
    for _ in range(100):
        t += 0.1
        out = s.update(t, 0.1, True, tense())
    check("getting tenser than you arrived dims the lamps", out["settle"] < 0.6 * level,
          f"{level:.2f} -> {out['settle']:.2f} in 10 s")

    # a dropped link takes 16-19s to come back, and that is not a new visitor
    s, t = muse.Settle(), 0.0
    for _ in range(int(muse.args.anchor / 0.1) + 5):
        t += 0.1
        s.update(t, 0.1, True, arrival())
    t += 20.0
    out = s.update(t, 0.1, True, arrival())
    check("a reconnect keeps the visitor", out["phase"] == "live", out["phase"])
    t += muse.LINK_GRACE + 1
    out = s.update(t, 0.1, True, arrival())
    check("a long outage starts a new visitor", out["phase"] == "anchor", out["phase"])


def adapters():
    print("which Bluetooth radio")
    root = tempfile.mkdtemp()

    def radio(name, bus, blocked=False):
        os.makedirs(os.path.join(root, "devices", bus, name))
        os.makedirs(os.path.join(root, "bt", name, "rfkill0"))
        os.symlink(os.path.join(root, "devices", bus, name), os.path.join(root, "bt", name, "device"))
        for flag in ("soft", "hard"):
            open(os.path.join(root, "bt", name, "rfkill0", flag), "w").write("1" if blocked and flag == "soft" else "0")

    saved = (muse.SYS_BLUETOOTH, muse.args.adapter, muse.adapter)
    muse.SYS_BLUETOOTH, muse.args.adapter = os.path.join(root, "bt"), "auto"
    try:
        radio("hci0", "serial0")                      # built-in, first in the list
        os.makedirs(os.path.join(root, "bt", "hci0:16"))   # a connection, not a radio
        check("without a dongle, the built-in radio", muse._choose_adapter() == "hci0")
        radio("hci1", "usb3/3-1")
        check("a dongle plugged in always wins", muse._choose_adapter() == "hci1")
        open(os.path.join(root, "bt", "hci1", "rfkill0", "soft"), "w").write("1")
        check("but not while it is switched off", muse._choose_adapter() == "hci0")
        check("and the choice goes to bleak", muse._bluez() == {"adapter": "hci0"})
    finally:
        muse.SYS_BLUETOOTH, muse.args.adapter, muse.adapter = saved


def life():
    print("a head, not a table")
    np = muse.np
    t = np.arange(512) / muse.PPG_FS
    hiss = np.random.default_rng(0).normal(0, 50, 512)
    beat = muse._pulse_clarity(list(2000 + 300 * np.sin(2 * np.pi * 1.2 * t) + hiss))
    table = muse._pulse_clarity(list(2000 + hiss))
    check("a heartbeat under the pulse sensor is plain", beat > 100, beat)
    check("a table shows none", table < 20, table)
    check("lying on a table is not a head", not muse._alive(0.0022, 4.0))
    check("sitting still with a pulse is", muse._alive(0.0028, 300.0))
    check("putting it on blurs the pulse, but it moves", muse._alive(0.015, 8.0))
    check("no pulse data leaves it to the electrodes", muse._alive(0.0027, None))


def contact():
    print("contact, with numbers from a real head and a real table")
    m = muse.Muse()
    on = ({"TP9": 220, "AF7": 595, "AF8": 331, "TP10": 214},       # firmly on, at a screen
          {"TP9": 6e4, "AF7": 6e6, "AF8": 1e6, "TP10": 6e4})
    check("a frowning forehead is still on a head",
          sorted(m._contact(*on)) == sorted(muse.EEG_CHANS), m._contact(*on))
    table = ({"TP9": 484, "AF7": 449, "AF8": 374, "TP10": 524},    # lying there, hissing
             {"TP9": 5e6, "AF7": 2.9e6, "AF8": 3.6e6, "TP10": 4e6})
    check("lying on the table nothing is", m._contact(*table) == [], m._contact(*table))
    tonight = ({"TP9": 205, "AF7": 1106, "AF8": 367, "TP10": 407},  # firmly on, read 2/4
               {"TP9": 7e4, "AF7": 1e6, "AF8": 2e5, "TP10": 1e6})
    check("a loud left forehead and a noisy right ear still make 4/4",
          sorted(m._contact(*tonight)) == sorted(muse.EEG_CHANS), m._contact(*tonight))
    one = ({"TP9": 220, "AF7": 595, "AF8": 331, "TP10": 300},      # hair under one ear
           {"TP9": 6e4, "AF7": 6e6, "AF8": 1e6, "TP10": 4e6})
    check("one ear on is enough to trust the forehead",
          sorted(m._contact(*one)) == ["AF7", "AF8", "TP9"], m._contact(*one))
    check("and the lifted ear's hiss is not taken for a clenched jaw",
          m._emg(one[1], m._contact(*one)) == 6e4, m._emg(one[1], m._contact(*one)))


def steady():
    print("steady brain signal")
    m, t = muse.Muse(), 100.0

    def fill(n, level):
        m.signal.clear()
        for i in range(120):
            m.signal.append((t + i * 0.1, n, level(i)))

    fill(4, lambda i: 400 - 2.5 * i)
    check("electrodes still settling onto the skin are not steady", not m._steady(t + 12))
    fill(4, lambda i: 50 + i % 3)
    check("a level that holds on enough electrodes is", m._steady(t + 12))
    fill(2, lambda i: 50)
    check("two electrodes are not enough", not m._steady(t + 12))
    fill(4, lambda i: 50)
    check("nor is a few seconds of it", not m._steady(t + 5))

    s = muse.Settle()
    out = s.update(1.0, 0.1, True, {"alpha": 0.2}, steady=False)
    check("no baseline is learned before then", out["phase"] == "settling" and s.t0 is None,
          out["phase"])


async def commands():
    print("live tuning")
    m = muse.Muse()
    m.settle.frozen, m.settle.level = True, 0.3
    saved = (muse.args.start, muse.args.up, muse.args.down)
    loop = asyncio.get_running_loop()
    stream = io.StringIO("set up 0.25\nset start 0.5\nset bogus 1\nset down x\nnonsense\n"
                         "set weight alpha 1.5\nset weight nonsense 2\n")
    saved_weights = dict(muse.WEIGHTS)
    await loop.run_in_executor(None, muse._read_commands, loop, m, stream)
    await asyncio.sleep(0.05)
    try:
        check("set changes the curve under a running session",
              muse.args.up == 0.25 and muse.args.down == saved[2], (muse.args.up, muse.args.down))
        check("a new start level moves the lamps there now",
              m.settle.level == 0.5 and muse.args.start == 0.5, m.settle.level)
        check("a weight changes under a running session, unknown signals ignored",
              muse.WEIGHTS["alpha"] == 1.5 and "nonsense" not in muse.WEIGHTS, muse.WEIGHTS)
    finally:
        muse.args.start, muse.args.up, muse.args.down = saved
        muse.WEIGHTS.clear()
        muse.WEIGHTS.update(saved_weights)
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
