hdsjulian/sparkles/(commit log)

2025-08-04 Added Hardware
    [Blinky-B_Cu.gbr, Blinky-B_Mask.gbr, Blinky-B_Paste.gbr, Blinky-B_Silkscreen.gbr, Blinky-Edge_Cuts.gbr, Blinky-F_Cu.gbr, Blinky-F_Mask.gbr, Blinky-F_Paste.gbr]
2025-08-04 added casing
    [2h_battery_casing.3mf, TopV2.stl, base.stl, base_v2.stl, base_v3.stl, base_v3_test.stl, base_v4.stl, base_v4_final.stl]
2025-11-23 hamburn comit
    [base_v5.stl, insert.stl, insertflip.stl]
2026-05-26 fix: add svelte-kit sync to build, pin deps, fix setup script
    [setup_pi.py]
2026-05-26 fix: run on port 80 with CAP_NET_BIND_SERVICE
    [setup_pi.py]
2026-05-27 fixed a bunch of things in master and client. post hedo
    [deploy.py, main.cpp, main.py, serial_bridge.py, setup_pi.py]
2026-05-27 fix: rename myDefines.h -> MyDefines.h for case-sensitive Linux filesystem
2026-05-28 fix: use argon2 instead of bcrypt (passlib bcrypt broken on Python 3.13)
    [auth.py]
2026-05-28 fix: redirect unauthenticated page requests to / so SvelteKit handles login routing client-side
    [main.py]
2026-05-28 fix: replace StaticFiles mount with SPA catch-all that falls back to index.html
    [main.py]
2026-05-28 fix: call tzset() after settimeofday so getLocalTime works
    [main.cpp]
2026-05-28 fix: skip-worktree auth_config.yaml before pull in deploy.py
    [deploy.py]
2026-05-28 fix: stale detection triggers when master never sends a frame after connect
    [main.py, serial_bridge.py]
2026-05-28 fix: reduce request timeout to 4s, push serial stale status via SSE every 10s
    [main.py]
2026-05-28 fix: normalize boardId from id field in SSE and address list responses
2026-05-28 fix: reduce blink startTime offset from 1s to 100ms for faster response
    [main.cpp]
2026-05-28 feat: DTR reset master after firmware upload to ensure clean reboot
    [compile.py]
2026-05-28 fix: prevent event loop blocking and serial port conflicts during flash
    - serial_bridge: move serial writes to reader thread via send queue so
    bridge.send() never blocks the asyncio event loop
    - serial_bridge: add pause_reconnect flag so reader thread stays off the
    port for the full duration of a firmware flash, not just at the start
    - compile.py: skip recompile if source files unchanged (hash check),
    resume port in finally block after master upload
    - layout.svelte: use BroadcastChannel to close SSE connections in other
    tabs when a new tab opens, preventing connection pool saturation
    - Client-Device: set Serial.setTxTimeoutMs(0) to prevent USB CDC writes
    from blocking when host buf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
    [compile.py, main.cpp, main.py, serial_bridge.py]
2026-05-28 fix: remove stale line reference in send() after queue refactor
    [serial_bridge.py]
2026-05-28 feat: add per-device Sync button to battery status page
2026-05-28 feat: add maintenance mode and per-device shimmer to battery page
2026-05-28 feat: add All Off button to animations page
2026-05-28 feat: add Breath animation — sine-wave breathing with distance-based phase spread
2026-05-28 feat: add Bioluminescence animation — independent random blue-green pulses per lamp
2026-05-28 fix: shimmer button sends candle animation instead of background shimmer
    [main.cpp]
2026-05-28 fix: use ledInstance.createCandle for shimmer command
    [main.cpp]
2026-05-29 feat: chirp-device firmware, test mode, continuous candle animation
    - Chirp-Device: standalone ESP32-S3 firmware plays an 8-step pseudo-random
    chirp via PCM5102A I2S DAC, announces to master, runs full client-style
    timer sync (MSG_TIMER → MSG_GOT_TIMER), and broadcasts MSG_CLAP with
    synced timestamps around audio playback
    - Master runClapSync: after hardware-delay measurement, sends TIMER_ARRAY_COUNT+5
    MSG_TIMER packets to chirp device; MSG_GOT_TIMER guard skips addressList
    writes while still removing peer and clearing settingTimer
    - Test mode: Settings toggle + spacing param; MIDI maps C4→client 0 chromatically;
    each lamp distance set to spacing × client_id; message_command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
    [main.cpp, main.py]
2026-05-29 fix: broadcast CMD_SET_MAX_DISTANCE after calibration and test mode so breath spread works correctly
2026-05-29 fix: return 503 'Master not connected' when serial bridge is down instead of timing out
    [main.py, serial_bridge.py]
2026-05-29 fix: skip svelte rebuild in deploy.py if sparkles-ui files unchanged after git pull
    [deploy.py]
2026-05-29 debug: revert master setup debug prints, keep CORE_DEBUG_LEVEL=5
    [main.cpp]
2026-05-29 test: remove ARDUINO_USB_CDC_ON_BOOT from Master_WebserverTest_Pi
2026-05-29 fix: remove ARDUINO_USB_CDC_ON_BOOT from both master envs
2026-05-29 feat: hue/saturation color picker with live preview on animations page
    Adds HueSatPicker component with gradient sliders and color swatch.
    Wired into Strobe, Candle, Bioluminescence, and Breath sections.
    Also adds ARDUINO_USB_CDC_ON_BOOT=1 to Master_WebserverTest_Pi env.
2026-06-08 feat: route aubioAlgo output via serial to master instead of ESP-NOW
    aubioAlgo.py now sends JSON commands over serial (/dev/ttyACM0) to the
    master ESP32 instead of broadcasting raw ESP-NOW frames directly. Master
    handles new aubio_shimmer and aubio_midi serial commands, sets
    lastMidiTime to suppress the animation loop while audio is active, and
    broadcasts to all clients via ESP-NOW as before.
2026-06-08 feat: absorb pitchdetector into main repo, replace ESP-NOW with serial
    Moves pitchdetector/ from a standalone git repo into SparklesCurrent.
    aubioAlgo.py now sends JSON over serial to the master ESP32 instead of
    broadcasting raw ESP-NOW frames. Requirements trimmed to only what's
    needed: numpy, aubio, music21, pyaudio, pyserial.
    [aubioAlgo.py, main.cpp, rms_calibrate.py]
2026-06-08 feat: add serial_mux — single serial owner via Unix socket
    serial_mux.py owns /dev/ttyACM0 and exposes /tmp/sparkles.sock so
    multiple processes (serial_bridge, aubioAlgo, keyboard) can share the
    port without contention. serial_bridge and aubioAlgo updated to connect
    via socket instead of opening serial directly.
2026-06-08 feat: Pi 5 setup scripts, systemd services, kiosk config
    - setup.sh: master setup script running all steps in order
    - setup/01_system_deps.sh: apt packages (python, audio, kiosk, midi)
    - setup/02_python_deps.sh: virtualenv + pip requirements
    - setup/03_folders.sh: creates songs/ and logs/ directories
    - setup/04_services.sh: installs and enables all systemd services
    - setup/05_kiosk.sh: Chromium kiosk autostart via Openbox
    - setup/services/: serial_mux, sparkles, aubio, keyboard_midi services
    - Fix all /home/raspi → /home/julian across codebase
    - Fix pitchdetector start script to use new repo path
    [deploy.py, keyboard_midi.py, main.cpp, main.py, serial_bridge.py, upload_ota.py]
2026-06-08 fix: revert password to raspi in deploy scripts
    [deploy.py, upload_ota.py]
2026-06-08 feat: add nginx reverse proxy on port 80
    Configures nginx to proxy localhost:80 → localhost:8080 with SSE
    support. Kiosk updated to wait on port 80. Setup script installs
    and enables nginx alongside other services.
2026-06-09 fix: reduce serial_mux log noise when master ESP32 not connected
    Log once when waiting, once when disconnected, once when reconnected.
    No repeat spam every 3 seconds.
2026-06-09 feat: serial_mux logs all TX/RX to serial.log
    serial_mux now owns the serial log file and writes every TX (client→serial)
    and RX (serial→clients) line with timestamp. serial_bridge no longer
    duplicates to the same file.
    [serial_bridge.py]
2026-06-09 perf: reduce TIMER_FREQUENCY from 100ms to 20ms
    Cuts full resync time for 100 clients from ~7.5 min to ~1.5 min.
    ESP-NOW round trip is 2-5ms so 20ms gives comfortable margin.
2026-06-09 feat: add fast resync — parallel pool of 5 concurrent timer syncs
    startFastResyncTask() syncs clients in batches of 5 in parallel,
    cutting resync time from ~1.5min to ~18s for 100 clients. Slow
    sync (startAllTimerSyncTask) retained for post-calibration use.
    Exposed as serial cmd 'sync_fast' and GET /commandSyncFast.
2026-06-09 fix: serial_mux broadcast timeout, fastResyncHandle accessor, Master_Device commented out
    [main.cpp]
2026-06-09 fix: catch socket timeout in client recv loop so send timeout doesn't disconnect clients
2026-06-09 fix: don't restore interrupted shimmer state when new update has value=0
2026-06-09 fix: reduce presync delay from 20s to 5s before strobe/blink
    [main.py]
2026-06-09 fix: pause animation loop during timer sync to prevent lastDelay inflation
    Animation loop broadcasts were triggering onDataSent which set lastDelay
    from inflated timings, causing clients that arrived after the loop started
    to never complete sync. Now stops the loop before each new sync and
    restarts it on MSG_GOT_TIMER or sync timeout.
2026-06-09 fix: relax timer sync acceptance thresholds on client
    The 2500us timeDiff and 6000us lastDelay thresholds were too tight,
    causing clients with normal ESP-NOW jitter to reject most timer packets
    and never accumulate the 10 samples needed to send MSG_GOT_TIMER.
    Raised both to 100ms — the sync correctness is determined by the
    offset calculation, not by packet filtering strictness.
2026-06-09 fix: stop animation loop during timer sync to prevent radio interference
    Animation loop was broadcasting ESP-NOW packets concurrently with timer
    sync unicasts, inflating lastDelay ACK times beyond the 6000μs client
    acceptance threshold. Clients were rejecting all timer samples, so
    MSG_GOT_TIMER was never sent and green blink never occurred.
    Fix: delete animationLoopHandle before starting any sync path (MSG_ADDRESS
    handler, startFastResyncTask), restart it after sync completes. Also fix
    dead code bug where startAnimationLoopTask() was placed after vTaskDelete(NULL)
    in the runTimerSync timeout path.
    Client thresholds kept strict (2500μs/6000μs) — with radio clear during sync,
    jitter sta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
2026-06-09 fix: presync only before long animations, not before blink/strobe
    Blink and strobe have a built-in startTime offset (100ms) that relies on
    clients already having stable clock offsets. Running a fast resync
    immediately before them was causing desync: clients got their offsets
    reset mid-stream and fired at slightly different times.
    Move presync to commandAnimate (long-running animations) where it belongs.
    Blink all, individual blink, and strobe fire immediately against the
    already-synced client clocks.
    [main.py]
2026-06-10 feat: timer test — query clients for clock accuracy, show result in UI
    New MSG_TIMER_QUERY/MSG_TIMER_RESPONSE message pair. Master sends query
    to each active client; client replies with esp_timer_get_time() + offset
    (its estimate of current master time). Master computes delta and emits
    timer_test_result SSE event. Frontend /timertest page shows table with
    green/yellow/red rows (<5ms / <20ms / >=20ms).
    Fix: timer_test loop now iterates all NUM_DEVICES slots and skips inactive
    entries, rather than stopping at getNumDevices() which missed non-contiguous
    active slots.
    [main.cpp]
2026-06-10 fix: correct signed/unsigned overflow in client timer offset calculation
    When offsetMultiplier = -1 (client booted before master), multiplying by
    unsigned long long offsetSum promoted -1 to ULLONG_MAX, producing garbage
    offsets. Cast both operands to long long before multiplying.
2026-06-10 fix: compensate timer test delta for round-trip latency
    Subtract half the stored ACK delay for each client before computing
    the delta, so the result reflects actual offset accuracy rather than
    transport latency.
2026-06-10 fix: use actual query round-trip time for timer test compensation
    Store send timestamp per client when query is dispatched; on response,
    compute half the actual round-trip instead of using the cached sync delay.
    [main.cpp]
2026-06-10 perf: set CORE_DEBUG_LEVEL=0 on master and client production builds
    Silent by default — use /commandSetLogLevel from the UI to enable
    logging on demand. Reduces UART pressure and task latency.
2026-06-12 timer sync rework: hardware rx timestamps, per-packet tx delay correction, burst median. sound device discovery via broadcast announce, clap sends contact timestamp. presync before distance calibrati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
    [auth.py, keyboard_midi.py, main.cpp, main.py]
2026-06-14 remove onboard webserver, commit to raspi serial solution
    delete lib/WebServer and the legacy webserver-based master main. rename the
    serial/pi master from Master_WebserverTest-Device to Master-Device and reclaim
    the Master_Device / Master_Pi env names. point compile.py at the new env and paths.
2026-06-14 remove dead data/ web assets and stale firmware_client.bin
    the onboard web UI files were only served by the deleted webserver, the svelte
    app on the pi replaces them. firmware_client.bin is old and unused, client OTA
    is served by the pi at /firmware.bin now. data/ only stages clientAddress for
    uploadfs, scripts recreate it on demand.
    [generate_clientAddress.py]
2026-06-15 trim debug logging
    cut ~115 noise log statements: per-packet/per-loop spam, setter echoes, task-start
    breadcrumbs, commented-out and duplicate logs. kept errors, one-shot state
    transitions, OTA, and the json protocol output to the pi. removed two now-empty
    debug helpers (printAllPeers, printAddress).
    [main.cpp]
2026-06-18 master debug instrumentation: loop watchdog, heap reporting, esp_now_send check, coredump-to-uart on Master_Pi
    enableLoopWDT turns a loop() freeze into a panic with backtrace. heap event every
    5s to spot exhaustion. log esp_now_send failures under shimmer load. Master_Pi
    build gets coredump-to-uart for full crash dumps.
    [main.cpp]
2026-06-18 split music output to a dedicated device
    new Music-Device firmware broadcasts aubio/keyboard MIDI + shimmer over ESP-NOW,
    nothing else, so the 30Hz media stream stops competing with the master's
    sync/management work (the likely cause of the master hangs). serial_mux now owns
    two ports and routes by command: aubio/midi to music, everything else to master.
    devices self-identify via an identify handshake, so ports/boards can be swapped.
    master loses the music handlers, gains a 1Hz music_active ping to keep its idle
    loop suppressed while music plays.
    [main.cpp]
2026-06-20 karaoke playback also drives the lights
    forward each played note from file playback to the mux, same keyboard_midi path
    live key presses use, so the music device broadcasts them and the clients animate
    in time with the song.
2026-06-20 dim kiosk panel at boot for battery + hide touchscreen scrollbar
    set backlight to a low value in the kiosk autostart (udev rule grants the kiosk
    user write access to /sys/class/backlight), and hide the scrollbar on the karaoke
    page since it is touch-scrolled.
2026-06-20 kiosk idle-blank: use xrandr (DSI output off) since the panel ignores bl_power/brightness
    wake by a blocking read of the touch event device (works while the output is off),
    dropping xprintidle. julian joins the input group to read the device.
2026-06-26 setup: write the 7-inch DSI (dsi0) config.txt
    new 07_display.sh writes the known-good display config (auto-detect off, explicit
    vc4-kms-dsi-7inch,dsi0 overlay) and backs up the original. wired into setup.sh.
2026-06-26 kiosk: add missing .xinitrc (exec openbox-session) and console autologin
    without these the login -> startx -> openbox -> chromium chain never starts:
    startx had no xinitrc so it didn't launch openbox, and no autologin meant
    .bash_profile never ran startx. these were manual on the old card.
2026-06-27 keyboard_midi: pick the real MIDI device, not the Midi Through loopback
    auto-selection took names[0], which is always the ALSA 'Midi Through' loopback,
    so playback went nowhere (no sound) and the loopback fed notes back as 'user
    played -> stop'. now skip Midi Through and require an in+out capable port (the
    NC2 keyboard). --midi-port is a substring match for pinning.
    [keyboard_midi.py]
2026-06-27 add play_midi.py: live MIDI player with channel filtering (no file conversion)
    plays a file straight to the keyboard, optionally only certain channels, for
    piano karaoke. --list shows ports, sends all-notes-off on exit.
2026-06-27 karaoke: reflect when playback stops (incl. key press on keyboard)
    keyboard_midi already stops playback on a key press; expose playback state at
    /keyboard/status, set it on play/stop and on keyboard_midi's stopped/finished/
    error callbacks, and have the karaoke page poll it so the now-playing bar clears.
    also make /internal/keyboard_event reachable (was 401) so the callback lands.
    [main.py]
2026-07-14 single device music: master handles keyboard/aubio directly, drop serial_mux
2026-07-14 fix: getLocalTime with 0 timeout, default blocks 5s when clock unset and trips loop() watchdog
    [main.cpp]
2026-07-14 fix serial tx truncation under burst, store client offset in address list, fix master-time conversion for negative offsets
    [main.cpp]
2026-07-14 timertest ui: clear results per run, flag boards that don't reply, show last run time
2026-07-14 timer test: burst 8 queries per board, gate stale pairings, report rtt; ui keeps min-rtt sample and shows median+count
2026-07-14 flash from pi: survive port death in reader thread, use esptool usb-jtag reset sequence after upload
    [compile.py, serial_bridge.py]
2026-07-14 sleep test: ui page + api endpoint, fix false unexpected-wakeup spam (mark inactive before phase, report once per board)
    [main.cpp, main.py]
2026-07-15 fail-closed sleep: clients re-sleep through silence instead of burning battery, passive listen window, master broadcasts zero-duration wake sentinel each morning, mac-staggered announce
    [main.cpp]
2026-07-15 pi re-pushes clock and sleep schedule on every serial connect, schedule persisted in schedule.json — master reboot rejoins the sleep phase
    [main.py, serial_bridge.py]
2026-07-15 master persists sleep schedule and clock checkpoint in nvs — survives reboots without the pi
    [main.cpp]
2026-07-15 fix post-flash reset: use esptool HardReset pulse, previous sequence was the enter-bootloader dance and parked the chip in download mode
    [compile.py]
2026-07-15 shimmer: keep pitch dynamics — aubio sends pitch scale, bridge sweeps hue/saturation from the configured base color
2026-07-15 sleep test: 5s settle window before judging wakeups — resync gotTimers and the bedtime blink were flagged as false early wakes
2026-07-15 sleep test: cancel button — ends the phase early and runs the wake-up sequence so boards don't nap indefinitely
2026-07-15 sleep test: end-of-run report card — parameters, resync, cancel point, early wakers, wake-up stats, verdict
2026-07-15 device management: remove single device / remove all devices, compacting the address list so re-setup starts from a clean slate
2026-07-15 remove_device: fast-resync remaining boards so each learns its new (shifted) position, not just the master's stored list
2026-07-15 fix Master_Pi build: drop the platform=espressif32 override, was pulling a different/older arduino-esp32 core than every other env
2026-07-16 fix data loss on every serial reconnect: dispatch valid JSON seen during the boot-noise drain instead of discarding it unconditionally
    A pi-side-only restart (systemctl restart sparkles / update.sh) never reboots
    the master — it keeps running and sending real JSON the whole time, but the
    reconnect handshake blindly ate 2s of it as if it were ROM bootloader garbage.
    This is why a sleep test's own start/resync/broadcast_start events vanished
    when the service happened to restart right as the test began: the master
    never re-sends them, so they were gone for good. Only lines that fail to
    parse as JSON are now treated as boot noise and discarded.
    [serial_bridge.py]
2026-07-16 sleep until: one-shot 'sleep now until HH:MM' for the pack-up/power-cycle workflow
    Independent of the recurring daily sleep/wakeup schedule — computes seconds
    until the target time, resyncs, broadcasts sleep in the normal 5-minute
    chunks until then, then wakes the fleet. Persisted to NVS so it survives a
    master power cycle mid-cycle (recomputed against the restored clock on
    boot). Guards against colliding with the recurring schedule's own sleep
    task. New Settings page card shows live status and a cancel button.
    [main.cpp, main.py]
2026-07-16 fix sync_all silently breaking: runTimerSync() no longer deletes an unrelated task when called synchronously
    runAllTimerSyncWrapper calls runTimerSync() as a plain subroutine (not its own
    task) once per device. Its cleanup code compared xTaskGetCurrentTaskHandle()
    to timerSyncHandle (a completely different, single-board-sync task) and, on
    mismatch, deleted whatever timerSyncHandle happened to hold — including a
    stale handle left over from an earlier single-board sync, or a legitimately
    still-running unrelated task. Once timerSyncHandle got left non-null, every
    subsequent sync_all silently misbehaved instead of syncing. Removed the
    erroneous branch: a synchronous call has no business touchi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
    [main.cpp]
2026-07-16 dashboard: wire up Sync Fast button (parallel batches) alongside Sync All, which is O(boards) sequential at ~2s/board — never had a UI, only a backend endpoint
2026-07-16 fix out-of-bounds addressList[-1] access on late/stale MSG_GOT_TIMER
    currentTimerIndex is reset to -1 the moment a sync completes, but a client's
    got_timer response can legitimately arrive after that reset (retransmission,
    radio delay, or a response racing against the next board's sync starting).
    onDataRecv's syncIndex<0 filter only applies while a sync is actively marked
    running — once the task handle clears, a late response sails through
    straight into addressList[timerIndex] with timerIndex still -1.
    addressList sits right after a raw pointer member (incomingData) in the
    class layout, so this wasn't just a cosmetic '#-1' row in the dashboard —
    it was corrupting adjacent memory on ever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
2026-07-16 dashboard shows which animation is running (not just on/off)
    master tracks the type of the last broadcast animation and reports it in
    animate_status/get_animate_status; dashboard displays it.
    fix client animation dispatch freeze after a bad/stale timerOffset:
    calculateMicrosUntilStart/setMicrosUntilStart clamped the wait to >=0 but
    never capped the upper end. calculateMicrosUntilStart is called directly in
    ledTask()'s own loop via a blocking vTaskDelayUntil — a stale offset (e.g.
    right after a resync) could make that wait absurdly long, freezing ALL
    animation dispatch on the client for the duration, so it would silently
    ignore every subsequent broadcast from the master (looks exactly like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
    [main.cpp]
2026-07-16 fix client waking early mid-sleep: the sentinel is the only wake signal now
    handleSleepWakeup() treated ANY master broadcast during its listen window as
    'morning', on the theory that if the master isn't explicitly saying 'keep
    sleeping', it must be daytime. But the master broadcasts things unrelated to
    the sleep schedule even mid-phase — e.g. sendSystemStatus() fires as a
    broadcast to ALL clients whenever ANY single board's sync completes (not
    just the syncing one). A client waking for its listen window right as some
    unrelated board finished a resync would catch that broadcast, conclude
    'morning', and reannounce/resync — exactly the false early wake + spurious
    resync seen in testing (bot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
2026-07-16 restore the 'any master traffic' wake fallback, but de-race it against the authoritative sleep-continue signal
    Fully removing the fallback (previous commit) traded the false-early-wake bug
    for two real regressions: a client that misses the entire wake-sentinel
    window (nap longer than the sentinel stays up, or the master reboots mid
    sentinel and reverts to normal operation instead of finishing it) would then
    have no way to ever learn it's morning and would nap forever.
    The actual bug was that 'other traffic' triggered morning on the very first
    packet, racing against the 1 Hz sleep-continue ping — an incidental
    broadcast (e.g. sendSystemStatus(), sent to ALL clients whenever ANY board's
    syn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
2026-07-16 sleep_until: don't wrap to tomorrow when resuming a target that's already passed
    Resuming after a power cycle recomputes the target against the restored
    clock, wrapping to tomorrow if it's already passed today — correct for a
    freshly-issued command, but wrong on resume: if you packed up saying 'sleep
    until 10' and the gap before power-on ran past 10, the one-shot's intent was
    that specific near-term time, not 'rearm for a fresh 24h'. Now the resume
    path drops an already-expired target instead of re-arming — normal boot
    proceeds, the idle animation loop starts, and any client still asleep from
    before wakes on its own next listen window via the existing fallback.
    [main.cpp]
2026-07-16 add 1s settle delay after resync, before the first sleep broadcast
    The resync task's own completion is already bounded by the paced burst
    duration, so clients should have finished processing by the time it
    reports done — but this costs nothing in the common case and removes any
    margin-of-error race between 'master thinks resync finished' and 'client
    has fully absorbed it' before sleep starts. Applied to sleepBroadcastTask,
    sleepUntilTask, and the sleep test's resync step.
    [main.cpp]
2026-07-16 sleep test: resume the animation loop right after the wake window instead of leaving the master silent
    Production sleep and sleep_until both call startBroadcastSettleTask() in
    their wake sequence, which chains into a full resync and animation-loop
    resume within ~15s -- giving a board that missed the wake sentinel fresh
    broadcast traffic to catch on its very next listen window. The sleep test
    never did this: after its own bounded sentinel window ends it just
    finishes, so a straggler that missed every sentinel packet had nothing
    else to catch until the (now 4 minute) idle-animation timeout fired,
    leaving it stuck asleep in the meantime. Explicitly resume the animation
    loop at the end of the te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
    [main.cpp]
2026-07-16 fix device MAC address never rendering on the dashboard
    DeviceCard already had a MAC field and formatMac(), but the master sends
    address as a pre-formatted string ('aa:bb:cc:dd:ee:ff'), and formatMac only
    handled a raw byte array — every real device silently rendered '—' instead
    of its MAC.
2026-07-16 fix post-nap radio deafness: turnWifiOn no longer associates with stored wifi, mirrors boot path
    turnWifiOn() — which runs after EVERY nap in the fail-closed sleep loop —
    called WiFi.begin(), connecting to whatever SSID is stored in NVS. Any board
    that ever ran an OTA update has credentials persisted (Arduino default), so
    after its first nap it scanned/associated with the venue AP on every wake:
    - channel-hopping during the scan makes the board miss the master's 1 Hz
    sleep pings while still catching stray packets -> the 'other traffic'
    wake fallback misfires -> the consistent first-window early wakes
    - a successful association parks the radio on the AP's channel -> the board
    is pe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
2026-07-16 broadcast the wake sentinel for two full sleep cycles after scheduled wakeup (and sleep_until), so a board that misses its whole first listen window gets a second chance
2026-07-16 extend post-resync settle to 3s before the first sleep broadcast — clients still blink/announce after a resync and the first sleep command landed mid-routine
2026-07-16 client: log reset reason at boot — green boot blinks mid-sleep-phase mean the clients are crash-rebooting, this names the crash class
    [main.cpp]
2026-07-16 client: crash breadcrumb in RTC memory — the serial capture proves boards reboot instead of waking from light sleep
    The captured log shows the smoking gun: device asleep at 34s, and the next
    output is a full boot banner where the 30s-nap wake should be. The crash's
    own error output is unrecoverable (USB is still re-enumerating when the wake
    path runs), so record progress markers in RTC_NOINIT memory instead:
    SLEEPING is set just before esp_light_sleep_start, WAKING right after it
    returns, cleared once the wake path completes. setup() reads the marker
    after the reboot and logs exactly which segment died, alongside a named
    esp_reset_reason (PANIC/TASK_WDT/BROWNOUT/...) — together these bis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
    [main.cpp]
2026-07-16 fix INT_WDT reset during light sleep: drop the 8MD256 RTC slow-clock override on clients
    The crash breadcrumb named it: reset reason INT_WDT with the marker still at
    SLEEPING — the chip hung inside esp_light_sleep_start() itself, with
    interrupts disabled, and the interrupt watchdog killed it. The client setup
    overrode the RTC slow clock (which times light sleep) to RC_FAST/256 for
    nap-duration accuracy; the sleep entry/exit code synchronizes on slow-clock
    edges with interrupts off, and 8MD256 is the known-hazardous source for that
    wait. Fits everything observed: intermittent (a race), all boards equally,
    crash lands nap-length+boot after sleep entry (the 22-27s 'woke early'
    flags), and the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
    [main.cpp]
2026-07-17 client: probe the 32k xtal like the clap device does — use it when alive, default RC_SLOW when dead, never 8MD256
    The boards DO have the 32k crystal populated, but it's dead on about half of
    them, and trusting it unconditionally killed those boards — which is how the
    fleet ended up on the 8MD256 compromise that turned out to hang light sleep
    (INT_WDT). The clap device already solved this: bounded calibration probe at
    boot, switch the slow clock only after the crystal proves it oscillates,
    otherwise stay on the safe default. Working-xtal boards get accurate naps,
    dead-xtal boards get RC_SLOW's few-percent drift (absorbed by the rebroadcast
    /listen-window/sentinel design), and nobody hangs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
    [main.cpp]
2026-07-17 client: plain default RC_SLOW for light sleep, drop the xtal probe too
    Chunked sleep made timing accuracy irrelevant (±3% of a 5-minute nap is
    seconds, refreshed every rebroadcast), and on a board batch where half the
    32k crystals are dead, a marginal 'working' one that stalls mid-nap would
    strand its board asleep forever — the worst failure in the system, risked
    for a benefit that no longer exists. Simplest clock config wins.
    [main.cpp]
2026-07-21 sleep_until: report the wake-sequence as its own UI state, not 'still sleeping' for 11 more minutes
    sleepUntilActive was true for the entire task lifetime, including the
    tail-end wake-sentinel broadcast (up to 11 min after cancel or target time).
    The Settings page only polls get_system_info every 5s and has no other
    signal, so pressing Cancel would make the boards start waking within one
    nap cycle while the dashboard kept showing 'sleeping until HH:MM' for up to
    11 more minutes — actively misleading about whether it worked.
    sleepUntilActive now means specifically 'still broadcasting sleep'; a new
    sleepUntilWaking flag covers the wake-sequence tail, and the UI shows a
    distinct 'waking up'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
2026-07-21 add 'Reboot All Clients' — bounce every client without touching the master/list
    resetSystem was the only reset, and it's heavy: wipes the master's board
    list, reboots the master too, and only reaches clients that happen to
    announce during a 5s window (a stuck-but-synced client, which is exactly the
    'things hung up' case, never announces so never gets it). New reset_clients
    broadcasts CMD_RESET_SYSTEM directly to all clients 10x over 3s, master and
    address list untouched. Anti-flood is inherent: clients stagger restart by
    100ms*position, re-announce staggered by mac%30, and the master serializes
    syncs on a single task.
    [main.cpp, main.py]
2026-07-21 master: broadcast reannounce on every boot (unless entering sleep) so a power-cycle recovers stranded clients
    Intentional power-cycles are routine. On boot the master reset esp_timer to
    zero while clients kept running on offsets from the old incarnation. The
    boot-time unicast settle only resyncs clients it can reach in that moment;
    any briefly-unreachable client is stranded — it still thinks it is synced so
    it never re-announces, and 'sync' can only re-time clients the master still
    knows and can reach (which is why pressing sync did nothing, no green blink).
    A broadcast reannounce on boot invites the whole awake fleet to re-register
    and resync against the fresh clock. Guarded so it doesn't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
    [main.cpp]
2026-07-21 client: flush stale animations on a timer-sync clock-epoch shift
    Confirmed via serial: after a master power-cycle the sync completes and the
    offset it computes (-2135243100 us) is CORRECT — it's master_esp(~1s, fresh
    boot) minus client_esp(~35min, never rebooted). The breakage is downstream:
    an animation still queued/running on the client carries a startTime from the
    OLD epoch (when master and client clocks were aligned), and evaluating that
    old-epoch startTime against the new -35min offset yields the 'absurd
    microsUntilStart' 35-min-future value. The clamp masks it to start-now, but
    the state stays noisy and imprecise.
    Fix: when a sync moves the offset by >2s (an epoch reset, i.e. a rebo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
2026-07-21 wifi_connect.sh: run the switch detached (systemd-run) with AP fallback
    Original bug: it downed the AP hotspot inline, but when you're SSH'd in over
    that same hotspot the shell dies the instant the radio leaves AP mode, killing
    the script before it connects -> stuck on neither network. Now the actual
    switch runs detached via systemd-run so losing SSH can't interrupt it, and a
    failed join restores the Sparkles hotspot so you can never get locked out.
2026-07-21 sleep_until: verified wake — broadcast until every known client actually returns
    Reworks the wake phase for the 'fleet asleep, master/Pi rebooted, wake at T,
    guarantee all come back' need. Instead of blindly sentinel-broadcasting for a
    fixed 11 min and hoping, the master now: resets return-tracking, then keeps
    broadcasting the wake sentinel and counting clients that actually re-announce
    + resync, until all known clients are back (or a 20 min hard cap for
    stragglers), covering at least 2 nap cycles first. Then it resumes the
    animation loop so the woken fleet has traffic to stay awake on, and reports
    any board that never returned. Progress (returned/expected) is surfaced in
    get_system_info s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
    [main.cpp]
2026-07-21 offline deploy: push_to_pi.sh (Mac) + update.sh bundle fallback
    push_to_pi.sh (run on the Mac): bundles the current branch, scp's it to the
    Pi over the local link, and runs update.sh remotely — no internet either side.
    update.sh now probes the git remote (timeout'd, prompt-disabled); if it can't
    reach it, it pulls from /tmp/sparkles-update.bundle instead of GitHub and skips
    npm install (node_modules is already present), so the offline path builds +
    restarts cleanly. Online behavior is unchanged.
2026-07-21 push_to_pi.sh: pull the bundle into the Pi repo before running update.sh (bootstrap)
    The Pi's on-disk update.sh may predate the offline logic, so running it first
    would still try GitHub. Pull the bundle from the Mac side first — that updates
    update.sh itself — then run it (its own offline pull is then a no-op).
2026-07-21 settings: 'Wake Up At' button — schedule a verified wake for an already-asleep fleet
    Same hold-until-T + verified-wake as Sleep Until, but with skip_resync: for
    the post-reboot case where the fleet is already napping. Skips the opening
    resync (futile against sleeping radios, and it falsely marks sleepers active),
    just holds them down until the time then runs the same verified wake. The
    boot-resume path also skips the resync now (fleet was asleep the whole outage).
    skip_resync threads through sleep_until cmd -> task (int[4]) -> /sleepUntil
    -> api.js.
    [main.cpp, main.py]
2026-07-22 client: log every received frame (RX type/sender/len) except high-rate music anims
    Diagnostic for intermittent client unreachability: if a client stops
    reacting, this distinguishes 'nothing arriving' (no RX lines -> radio/range/
    channel) from 'arriving but ignored' (RX lines present -> logic). Excludes
    MIDI/shimmer animations so it doesn't flood during music.
2026-07-22 client turnWifiOn: WiFi.setSleep(false) after naps, matching boot
    Post-nap the radio reverted to default modem sleep (powers down between
    beacons), making it miss ESP-NOW packets -> intermittent unreachability once
    a board has slept. setup() already does this at boot; turnWifiOn didn't.
    Not the channel/disconnect change (reverted) — just modem power mgmt.
2026-07-23 sleep_now: definitive 'everyone asleep NOW', no resync, plus shell trigger
    The opening resync before sleep can stall with many clients (or never finish),
    so sleep never starts. sleep_now skips resync entirely and holds the fleet
    asleep indefinitely (1Hz sleep broadcast, animation loop suppressed) until Wake
    Up Now — reusing sleepUntilTask via an 'indefinite' flag, so cancel + verified
    wake still apply, and it survives a master reboot (persisted suIndef).
    Reachable three ways: Settings 'Sleep All Now' button, GET /sleepNow, and
    sleep_all.sh which writes {"cmd":"sleep_now"} straight into the serial
    bridge's music socket — no web/auth/FastAPI-routing needed, the worst-case
    lever. sleep_all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
    [main.cpp, main.py]
2026-07-23 dashboard: simple Sleep Now / Wake Now buttons
    Sleep Now = sleep_now (no sync, hold until woken). Wake Now = new wake_now
    command that cancels ALL sleep activity: a manual hold (runs its verified
    wake), the recurring scheduled sleep phase (a sleepScheduleOverride stops it
    and keeps loop() from restarting it until the next natural wake, so the
    schedule can't instantly re-sleep them), and — if nothing was broadcasting
    (fleet asleep via fail-closed) — spawns the verified wake directly. Factored
    the verified-wake body into runVerifiedWake() shared by the hold-cancel and
    wake_now. sleep_all.sh wake now sends wake_now too.
    [main.cpp, main.py]
2026-07-23 fully manual sleep mode: disable the recurring schedule until turned off
    set_manual_mode (persisted in NVS): when on, the recurring sleep/wake schedule
    is ignored entirely — the sleepBroadcastTask loop and loop() guard both bail on
    manualMode, so the fleet never auto-sleeps. Enabling it also wakes everyone now
    (shared triggerWakeAll, same verified wake as Wake Now), i.e. 'wake and never
    sleep again until I say so'. Turning it off hands control back to the schedule.
    Survives reboot. Settings gets a Sleep Mode card (Scheduled vs Manual toggle)
    and greys out the Sleep/Wakeup Time inputs while manual. system_info reports
    manualMode.
    [main.cpp, main.py]
2026-07-24 stop the idle animation loop before broadcasting sleep
    sleep_now/sleep_until/scheduled sleep never stopped the master's animation
    loop — and the resync path restarts it right before the sleep broadcast — so
    the master was broadcasting idle animations AND sleep at the same time. A
    napping client could catch an animation in its listen window instead of the
    sleep ping and stay awake (or read the animation as 'master alive, not saying
    sleep' -> fail-closed morning). Race -> only SOME lights failed to sleep,
    while one-shot blink still reached everyone. Now stopAllAnimations() runs
    right before every sleep-broadcast loop; runVerifiedWake restarts the loop on
    wake as before.
    [main.cpp]
2026-08-19 distance calibration: bursts of ten chirps, matched by index and averaged
    One calibration used to be one chirp, so a single bad correlation was the
    measurement. Now a burst is CHIRP_BURST_COUNT chirps on a fixed schedule that
    the emitter and every client count off the same calibration broadcast, so no
    extra messages are needed to stay lined up. Each chirp carries its index in
    message_clap, and the master keys replies by that index rather than by "most
    recent" — a client reply that lands after the next chirp still counts, which it
    often does since correlating takes ~250ms. At the end the master drops outliers
    by median absolute deviation and averages the rest into one distance per board.
    T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
    [main.cpp, main.py]
2026-08-19 map the fleet without knowing where anything is
    Trilateration needs the emitter's coordinates, and in a forest on a slope those
    are the one thing you cannot measure. So don't: with enough spots the whole
    constellation — boards and emitter positions alike — is fixed by the distances
    themselves, up to rotation, translation and a mirror. Time of flight gives the
    scale in real metres, so only the frame is arbitrary.
    mapsolve.py collects the chirp_distance events the master already emits and
    runs bipartite SMACOF over them on the pi, pure python, no new dependency. It
    also fits the constant offset every distance reads long by, which is the
    emitter's own I2S latency. On synthetic forest data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
    [main.py, mapsolve.py]
2026-08-19 hearth: candlelit windows that burn out and catch again
    A hundred lights in the windows of a house, meant to look like it is burning,
    and meant to last on battery. Those turn out to be the same mechanism rather
    than two: a window burns for a minute or three, flares, gutters out, sits dark
    a while, and catches again. The dark stretch is the effect and the saving at
    once, and across a hundred windows the house never visibly dims.
    Simulated over an hour of steady state on the defaults: 79 of 100 lit on
    average, never below 67, and 15% of the LED draw of holding them all on at
    full — about 6.6x the runtime. Two multipliers get there, the 70/255 brightness
    cap and the ~79% duty cycle, with the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
    [main.cpp, main.py]
2026-08-19 animation loop: tell endless apart from unknown, and stop pacing by uptime
    Two bugs in the same field. setAnimation stored now + duration where the loop
    reads a duration, so the wait between idle animations was roughly the master's
    own uptime: 10 minutes up meant 10 minutes between animations, an hour up meant
    an hour. The ambient blink never stopped, it stretched, which is why it looked
    fine on a fresh master and quietly went away in a running installation.
    resetMicrosUntilEnd had the same confusion and delayed the loop's first
    broadcast by the full uptime.
    The other half: 0 meant both "no idea" and "runs until replaced", and the loop
    treats no-idea as "check back in a second and broadcast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
    [main.cpp]
2026-08-19 sleep: no sync sweep on boot, one wake sequence, and a reset comes back awake
    Booting the master ran a settle that unicast a timer burst to every board in
    the list and then a full sequential sync on top — minutes of traffic aimed
    mostly at radios that were asleep. It now restores the list, marks everyone
    inactive, and stops there. Clients resync themselves when they announce, which
    they do on their next wake from sleep, and Sync Fast forces it sooner. A stale
    offset until then means animations fire immediately rather than in step;
    calculateMicrosUntilStart clamps both directions so nothing freezes.
    The scheduled sleep phase now wakes the fleet exactly the way sleep_now and
    sleep_until do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
    [main.cpp]
2026-08-19 keyboard midi: notice a keyboard that rebooted instead of waiting forever
    The reconnect logic was already there, it just never got a chance to run.
    "for msg in in_port" blocks inside rtmidi, and when the keyboard reboots its
    ALSA port is destroyed — but rtmidi does not raise for that. The port stays
    nominally open and simply never yields another message, so the except never
    fired and only a service restart brought MIDI back.
    Polled now, with a once-a-second check that the port is still listed. A
    re-enumerating keyboard comes back with a new ALSA client id, so the old name
    disappearing is the signal to reopen; _pick_port already substring-matches, so
    it picks the new name up on its own. Co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
    [keyboard_midi.py]
2026-08-19 sparkles-cli: drive the master over serial without the pi
    The pi's API is a thin wrapper — every endpoint writes one line of JSON to the
    master and reads its events back — so on the mac that whole layer can be
    skipped. Interactive with /help, or one-shot for scripting.
    The command table is parsed out of the firmware's own serial handler, both the
    names and the doc["key"] arguments each branch reads, so it cannot drift from
    what the master actually accepts and new commands show up for free. Unknown
    commands and arguments are warned about but still sent, and raw JSON goes
    through untouched, so nothing is locked away behind the parser.
    Housekeeping events are hidden by default: the master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
    [sparkles-cli.py, upload_client.py]
2026-08-19 sleep: a verified wake is no longer a dead end
    Switching to manual mode wakes the fleet, and the Sleep Until card replaced
    every button with a progress line while that ran — so there was no way to put
    anything to sleep for up to 20 minutes. It now keeps Sleep All Now alongside a
    Stop Waking button, and asking for sleep during a wake cancels the wake instead
    of being told "already sleeping" while the two broadcasts argue over the fleet.
    The count read "6 of 0" because expected is captured when the wake starts and
    the address list had just been reset — with nothing to count towards it now
    reports what has actually turned up. Same reason the wake sat for its full
    11 minute minimum: that mi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
    [main.cpp, main.py]
2026-08-19 update.sh: stop auth_config.yaml blocking every pull
    auth.py rewrites auth_config.yaml at startup — password_plain becomes
    password_hash and yaml.dump reformats the rest — so the pi's copy permanently
    differs from git. Any commit that touches that file then aborts the pull with
    "local changes would be overwritten", which is what the first commit to add
    access rules for new endpoints just did.
    The two halves of the file have different owners: access rules belong to git,
    credentials belong to the pi. So update.sh now sets the local copy aside, takes
    the incoming version, and puts the live users block back — new rules arrive,
    password hashes survive. The set-aside copy stays as auth_conf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
2026-08-19 verified wake: prompt boards that were already awake, and stop when stalled
    "0 of 6 boards back" for the full twenty minutes, on a fleet that was awake the
    whole time. The wake counts a board as returned once it re-announces and
    resyncs, but a board only announces after waking from sleep — the morning
    sentinel means nothing to one that never napped, handleSleepWakeup drops a zero
    duration on sight. So nothing ever prompted them and the count could not move.
    The old scheduled-wake path got away with it by calling broadcastReannounce,
    which is exactly what makes an awake board re-register; unifying the wake
    sequences dropped that, and wake_now and manual mode never had it. The wake now
    rean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
    [main.cpp]
2026-08-19 client: never sleep the receive task, and reannounce once per wake
    Clients hung during the post-wake sync, stuck announcing, and only a reboot got
    them back. CMD_REANNOUNCE staggers each board by MAC so a fleet does not
    stampede the master — but it did that with a vTaskDelay of up to 58 s inside
    handleReceive, the client's only message loop. For that whole time the board
    answered nothing: no timer bursts, no animations, nothing. The master could not
    sync it, so it never went active, so the wake never finished.
    Harmless while reannounce was rare. Then the verified wake started broadcasting
    one a minute to prompt boards that were already awake, which meant a board could
    be re-blocked mid-sy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
    [main.cpp]
2026-08-19 hearth: make it actually flicker
    It read as slow blinking because the flicker was smoothed almost flat. Copying
    the candle's 0.88/0.12 filter left a swing of about one level in 255 between
    gusts — invisible — so the only thing visible was the gust dropping to 55% about
    once a second and crawling back over a third of a second. Slow pulsing, not a
    flame.
    Follows the target much more closely now (0.55/0.45), over a wider range, on an
    irregular 25-70ms frame so it never settles into a rhythm. Step to step the
    brightness moves four times as much as before. Average output drops to 87% of
    what it was, since the wider range reaches further down, so it costs nothing on
    battery.
2026-08-19 mic_test: ask a board what its microphone is actually producing
    There was no way to tell a dead microphone from a working one that simply had
    nothing to hear. The chirp path computes exactly the number that would answer it
    — the best correlation for every failed chirp — but only logs it to the client's
    own USB serial, which is no use for a board hanging in a tree.
    CMD_MIC_TEST has a client listen for half a second at the same 10 kHz the chirp
    recorder uses and report the raw ADC statistics back: min, max, mean and the RMS
    about the mean. That separates the cases. A flat line means nothing reached the
    ADC at all. A mean pinned near 0 or 4095 is the bias network rather than the
    mic. A mea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
    [main.cpp, main.py]
2026-08-19 let aubio read midi_params: /getMidiParams needs no session
    aubioAlgo fetches midi_params from the API every 30 s, with no token — it is a
    local daemon, there is no session to carry. The auth middleware answered 401 and
    aubio logged a warning and carried on with its compiled-in defaults, so every
    parameter set in the UI was silently ignored: mode above all, which meant the
    pitch detector ran in frequency mode no matter what was selected, and the -38 dB
    rmsMin default rather than whatever threshold was configured.
    Public now, alongside /internal/keyboard_event which exists for the same reason.
    It is a read-only settings fetch.
2026-08-19 system_info: report the scheduled sleep phase, not just the manual one
    sleepUntilActive covers sleep_now and sleep_until, but the recurring schedule
    broadcasting sleep was reported nowhere — and from outside it looks identical to
    a fleet that has died: boards sync, go dark, stop answering, and only a command
    repeated often enough to catch a listen window gets through. sleepPhaseActive
    says whether the phase is running, inSleepWindow says whether the clock thinks
    it should be.
2026-08-20 don't abandon setup() when esp_now_init fails on a warm boot
    A software reboot left clients stuck; the physical reset button did not. That
    difference is the whole diagnosis: ESP.restart() is a warm boot and leaves the
    wifi driver part-way through teardown, so esp_now_init() can fail where it
    succeeds from cold — there is no delay between WiFi.mode() and the init to
    absorb it. And on failure setup() printed a line and returned, before
    ledInstance.setup() and msgHandler.setup(), so the board came up with no LED
    task, no receive task and no announce: powered, but completely inert.
    That is exactly what "reboot all clients" produced, and why hard-resetting each
    board by hand fixed it — a col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
    [main.cpp]
2026-08-20 reboot clients one at a time, and give each card its own reboot button
    Reset was a broadcast repeated ten times, so the whole fleet restarted at once
    and a good share came back wedged. It now walks the address list and sends
    CMD_RESET_SYSTEM to each board directly, a second apart, so every board's boot
    has the mesh to itself. That runs as a task: a hundred boards at a second each
    is a hundred seconds, and the loop watchdog panics at five.
    Each device card gets a Reboot button behind a confirm, over a new reset_client
    command that takes a boardId — the granular version of the same thing, for when
    one board is sulking and restarting the fleet is not worth it.
    [main.cpp, main.py]
2026-08-20 pitchdetector: choose the input device, and show the level
    Both scripts took the first input-capable device with no way to override it,
    which is a coin toss on a pi and becomes a near-certain wrong answer once an
    audio interface is plugged in — and calibrating or listening on the wrong input
    is indistinguishable from a dead microphone.
    --list-devices prints what is available, --device takes an index or part of a
    name. aubioAlgo also gains --meter, which prints level and pitch every 200ms
    ahead of every gate and sends nothing, and its routine two-second stats line now
    carries the peak dB alongside the gate it has to clear. Without that a level too
    quiet to pass looked identical in the log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
    [aubioAlgo.py, rms_calibrate.py]
2026-08-22 name the audio input in config, and cope with a two-channel interface
    Nothing is needed at the driver level for a Scarlett — it is USB Audio Class 2,
    so snd-usb-audio takes it. What does need saying is which input to listen on,
    and that was only reachable by editing code.
    --device now defaults to SPARKLES_AUDIO_DEVICE, set in the service unit, and
    matching by name rather than index survives the card renumbering a reboot or a
    replugged interface causes. A name that matches nothing falls back to the first
    input with a warning instead of retrying forever, so the name can be set before
    the hardware is plugged in.
    The Solo also presents two inputs, and interfaces with more than one channel
    so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
    [aubioAlgo.py]
2026-08-22 aubio: pick the input itself, and take the thresholds from the room
    Two things that had to be configured by hand and should not have to be.
    The input is now chosen by scoring the candidates rather than taking whichever
    enumerated first. Interfaces and USB microphones score positively, the pi's own
    pseudo-devices — dmix, sysdefault, loopbacks, hdmi — score negatively, and
    several of those report input channels and would happily be selected while
    returning silence forever. On a realistic enumeration a Scarlett wins over a USB
    mic, which wins over everything else, and unplugging the interface falls back to
    the mic rather than to a pseudo-device. --device still overrides, and a name that
    ma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
2026-08-22 sound level test in the web interface, with the result stored
    A five-step version of rms_calibrate, in the browser. Sing at five steadily
    louder levels for three seconds each, read the average and peak per step, then
    Set: the quietest step becomes the gate, the loudest the top of the range.
    The browser cannot measure for itself — aubio holds the audio device and nothing
    else can open it while it runs — so aubio posts what it is hearing to the API a
    few times a second and the test samples that. Same feed drives a live meter, so
    "no signal, is aubio running?" is answered before you start singing rather than
    after five steps of nothing.
    Stored on the pi, not the master: the master keeps m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
2026-08-22 level test: say which loudness, and count you in
    The test asked for five steps without saying what any of them meant, then
    recorded three seconds in silence — no target, no idea when to start singing or
    when to stop.
    Each step now names what to aim for, from "barely audible" to "as loud as you
    will ever perform", and there is a two second count-in before anything is
    measured: clicking and measuring in the same instant caught the breath before
    the note and dragged the step down. The button carries the state — "Start
    singing… 2", then "Hold it… 3s" — so the countdown is where you are already
    looking.
    The table gains the step up from the previous level, and a step that came out no
    l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
2026-08-22 notice the microphone being swapped while running
    Device choice only happened at startup or when a read threw, which covers
    unplugging the active device and nothing else. Plugging a Scarlett in next to a
    working USB mic raises no error at all, so the stream carried on with the worse
    input until someone restarted the service.
    It now fingerprints /proc/asound/cards every three seconds and reopens on any
    change, which catches a device appearing as well as one going away. Reading a
    small file is nearly free where re-enumerating through portaudio is not.
    Second watchdog for the case a read failure never comes: a device can vanish and
    leave the stream returning silence for ever, indistinguishabl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
    [aubioAlgo.py]
2026-08-22 level test: confirm the save where you can see it
    Clicking Set looked like it did nothing. It did save — the confirmation just
    rendered in the page-level banner about two hundred lines of markup above the
    card, so it was off screen exactly when it mattered. The button also kept its
    old label and the slider below never moved: noUiSlider is built once at mount
    and ignores later changes to start, so the values it showed were whatever they
    were when the page loaded.
    The card now confirms in place, the button becomes Set again, and the slider is
    re-keyed on save so it shows what was stored. Keyed on a counter that only the
    save bumps, not on the values themselves, or dragging it would rebuild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
2026-08-22 never let the startup calibration hang the detector
    calibrate_levels looped a fixed frame count around a blocking stream.read(), so
    a device that is open but not delivering — claimed by something else, or a rate
    the interface will not actually run — hung it before the detection loop ever
    started. From outside that is invisible: the midi_params poll runs on its own
    thread and keeps logging happily, so the service looks healthy while nothing is
    measured, nothing is reported and nothing reaches the fleet.
    Bounded by the clock now, four seconds, and it says so when it gives up. It also
    logs before it starts, so a stall is visible rather than inferred.
    Level reporting was a thread per sampl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
    [aubioAlgo.py]
2026-08-22 manual rms edits persist, instead of being overwritten by the overlay
    The level test made getMidiParams overlay the stored thresholds on the way out,
    which quietly broke adjusting them by hand: setMidiParams pushed the new values
    to the master, the overlay served the old stored ones straight back, and the
    slider snapped to the calibration on the next reload. With a noisy room that
    left no way to raise the gate at all.
    setMidiParams now stores them the same way the test does. Any deliberate setting
    counts as a calibration however it was arrived at, so the slider works, and the
    values survive a master reboot rather than living in its RAM as they did before.
    [main.py]
2026-08-24 stop leaving the OTA network in every client's flash
    Boards spend every post-nap minute hunting for "fogscreen", an AP that does not
    exist, retrying every 2.4 s for ever. Nobody set that SSID: it is OTA_WIFI_SSID,
    and the only thing that joins it is an OTA — but an OTA does not have to be
    asked for. The master sends MSG_UPDATE_VERSION on any version mismatch and the
    client runs performUpdate() by itself, which calls WiFi.begin(OTA_WIFI_SSID).
    arduino-esp32 persists credentials by default, so one such attempt — routine
    whenever a client and the master are on different builds, which is most of
    development — writes that network into NVS permanently.
    turnWifiOn() then calls a bare WiFi.be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
2026-08-24 no version-triggered OTA after a wake
    A version-triggered update is fine at boot, when the board has nothing else to
    do. After a nap it is the worst possible moment: the board leaves ESP-NOW to
    join an AP exactly when it should be re-announcing and resyncing, and if that
    network is not up it spends the rest of the night hunting for it instead of
    listening to the master.
    handleSleepWakeup sets a flag as it comes back, and MSG_UPDATE_VERSION is
    ignored while it is set. Cleared only by a reboot, which is also how you take
    the update: reboot the board and it offers itself for one on the next announce.
    The explicit OTA command is untouched — asking for an update is still asking.
2026-08-24 version mismatch no longer starts an OTA
    A board on a different build had an update pushed at it with nobody asking:
    master answered the announce with MSG_UPDATE_VERSION, the client left ESP-NOW to
    join OTA_WIFI_SSID, and when that network was not up it sat hunting for it. The
    client now ignores the message outright.
    The master's half needed removing too. It sent the update and then skipped the
    announce entirely, so a mismatched board was never synced — it was expected to
    update itself instead. With the automatic update gone, refusing to sync it would
    have stranded it, so it now logs which build the board is on and syncs it like
    any other.
    CMD_OTA_UPDATE is the only thing left that start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
2026-09-08 reboot the chirp device from settings — it never answered one before
    The chirp device ignored CMD_RESET_SYSTEM outright: its command switch handles
    the calibration commands and drops everything else on default. It is also not in
    the address list, so the sequential fleet reboot never targets it and a
    broadcast reset was never listened for. Unplugging the usb was the only way to
    restart it.
    It handles the command now, and a reset_chirp command addresses it directly —
    createCommandMessage already points at the chirp device when not broadcasting.
    Button sits with the other one-shot device actions in Settings, behind a
    confirm.
    [main.cpp, main.py]
2026-09-08 health check pings every board and names the ones that stay quiet
    There was no way to ask a single client how it was doing. get_system_info is
    the master's own state, and the two existing per-client round trips answer
    narrower questions: timer_test returns a clock delta, mic_test raw ADC
    statistics. Nothing reported battery, heap or uptime per board, so the only
    picture of the fleet was whatever the last sync happened to leave in the
    address list — and a board that had dropped off since looked identical to one
    that was fine.
    CMD_HEALTH_PING/MSG_HEALTH is the missing pair, modelled on mic_test. Clients
    answer inline in handleReceive rather than from a task: the master asks one
    board at a t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
2026-09-09 chirp device: the DAC was re-locking through every chirp
    Distance calibration has been emitting a rasp rather than a chirp since
    1b08d21. That commit stopped enabling the I2S channel once at boot and started
    gating it around each chirp — preload, enable, play, disable — so that the
    emission timestamp would be exact rather than smeared across the DMA ring.
    But .mclk is I2S_GPIO_UNUSED, so the PCM5102A has no clock of its own: it
    recovers one from BCLK with its internal PLL. Disabling the channel stops BCLK.
    Every chirp was therefore played into a DAC whose PLL had just lost lock, and a
    24 ms chirp is long over before it settles — what came out was the PLL settling,
    not the waveform. It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
2026-09-09 tell clients which network to fetch an OTA from
    OTA_WIFI_SSID was compiled in as "fogscreen", a network that does not exist
    here, so a board sent to update left ESP-NOW to hunt for an AP that was never
    coming up. The pi knows which network it is on — WLIAN at home, its own Sparkles
    hotspot when that is out of range, both created by setup/06_wifi.sh — and that
    is the network the firmware image is reachable on, so it is the one to hand over.
    The url had to come along, and this is the part that was quietly broken. The
    client's CMD_OTA_UPDATE handler called ota.setup() with no argument, which sets
    updateUrl to the compiled-in http://192.168.4.1/firmware.bin — the master's
    SoftAP. The pi h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
    [main.cpp, main.py, serial_bridge.py]
2026-09-09 master comes back after a flash again
    esptool resets these chips by driving the RTC watchdog — it prints "Hard
    resetting with RTC WDT" — and that watchdog is clocked by the RTC slow clock.
    setup() switched that clock to RTC_SLOW_FREQ_8MD256, 31.25 kHz against the
    default RC_SLOW's ~136 kHz, so esptool's reset was timed against a clock 4.4x
    faster than the one actually running. The master therefore did not reboot after
    a flash and could not be driven into its bootloader at all, while every other
    board reset cleanly. 1922d04 removed that call from the client for unrelated
    reasons; the master kept it, and it never sleeps, so it bought nothing.
    Worth spelling out because it cost hours: a fa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
    [main.cpp]
2026-09-09 chirp detection: the DAC was on the wrong I2S slot format
    Every board heard every chirp and no board could recognise one. The client's
    correlation returned 0.000 against a 0.15 gate, so the master reported "no board
    heard the chirps" — which was the opposite of what was happening.
    i2sInit sent MSB/left-justified. This PCM5102A wants Philips, one bit delayed.
    On Philips the same chirp arrives 1.5x louder acoustically (10 ms block rms 330
    against 220) and correlates at 0.18-0.20 with peaks repeatable to a fraction of
    a sample. On MSB it correlated at zero. That was the first hypothesis of the
    session and it was dropped for a bad reason: the A/B ran while the analog path
    was dead, so both fo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
    [main.cpp]
2026-09-09 chirp burst runs on one continuous clock
    The channel was disabled between chirps, so BCLK stopped and the PCM5102A's PLL
    re-locked ten times per burst. One enable for the whole burst instead, with
    silence written between chirps so the clock never stops.
    Timing gets better rather than worse for it. The peripheral consumes at exactly
    I2S_SAMPLE_RATE from the instant it is enabled, so frame k leaves at
    enable + k/rate: counting frames as they are written gives each chirp its
    emission time by arithmetic, with no lead-in term to subtract. And because the
    writes block in real time, the burst paces itself sample-accurately instead of
    drifting against a tick scheduler — measured spacing is now ex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
    [main.cpp]
2026-09-09 chirp device: the clock never stops, so the DAC never mutes
    Only three of ten chirps were audible, and the count tracked the lead-in length:
    100 ms lead-in gave six, 40 ms gave three. Not the correlation, not the client —
    the sound was never emitted. The firmware wrote all ten and the DAC consumed
    them on schedule (measured wall-clock spacing 19.30, 19.80 ... 23.80 s, exactly
    matching the frame offsets), yet only the chirps late in the stream came out.
    The PCM5102A soft-un-mutes and settles its charge pump when its clock starts,
    and that takes seconds. Every arrangement so far stopped BCLK: 1b08d21 disabled
    the channel between chirps, so all ten played into a muting DAC; enabling once
    per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
2026-09-09 client: stop the RX log starving the diagnostics
    Serial.setTxTimeoutMs(0) drops bytes rather than blocking, and onDataRecv logged
    a line per received frame — timer packets at 50 Hz during a sync, an animation
    per broadcast, and now a sound-device announce every 10 s. That fills the CDC
    buffer and discards whatever comes next, which was reliably the CLAP window
    report: the diagnostics disappeared during precisely the burst they existed to
    explain, and three runs in a row looked like "the client never opened a window"
    when it had opened all ten.
    esp_log_level_set("RX", ESP_LOG_NONE) did not take, so the routine types are
    skipped at the call site instead. With them gone all ten windows repor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
2026-09-09 chirp device: inaudible dither keeps the DAC awake
    The DAC needs ramp-up. Two 10-chirp bursts three seconds apart made it
    unmistakable: the first burst produced 4 audible chirps and the second produced
    10. It was never dropping random chirps and never fading — it loses whatever
    plays while it is waking, and once awake it stays awake. A single burst could
    not distinguish that from "loses a random few", which is why this took so many
    attempts to pin down.
    Everything tried before failed for the same underlying reason. Disabling the
    channel per chirp (1b08d21) stopped BCLK, so it woke ten times per burst and
    almost nothing came out. Enabling once per burst moved the boundary but still
    started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
    [main.cpp]
2026-09-09 verify the emitter's clock instead of assuming it
    The design was already right: emitter stamps emission in master time, client
    stamps detection in master time, master subtracts. What was missing is any check
    that either offset is still valid.
    The master's clock is microseconds since its own boot, so a master reboot
    invalidates the emitter's offset completely. Re-syncing needs ten correctly
    paired timer packets and can silently fail — and the emitter only ever reported
    its *first* sync (`if (!timerSynced)`), with the master's own comment saying it
    "accumulates offset silently". So an offset belonging to a previous master
    generation was indistinguishable from a fresh one, and it put every e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
    [main.cpp]
2026-09-10 a battery reading of zero is a broken sensor, not an empty battery
    A client would answer pings but refuse to blink or sync, and nothing anywhere
    said why. Reading the master's fleet dump showed it: that board reports
    batteryPercentage 0, and the client discards every animation below
    BATTERY_LOW_THRESHOLD. Pings kept working because they never consult the
    battery, so the board looked healthy and simply ignored anything visible.
    Zero cannot mean an empty battery. A board flat enough to read 0% could not be
    powering its radio, receiving ESP-NOW and replying to us — so a zero is a failed
    measurement, and the response to a failed measurement should not be to go dark
    permanently and say nothing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
    [main.cpp]
2026-09-10 don't throw away an announce because a sync is running
    Joining could take minutes, with the client logging "sent announce - nothing
    from master" the whole time while the master looked alive and busy. It was: the
    master discarded every announce that arrived during a sync, in two separate
    places — the syncActive filter in onDataRecv, and an outright `continue` in the
    MSG_ADDRESS handler. A sync that fails runs until getTimerCounter() > 100, which
    is 100 packets at 20 ms, so two seconds per board; across four boards and three
    passes plus retries the master is in that state most of the time. A client had
    to land its once-a-second announce in a gap, and every miss cost it another
    second. Reboot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
2026-09-10 a wedged chirp burst no longer fails in silence
    "No board heard the chirps" turned out to be reported when no chirp had been
    requested at all. Triggering a burst produced no event of any kind — not even a
    failure — and only a master reboot ever helped. Three separate things conspired
    to make that invisible.
    runFastResyncAll waited for its worker batch with an unbounded
    `while (eTaskGetState(handles[j]) != eDeleted) vTaskDelay(10)`. Beyond having no
    timeout, eTaskGetState on the handle of a task that has deleted itself and been
    reclaimed by the idle task reads freed memory, so it may never report eDeleted.
    Whatever called it hung — normally the chirp burst task, which then never
    reache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
2026-09-10 the peer table had no accounting, and 20 slots
    ESP-NOW holds ESP_NOW_MAX_TOTAL_PEER_NUM (20) peers and the fleet is far larger,
    so peers are added and removed around each send. That makes the table shared
    mutable state across every task that sends, and there was none of the bookkeeping
    that implies.
    addPeer wrote through a shared peerInfo member rather than a local, so two tasks
    calling it concurrently raced on that struct — one could add a peer for the
    other's address, or have esp_now_get_peer overwrite it mid-call. handleSend, the
    timer syncs, the clap sync and the five fast-resync workers all call it from
    different tasks with no lock. It uses a local now, behind a mutex with a bounded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
2026-09-10 trust the radio's src_addr, not whatever the sender wrote
    The master learned who sent a frame from message_data.senderAddress — a field
    the sender fills in itself. Several senders fill it from a cached MAC that is all
    zeros, and the sound device is one of them: its announce arrived with
    senderAddress 00:00:00:00:00:00, so the master copied that into
    clapDeviceAddress and every unicast to the emitter went nowhere from then on.
    Which produced a long chain of symptoms that all looked like other things. The
    emitter was never engaged, so it never got a delay measurement, so
    runClapDeviceTimerSync bailed, so its clock was never confirmed, so every chirp
    burst was refused — and before the refu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
2026-09-10 tx slots and resync margin: fail loudly, recover on their own
    Two small pools that failed silently, found while chasing why clients keep a
    stale clock offset. Neither is confirmed as the cause of that, but both turn a
    silent permanent failure into a visible, self-correcting one.
    There are eight TX slots and they exist only for the length of one sync — a few
    hundred ms — so a slot still held much later belongs to a task deleted between
    its acquire and its release. Once all eight leak, every sync sends lastDelay = 0,
    and both the clients and the emitter reject a sample without a measured delay:
    they need it to correct for queueing. So the whole fleet quietly stops being able
    to sync, keep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
2026-09-10 resync serially: the parallel pool was biasing the clock it measured
    Clients had stopped completing timer syncs, and the reason was measurable once
    the client counted why it threw samples away. It needs TIMER_ARRAY_COUNT
    accepted samples and only accepts one whose predecessor carried a measured TX
    delay under 6 ms. The counters showed gap=0 — the packet sequence was never
    broken — and the losses were all delay-related.
    Measured on one client, same run, both modes:
    serial, one board mean 2768 us max 12268 2 of 23 rejected (9%)
    parallel, 5 workers mean 5584 us max 25955 13 of 30 rejected (43%)
    Five workers' traffic through one radio doubles the delay each of them then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
2026-09-10 the emission stamp was the emitter's uptime, not master time
    Chirp arrivals were rejected as roughly four hours out, and the number was
    literal: the emitter had been switched on for about four hours.
    The emitter stamps each chirp by frame arithmetic — the I2S peripheral consumes
    at exactly the sample rate from the enable, so frame k leaves at
    enable + k/rate — and it anchored that with audioEnableTime = syncedTime()
    captured at the enable. The pump is enabled in setup(), before this device has
    ever synced, when timeOffset is still 0. So the anchor was frozen in raw local
    uptime and never recomputed. The clock sync afterwards set timeOffset correctly,
    and the master validated it to withi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
    [main.cpp]
2026-09-10 the clap task could fail to start and say nothing
    A client would receive CMD_START_DISTANCE_CALIBRATION, receive all ten chirp
    announcements, and never open a listening window. No log, no error — the board
    looked healthy and simply did not participate, which downstream is reported as
    "no board heard the chirps".
    startClapTask had two silent failures. The handle has two writers — the task
    clears it as it exits, and CMD_CANCEL_CALIBRATION deletes it — so it can hold a
    task that is already gone, and vTaskDelete on that is undefined. And the result
    of xTaskCreatePinnedToCore, asking for 10 KB of stack at priority 20, was
    discarded, so a failed allocation left nothing listening and nobody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
2026-09-19 muse: keep the link up
    Two reasons the headband kept dropping.
    BleakClient was handed a bare address string, so the BlueZ backend went off to
    resolve it to a dbus path itself. The Muse only advertises in bursts, so by the
    time it looked the cache had gone cold and it raised "Device with address ...
    was not found" moments after a scan had plainly seen it. Pass the BLEDevice
    from the scan straight through instead, and rescan on every reconnect since a
    device object is stale once the link drops.
    Nothing was sent on the control characteristic once streaming started. Incoming
    notifications do not count as activity and the headband hangs up on a control
    channel that has gone quiet, which shows u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
    [muse.py]
2026-09-19 muse: subscribe to control, and beat the idle timeout
    It connected and streamed, then hung up 7.6s later. The keepalive was set to 8s
    and sleeps before its first write, so the first k was due at 7.9s and missed by
    a fraction. Drop it to 5s.
    Also subscribe to the control characteristic. muse-lsl does, and we did not:
    the headband replies to v1 and s there, and with nobody subscribed those
    replies have nowhere to go.
    [muse.py]
2026-09-19 muse: log how long a session lasted
    A constant time to disconnect means something is hanging up on us on a timer; a
    scattered one means the link itself is failing. Hard to tell those apart by
    eyeballing timestamps across runs.
    [muse.py]
2026-09-19 muse: a dropped link is not a new visitor
    Muse (and so Settle) was built inside run_session, so every reconnect wiped the
    baselines and dropped the visitor back to learning one. With the link dropping
    every 17s the anchor window could never finish.
    Build it once for the whole run instead. Settle now watches for gaps in its own
    calls: a few seconds means the link went down and the session carries on, more
    than SESSION_DROP means somebody else is wearing it. Signal buffers are still
    thrown away on reconnect -- the samples either side of an outage are not
    continuous -- but the session they belong to is not.
2026-09-19 muse: say whether the headband is reachable
    Pressing start and waiting to see what happens is a poor way to find out the
    headband is switched off. /brain/devices scans and reports name and RSSI, and
    the page shows it before you commit to a session.
    Scanning disturbs an active connection, so while a session is running it
    reports what that session already knows instead. An empty result is ambiguous
    on purpose and says so: a Muse that is already connected to something stops
    advertising, so not-found means off OR taken.
    RSSI is there because the drops look like a marginal link and a number beats
    guessing.
2026-09-19 muse: do not orphan the pipeline on restart
    brain_start spawns into its own process group so one stop takes the whole
    pipeline down. The same isolation means a service restart leaves it running:
    it keeps the headband connected, and the new instance knows nothing about it,
    so the next session waits forever for a headband that is very much in use.
    The giveaway is the PPG led staying lit with no session to explain it.
    Kill any leftovers on startup, and take the pipeline down on shutdown so a
    clean restart does not need the sweep.
2026-09-19 brain page: stop claiming a connection we do not have
    "headband held by this session" was shown whenever a session was running,
    whether or not it had ever reached the headband -- so it sat next to "waiting
    for the headband" saying the opposite thing. Report the phase instead:
    connecting while nothing has arrived, connected with the contact count once
    frames are flowing.
2026-09-19 muse: never hang silently on connect
    It found the headband and then stopped dead: no connect, no error, nothing in
    the log at all. BlueZ will sit in Connect() indefinitely against a stale link,
    well past bleak's own timeout, and the async with gave it nowhere to give up.
    Bound every step and say which one is being attempted, so a hang becomes a
    logged failure and another scan rather than silence. Same for the teardown,
    which could equally well block on a link that is already gone.
    [muse.py]
2026-09-19 muse: contact was measured wrong, and the page blamed the wrong thing
    The page said "waiting for the headband" while streaming 57bpm off a 60%
    battery. It was connected fine; contact was 1/4, below the two electrodes
    Settle needs, so the phase stayed waiting and the label read as a connection
    failure. Say which it is: connecting, connected-but-N/4, or the real phase.
    Contact itself was judged on raw peak-to-peak against an 800uV ceiling, but a
    freshly placed electrode wanders hundreds of microvolts below 1Hz -- good
    channels were being written off as railed, which is likely why it read 1/4.
    Detrend and band-limit to 2-44Hz first, and report each channel's amplitude so
    a bad electrode is vis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
    [main.py, muse.py, muse_bridge.py]
2026-09-19 brain status: pass the whole frame through
    The page said "connecting..." over a live connection because /brain/status
    hand-picks the fields it returns, so connected and channels never made it out
    -- and the 3s poll then overwrote the good values SSE had delivered.
    Return the last frame as it arrived, with defaults filled in. Anything
    muse_bridge adds now reaches the page without needing plumbing in two files,
    which is the actual bug here rather than the missing field.
    [main.py]
2026-09-19 muse: a run-by-hand mode that still drives the lamps
    Diagnosing this meant choosing between watching the numbers and driving the
    lamps, because the bridge eats stdout. Put the diagnostics on stderr instead:
    stdout stays the lamp stream, both scripts log to the same terminal, and one
    command shows the whole chain.
    muse.py --json --preset p21 | muse_bridge.py --diag
    Adds the numbers that were missing when guessing at the drops: eeg packets per
    second, how long the current link has been up, and how many times it has
    dropped this run. A healthy link runs ~85 pps, and a stall shows up there
    before the connection dies -- which is the difference between the link failing
    and us failing to serv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
    [muse.py, muse_bridge.py]
2026-09-19 muse diag: do not reprint stale frames as if they were live
    When the stream stopped, --diag kept printing the last good frame once a second
    -- 42 identical lines showing a healthy contact 4/4 for a headband that had
    stopped talking entirely. Say NO DATA and how long for.
2026-09-19 muse diag: distinguish never-arrived from stopped
    NO DATA printed 0.0s when nothing had ever been received, which reads as a
    stream that just stopped rather than one that never started.
2026-09-19 muse: stop blocking the event loop on stdout
    The packet rate was reaching 112/s, which is above what the headband can
    physically send (4ch x 256Hz / 12 = 85.3). Those were not extra packets, they
    were queued ones arriving at once. The keepalive confirmed it: a 5s timer that
    went 12.2s between firings, exactly across the window where the rate collapsed.
    Nothing was being serviced -- not notifications, not the keepalive -- so the
    headband hung up on a central that had gone quiet.
    The cause was print() to the pipe from inside the event loop. A slow reader
    fills the pipe, the write blocks, and it takes BLE down with it. Frames now go
    out on their own thread through a bounded queue, dropping rat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
2026-09-19 muse: show why settle is stuck, and let the bar be moved
    settle sat at exactly 0.00 through 33s of live phase with rise=20, so the
    evidence never once cleared the bias -- but there was no way to see which of
    still/emg/alpha/beta was holding it down. Report each component score and the
    combined evidence, and print them under the diag line.
    Also make the bar itself adjustable with --bias. 0.6 asks for meaningfully
    calmer than arrival, which is a lot to ask of two honest channels when p21
    leaves no heart rate to combine with them.
    [muse.py, muse_bridge.py]
2026-09-25 muse: six connection bugs found on a fresh read
    A connect that failed or timed out was never torn down. The try/finally that
    disconnects only began after connect() succeeded, so when wait_for cancelled a
    connect mid-flight BlueZ was left holding a half-open link and every later
    attempt wedged against it -- the stale link that took bluetoothctl to clear by
    hand.
    The handshake did not actually wait for 's'. The event was cleared after v1 and
    the preset had been sent, so their late acks satisfied the wait meant for 's'
    and 'd' went out early -- the log shows it two seconds before the status reply,
    in a session that then never streamed. Each command now waits for its own
    reply, and 's' specific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
    [muse.py, muse_bridge.py]
2026-09-25 muse: tests that live in the repo
    The previous checks lived in a scratch directory that got wiped, taking the
    regression coverage with them. Standalone like test_system.py, no hardware:
    the BLE side runs against a fake BleakClient that fails the ways the real
    headband did -- late acks, connects that raise or hang, dropped packets, and
    the music socket vanishing under the bridge.
    Run against the previous commit, the connect-teardown and handshake checks
    fail exactly where the bugs were.
    [test_muse.py]
2026-09-25 muse: measure link stability instead of eyeballing it
    Every judgement about whether the connection holds has come from scrolling
    log lines across runs of different lengths. Keep a ledger instead: how much
    of the time the link was up, every link's length, drops the headband or BlueZ
    caused (not our own shutdowns), connect failures by phase and reason, and
    event loop stalls. One line a minute while running, a summary on exit.
    --soak N runs for N minutes and stops, so a change can be judged by one
    uptime figure before and after.
    [muse.py, test_muse.py]
2026-09-25 muse: tear down on every way a session can be stopped
    A soak held the headband for eight minutes with no drops, then ignored the
    SIGINT sent to stop it and died on SIGTERM with no summary. Both signals skipped
    the teardown: a background job inherits SIGINT as ignored and Python keeps it
    that way, and SIGTERM kills Python outright. SIGTERM is also what the Brain
    page's Stop and the restart sweep send. So every Stop skipped the halt and the
    disconnect, and BlueZ -- which owns the connection, not the process that made
    it -- went on holding a link nobody was reading. A connected Muse stops
    advertising, so the next Start scanned forever: "waiting for the headband".
    Handle SIGTERM and SIGINT on t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
    [muse.py, test_muse.py]
2026-09-25 brain page: show what settle is made of, so it can be tuned
    The light barely moved and the page could not say why: it showed the final
    settle and nothing that feeds it. Add a tuning panel -- the last three minutes
    of evidence against the bias line, with settle over it, and each channel's
    score centred on the visitor's own baseline. Relaxed evidence that never
    crosses the line means the bias is too high; that is the number to find.
    bias and min brightness are now settings, with tuning-friendly defaults, and
    the page remembers what was used last in this browser so a setting that works
    survives the next session.
    muse.py never sent its bias, so the diag line claimed "need >0.60" even on a
    --bi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
    [main.py, muse.py, muse_bridge.py]
2026-10-05 chirp device: one writer on the I2S channel, which the timestamps depend on
    Emission stamps are arithmetic on audioFrames: frame k leaves the DAC at
    enable + k/rate, so the counter has to be the exact stream index. Two things
    were quietly breaking that.
    The audio pump was started twice — ac3a478 added it, fb662a5 added it again
    instead of editing the line, which is why the two comments above it were
    different drafts of the same thought. Two tasks each re-enabled the channel
    under the other, each reset audioEnableTimeLocal and audioFrames, and both ran
    audioFrames += n as a read-modify-write on a 64-bit volatile from different
    cores. Lost updates make the counter undercount, so stamps come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
2026-10-08 chirp device: first chirp lands in window 0, and stamps count the DMA ring
    Every board heard nine chirps per burst and the master kept none of them.
    The pump queued the first chirp a whole burst period after the request
    (ac3a478), while the clients open window 0 the moment the same broadcast
    arrives. Chirp n played ~530 ms into window n, so window n+1 heard it and
    reported it as n+1, and the master paired it with chirp n+1's stamp — not yet
    announced when the report landed — and dropped it without a log line. Window 0
    heard nothing; chirp 9 played after the last window closed. Chirp 0 now goes
    out 40 ms after the request, ~70 ms into window 0. This is not the per-burst
    lead-in that cost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
2026-10-09 calibration: measure each spot in batches of 20, each synced right before its chirps
    A board's clock drifts from the moment it is synced — a few ppm, 2 cm a minute
    per ppm — and the resync before a burst ran every board in turn at 0.6 s each.
    With 100 boards the first ones were a minute stale when the chirps played: a
    fixed error per board of up to ~45 cm at 20 ppm, which neither the ten-chirp
    average nor the solver's shared offset can remove.
    Each spot now runs in batches of at most 20, evenly sized (45 boards go
    15/15/15): resync the batch, sync the emitter last, then one burst. No board
    waits more than ~18 s. The command stays a broadcast so every window lines up
    with the emitter —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
2026-10-11 chirp device: status LED and a test chirp from settings, for field debugging
    A silent calibration had three suspects and nothing to tell them apart without
    a laptop: the radio, the firmware or the audio path. This time it was a loose
    cable.
    The devkit's RGB LED now flashes R-G-B at boot, then blinks blue for every
    message from the master and green for every chirp handed to the DAC. No blue:
    it isn't hearing the master. Green and silent: the DAC, its cable or the
    boombox. GPIO48 is the LED on DevKitC-1 v1.0; v1.1 moved it to GPIO38, our
    BCLK, where it stays dark.
    Settings gets a Test Chirp button beside Reboot Chirp Device, with the LED
    legend. The master now broadcasts CMD_TEST_CHIRP: unic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
2026-10-11 resync: send until each board confirms, so it blinks like it does in Sync All
    A client blinks green when it completes a sync, whichever path triggered it.
    In Sync All the master keeps sending until the board confirms; the resync before
    a chirp burst (runTimerSyncAt, also Sync Fast) sent exactly 30 packets and
    stopped whether or not the board was done. A board that needed more kept its old
    clock, showed nothing, and was marked ACTIVE anyway — and its confirmation, when
    it did come, was dropped as stray, because the handler only knew the shared sync
    index.
    runTimerSyncAt now sends until the board confirms, matched by sender rather than
    through the shared index the announce path writes, and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
2026-10-11 calibration page: say how many chirps were sent, not the burst length
    "10 chirps each" read as what every board heard, next to a board that heard
    none of them.
2026-10-11 latency test: bursts with one board at a measured distance, delay and drift per burst
    Whether a speaker's delay can be written into the code depends on it holding
    still — across bursts, power cycles and volume — not on how precisely one
    average is known. The Calibration page gets a Speaker Latency Test: pick the
    board in front of the speaker, enter the distance, and it runs burst after
    burst (~9 s each), charting every chirp's delay and each burst's average, with
    a per-burst table, a summary (delay, range, trend per minute, drift within a
    burst, scatter), saved runs and CSV/JSON downloads.
    Master: latency_burst runs a normal burst that syncs and hears only that board
    and records nothing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
2026-10-11 client: one battery task, not one per sync
    startBatterySyncTask ran at the end of every completed sync and created a new
    task each time, and the task never exits — it loops, reporting every 10
    minutes. So every sync left another 10 KB task behind. After enough syncs the
    heap could no longer fit the 10 KB clap task: in the latency test the board
    heard four bursts, then kept confirming every resync and never listened again.
    The blink task is the same size, so a board that has synced often also stops
    blinking after a sync, and a reboot is the only thing that brings either back.
    Started once now, through the batterySyncHandle that was declared and never
    used. The level still reaches the maste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
2026-10-12 latency test: an End test button that ends the run on the pi
    Stop only closed this browser's stream, and sat where Start had been, easy to
    miss — pulling a plug was the way to end a run. End test asks the pi to stop:
    the burst in flight finishes, the run is saved as stopped, and the stream ends
    the normal way. It works from any browser, and a page opened while a run is
    going shows it, with its progress and the same button.
2026-10-12 chirp device: a constant offset between chirps instead of the 22 kHz dither
    The dither kept the DAC awake but a boombox with a digital input turned it
    into a loud hum. A constant +64 keeps it awake just the same (200 of 200
    chirps heard in a latency test) and makes no sound. 'd' over serial still
    switches to the dither or to true silence for testing.
2026-10-12 Client_Diag: a client build that logs every chirp arrival per window
    Prints the arrivals found on the correlation's outline, the raw recording,
    and takes the arrival from the outline instead of the ripple, for one board on
    a usb cable during a latency test. The chirp's own sidelobes reach 40% of the
    outline peak, so a copy counts from 70%.
2026-10-12 chirp device: 'l', 'r' and 'b' over serial put the chirp on one channel or both
    The other channel holds the idle offset. A stereo boombox then plays the
    chirp from one driver instead of two, whose spacing would blur the arrival
    for boards off to the side. Both channels stay the default.
2026-10-12 serial bridge: a line with a chunk cut out is one bad line, not a lost port
    The master drops bytes when the pi falls behind, and a damaged line can still
    parse, as {"event":10,...} or a bare number. Dispatching it raised, the read
    loop took that for a disconnect, and the reconnect threw away the next 5 s of
    traffic: whole latency bursts came back unheard, and at times every burst
    reconnected. Such frames are now skipped, and anything else dispatch raises is
    logged and dropped.
2026-10-13 master: every line for the pi from one task on core 1, one status line every 5 s
    Lines printed from the receive task on core 0 raced the USB interrupt on
    core 1: the print's flush cut the 64-byte packet the interrupt was still
    filling, and the driver dropped the rest. Half of all client_clap lines and a
    third of sound_device_seen reached the pi without their middle; lines printed
    from loop() never did. Every line now goes into a queue that one task on core
    1 writes out, in a single write each, and a full queue drops whole lines and
    counts them.
    The 5 s keepalive (animate_status, heap, num_devices and every board) is one
    status line: boards, active, animation, heap, uptime, dropped lines. Bo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
2026-10-13 speaker delay: measured once with a latency test, taken off every calibration chirp
    Every chirp's flight time includes the speaker's own delay, 40.34 ms for the
    current boombox, stable to about 2 cm across power cycles once it has been
    on for 4 minutes. The pi keeps the value (speaker.json), sends it on every
    connect, and the master subtracts it from calibration bursts but not from
    latency tests, which keep measuring the whole delay. The latency test card
    shows and saves it, and offers a run's mean as the new value.
2026-10-13 client: pick the chirp's arrival on the correlation's outline, mean removed first
    The raw correlation ripples at the chirp's pitch, and its earliest peak above
    70% of the maximum came one wave (0.43 ms, 15 cm) early in 13 to 31 of 50
    chirps in the boombox power-cycle runs. Correlating with the template's 90°
    twin as well gives an outline with one smooth peak per arrival; the same 70%
    rule on it never jumped in the 470 chirps checked, and the chirp's own
    sidelobes stay under half the peak. The mic's resting offset, 1275 of 4096 on
    one board, is taken out before matching instead of diluting every score
    threefold. Client_Diag keeps printing what the old rule would have picked.
2026-10-13 client: find the chirp on the un-normalised match, blue flash when nothing is heard
    Normalising every lag by its own signal energy made each faint, chirp-shaped
    echo score like the direct sound. At 4 m the echoes lifted the noise gate
    (mean + 5 sigma over the window) above the arrival: board 0 rejected every
    chirp of four runs, while the 20 windows it recorded raw held each one, loud
    and on time. The plain match magnitude has the direct sound 12 times above
    the median lag at 4 m and 37 at 1 m, where noise reaches about 3.5. A window
    now counts when its peak beats the median by 6, and the earliest peak at
    half the strongest wins: an echo came in twice as strong as the direct sound
    at 4 m, and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
2026-10-13 serial bridge: join a line that readline() returned in two pieces
    pyserial's readline timeout runs from the call, not from the last byte, so a
    line still arriving when the second ran out came back as its first half and
    then its second, and neither parsed: an update_board went missing during a
    calibration. A piece without a newline now waits for the rest.
2026-10-13 ui: reopen the live connection when the browser gives up on it
    A browser retries a dropped EventSource by itself, but stops for good when a
    retry gets an error status, a 502 while the Pi restarts its service. After a
    deploy the page then missed every event and sat on "distance calibration
    running" with the run long done. The listeners are now kept and attached to a
    new connection 3 s after the old one closes.
2026-10-13 air temperature: the speed of sound distances are worked out with
    Distances assumed 343 m/s, right at 20 °C. In a forest at 10 °C sound travels
    at 337 m/s, and every distance came out 1.7% long, 34 cm at 20 m. The
    Distance Calibration card takes the air temperature; the pi keeps it
    (air.json), turns it into the speed of sound and sends that to the master on
    every connect, which keeps it in NVS and shows it in its status line. The
    latency test undoes the master's distances at the same speed.
2026-10-14 muse: a reconnect is not a new visitor
    A link that drops takes 16 to 19 s to come back: 3 s retry wait, a full 8 s
    scan, connect, four acked commands, then 2 s of fresh samples before the
    first frame. That gap was held against the 15 s it takes to decide a
    visitor has gone, so nearly every drop threw their baseline away. A link
    outage now gets 60 s, enough for one failed attempt and a good one; 15 s
    of bad contact still ends a visitor as before.
2026-10-14 muse: dim on a head, dark off one, and the session ends when it comes off
    On a head the lamps now shimmer at 13 of 255, about 5%, and climb with
    settle from there, so a visitor who has not settled yet can see the lamps
    are listening. Off a head they go dark after 3 s, so fixing the fit does
    not blink them. After 15 s off, muse.py halts the headband, disconnects
    and exits, the bridge hands the lamps back with animation_off, and the
    Brain page says the headband came off. Start begins the next session.
    The cut is armed only once the headband has been on a head, so Start can
    be pressed before putting it on. A --soak run never ends this way. The
    page's Min brightness becomes Brightness on a head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
2026-10-15 muse: a Reset baseline button
    Learns the visitor's arrival level again without dropping the headband
    link. The page posts /brain/reset, main.py writes "reset" down a pipe it
    now holds on muse.py's stdin, and muse.py clears the score and starts a
    new baseline window. Typing reset into a hand run does the same. The chart
    is cleared with it, since its evidence was measured against the old
    baseline. The baseline window said the lamps stay dark; they glow at 5%
    now.
2026-10-15 muse: score against arrival as ratios, and log what holds it down
    A channel's step was how much it wobbled while the baseline was learned,
    never less than 5% of its level. Stillness is a 12 s average and barely
    wobbles in 15 s, so its step came out at 0.07 mg: 1.8 mg of movement
    against 1.4 mg at arrival scored 0.002, and evidence sat at 0.1 for a
    whole session however calm the visitor got. Stillness, jaw tension, alpha
    and beta are now compared as ratios, a step never less than a doubling:
    twice the movement scores 0.27, half scores 0.73. Heart rate gets at least
    5 bpm a step.
    Every 10 s the log gets each channel's score, value and arrival level, so
    the next session that will not light up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
2026-10-15 muse: retry a lost connect race at once, end the run when the headband is gone
    With bluetoothd's debug on, the failed reconnects turned out to be a race
    in BlueZ: when the headband's ATT channel comes up before the kernel
    reports the link, bluetoothd decides it is already connected, drops its
    own setup, and the connect fails 3 s in. Five losses in a row were seen,
    each paying a 3 s wait and an 8 s rescan. They are now retried at once
    with the same device, up to 5 times.
    A headband that had gone, switched off or flat, left the run scanning for
    hours with the lamps held at the last frame. After 60 s without a link the
    run now ends, and the page says the headband was out of reach.
    The drops t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
2026-10-18 muse: keep pitch detection and the keyboard off the lamps while the headband is worn
    aubioAlgo, keyboard_midi and muse_bridge all write to the music socket,
    so the microphone, the piano and the MIDI file player fought the headband
    for the lamps. muse_bridge now names itself with a hello line when it
    connects, and while the headband is on a head serial_bridge drops lines
    from every other client. They are dropped rather than queued, so taking
    the headband off does not replay a backlog of notes.
    main.py sets the hold from the worn flag in the brain status frames and
    always lets go when the pipeline ends: Stop, the headband coming off or a
    crash. The Brain page says so while it holds.
2026-10-25 muse: listen for the headband all the time, and leave the lamps to the mic unless it is worn
    A visitor should only have to switch the headband on and put it on. Start
    now means listening: main.py keeps the pipeline up, restarts it if it dies,
    and keeps listening on through restarts and reboots in brain.json, with
    the settings and slider values it listens with, until Stop.
    muse.py never ends by itself any more. It scans while the headband is off,
    stays connected while it is switched on, and forgets a visitor 15 s after
    they take it off. Scanning is the normal state now, so "no Muse found"
    is said once rather than every scan, and the minute line only shows when a
    link dropped or a connect fai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
2026-10-25 muse: brain waves decide, and the baseline waits for a steady signal
    A game of GeoGuessr lit the lamps. The baseline had been learned in the 40 s
    after the headband went on, moving about and with fresh electrodes still
    noisy, and the score ran on the body: sitting still with a loose jaw over
    a screen read as 2-6 times calmer than that, while heart rate, the one
    signal that noticed the game, was outvoted.
    The baseline is now learned only once 3 of the 4 electrodes have been in
    contact for 10 s with their level steady, not still falling as they
    settle onto the skin; until then the phase is "settling" and the lamps
    stay at their faint glow.
    The score now follows alpha over beta against arriva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
2026-10-25 muse: guided tests, recorded raw for scoring offline
    Three buttons on the Brain page, Meditation, Desk work and Talk & move,
    each learning the baseline again the same way (eyes open, sitting
    calmly) and then recording 2, 3 or 5 minutes of the condition. Every eeg,
    accelerometer and ppg packet goes into a JSON-lines file in
    sparkles-api/recordings as it arrives, with every frame and the scores the
    lamps used and a mark where the condition began, so a new rule can be
    tried on the same minutes of somebody's head. The page shows the
    instruction and a countdown, then how evidence, the lamp and each signal
    behaved, and lists the recordings for download.
    muse_bridge now takes each frame whole rath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
2026-10-25 muse: an electrode in the air is not on a head, and 3 s without the electrodes lets the lamps go
    Taken off and left on the table, the headband read 4/4 on a head a second
    later, and the lamps kept their glow with the microphone held off. The
    contact check only asked for a plausible level, and electrodes in the air
    have one. Their 30-45 Hz noise gives them away: 1e4-5e4 on a head, 2.5e5
    with the jaw clenched, 2.6e6-2.7e7 on the table. Above 1e6 an electrode
    now counts as off skin (--noisy to move it).
    The lamps were also held 30 s through a lost link, for a reconnect. Now
    any 3 s without word from the electrodes lets them go. Frames carry which
    electrodes count as in contact and each one's n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
2026-10-25 muse: only the electrodes behind the ears can tell skin from air
    With the headband firmly on, the page read 2/4 and a desk test never got
    past settling, which wants 3 steady electrodes. The forehead electrodes
    read 1e6-1e7 of 30-45 Hz noise on a head, as loud as air: the frontalis,
    which works while looking at a screen. The limit came from the temporal
    electrodes only, where it holds: 6e4-2.5e5 on a head, 2.6e6 and up on a
    table. The noise check now applies behind the ears alone; the forehead
    electrodes go by their level and count only while an ear one is on skin,
    so a headband on the table still reads 0/4.
2026-10-25 muse: retry the half-made links from BlueZ's race at once too
    After a drop the reconnects failed in setup instead of in connect: no
    replies, then "Service Discovery has not been performed yet", or
    "GATT Protocol Error: Unlikely Error". Each paid a full 11 s rescan.
    They are now retried at once like the connect race. The page's text for a
    missing link no longer tells someone wearing the headband to switch it
    on.
2026-10-25 muse: a quiet ear says on a head, then each electrode counts by a looser bar
    Firmly on, the page read 2/4 again: AF7 at 1106 uV, over the 900 limit,
    and TP10's noise at 1e6, right on the in-the-air limit, while TP9 sat at
    7e4. One quiet ear electrode still decides whether the headband is on a
    head at all. After that the second ear counts up to three times the
    limit (a lifted one read 4e6) and the forehead up to 1500 uV, so the same
    readings make 4/4 and a table still makes 0/4.
2026-10-25 muse: jaw tension from the ear electrodes in contact only
    The jaw measure averaged both ear electrodes whatever their contact. A
    lifted one hisses at 4e6 against 6e4 for one on skin, which read as a
    clenched jaw and held the lamps back with nobody tense.
2026-10-26 muse: a link that drops on a head is a glitch: hold the lamps, reconnect at once
    With the dongle the signal is strong, but the link still drops now and
    then from full strength (-61 dBm two seconds before, Connection Timeout),
    and every drop let the lamps go after 3 s and then waited 3 s and scanned
    8 s before reconnecting.
    People take the headband off before they switch it off, so frames that
    stop with the electrodes on skin are a glitch. muse_bridge now holds the
    lamps, and so the microphone off them, for up to 30 s after such a drop;
    with no contact at the moment it went quiet, or nothing back by then, it
    lets go as before: a flat battery or a switch after all. muse.py goes
    straight back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
2026-10-26 muse: name the Bluetooth adapter instead of taking bleak's first powered one
    With the TP-Link dongle and the built-in radio both powered, bleak picks
    the first adapter it lists, and after a restart that was the built-in one
    as often as the dongle: the headband went back to the weak radio without
    a word. --adapter names it (bluez={"adapter": ...} for the scanner and the
    client), and main.py passes hci0, the dongle, from brain.json; config.txt
    switches the built-in radio off from the next boot on, so hci0 stays the
    dongle. Start now merges the page's settings into the saved ones rather
    than replacing them, which would have dropped the adapter.
2026-10-26 muse: a USB Bluetooth dongle whenever one is plugged in, the built-in radio without
    Pinning hci0 relied on the dongle coming up first and on switching the
    built-in radio off at boot, which also took away the fallback when the
    dongle is out. --adapter auto, now the default, picks a USB adapter that
    is not rfkill-blocked from /sys/class/bluetooth before every scan, and
    the built-in radio only when there is none; plugging the dongle in or
    pulling it out takes effect at the next connect. bluetoothctl gets the
    same radio by a select on its input, since its command line cannot name
    one, so a stale link is released on the radio the headband is on.
2026-10-27 muse: a headband counts as worn only with a sign of life
    Lying on a table at 4 m it read 3/4 on a head, for six minutes at a time:
    an ear electrode in the air can be as quiet as one on skin, so electrode
    noise alone cannot tell. Recorded on the same evening, the PPG settles it:
    how plainly a heartbeat shows (strongest 42-180 bpm peak against the
    30-300 bpm median) read 2-9 on the table and 114-1193 on a head. While
    the headband is put on or adjusted the pulse blurs, but then it moves 5-30
    times more than a table ever does. So electrodes in contact now also need
    a pulse clarity of 20 or an accelerometer spread of 0.0035 g; with no
    pulse data the electrodes decide alone, as before. Over the re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
2026-10-27 muse: weigh each signal from the Brain page, with presets
    Evidence was alpha over beta with the body only able to hold it back, a
    rule fixed in code. Now six signals are scored against arrival, alpha,
    beta, theta, heart rate, stillness and jaw tension, and evidence is their
    average weighted by sliders on the Brain page: the calmer, the brighter,
    with 0 leaving a signal out. Weights change live (set weight in muse.py's
    input, /brain/weights) and are kept in brain.json.
    Four built-in presets: Brain waves, Deep meditation (theta counts too),
    Calm body, and Everything equal. In the first two the body weighs little
    enough that a calm body alone averages 0.57, under the 0.6 bias, while
    relaxing f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
2026-10-27 docs: architecture decision records
    Why sparkles is built the way it is, one file per decision: 27 records
    covering the mesh and firmware, the pi, calibration and the Muse headband,
    with an index and a template for the next one. Written in October 2026 from
    the code and the git history; decisions before May 2026 have their context
    reconstructed from the code.
2026-10-27 lamps: the shimmer falls off with distance, and boards update over the air one by one
    The shimmer's brightness now falls off from the centre: a falloff radius in
    metres (0 means the farthest board of the last calibration) and the
    brightness at that radius in % of the centre's (distanceEdge, 50 if
    missing), both on the MIDI page. The config a board gets carries the speed
    of sound the calibration used, so the delay effect turns distance back into
    the same time.
    The master holds the MIDI params in RAM only, so the pi now stores them
    (midi_params.json) and sends them again on every serial connect, and the
    master hands config and MIDI params again to a board that announces itself,
    since it may h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
2026-10-29 calibration: each batch reports its own boards, and the master waits for the pi
    With 103 boards in the field a distance calibration ran all six batches and
    said done, but the end looked stuck. Its results went out all at once, about
    30 KB in a fraction of a second, and the pi fell behind. After 50 ms of no
    progress the USB driver takes the host for gone and keeps only the newest
    4 KB, which cut boards 48 to 75 out of the middle.
    A distance calibration's board results now go out with their batch, right
    after its chirp_distance lines, so the end has only the done left to send.
    distance_result is gone, nothing read it. The driver's timeout is 500 ms
    instead of 50, so a hiccup on the pi no long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
2026-10-29 pi: read the master's serial port a chunk at a time, not a byte
    readline() fetches one byte per call and hands the GIL away between
    each, so whenever the event loop had work, the reader crawled. With one busy
    thread beside it, it read 65 of 600 board lines in 10 s, about 2 KB/s. The
    kernel then stopped taking data from the master, and the master's USB driver
    threw away what it held.
    The reader now takes everything waiting in one read and splits the lines
    itself; a line still arriving waits in the buffer for the rest, which also
    covers what the partial-line join did. The same 600 lines with the busy
    thread: all of them, in order, in 2.6 s.
2026-10-29 client: a careful battery reading at boot, and upload_client.py warns on it
    The battery was first read after the radio was up, 8 samples averaged, so a
    TX burst sagging the cell or one stray read (the zero after a wake) moved it.
    A client now measures at the very start of setup(), before the radio and the
    LEDs draw anything: 64 samples, the middle half averaged, on the same scale
    and curve as before. The boot blink uses that reading, and it goes out on
    serial at boot and again every second for the first 20 s, since after an
    upload the port only comes back once the board is through the reset.
    upload_client.py reads that line after each client upload and warns in
    yellow under 90% and in red u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
